LaphyB/senior-project/Documentation/IdeaFest/IMG_0757.jpg

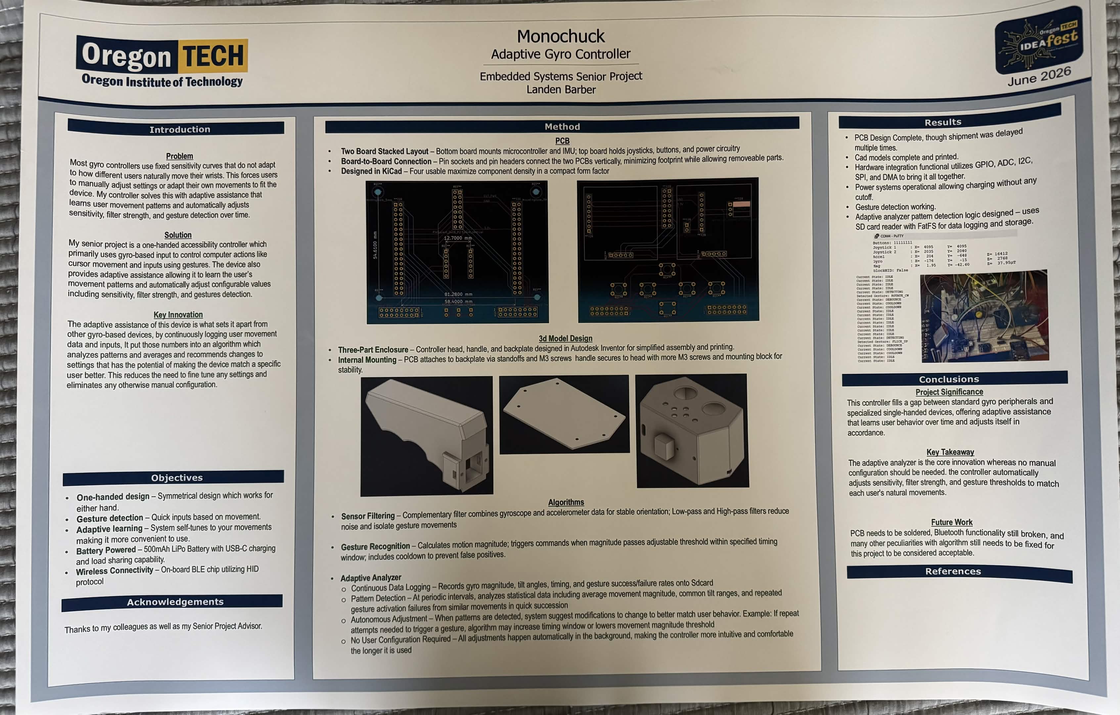
Documentation/IdeaFest/IMG_0757.jpg
