LaphyB/senior-project/README.md

# senior-project
Adaptive One-Handed Gyro Controller
