LaphyB/senior-project/Documentation/Requirements/Comparison Matrices.docx

## Comparison Matrices / Parts List

See Appendix A: Bill of Materials for complete parts list.

### Matrix 1 - Microcontrollers

Name | T-Energy S3 | STM32F411 BlackPill | Feather nRF52840 Express | Nucleo-WB15CC | Nucleo-F446RE
Manufacturer | Lilygo | Adafruit | Adafruit | STMicroelectronics | STMicroelectronics
Clock | 240MHz | 100MHz | 64MHz | 64MHz | 180MHz
Flash/RAM | 16Mb/8Mb | 512Kb/128Kb | 1Mb/256Kb | 320Kb/48Kb | 512Kb/128Kb
GPIOs | ~40 | ~40 | ~21 | ~48 | 50
USB-C | Yes | Yes | No (microUSB) | No (microUSB) | No(which is fine)
microSD | No | No (Yes if SPI) | No (Yes if SPI) | No (or SPI) | No (or SPI)
Wireless | Yes (2.4GHz) | No | Yes | Yes (2.4GHz) | No
Other | Integrated Rechargeable Battery | SOIC-flash memory ship support, No debugger | Built in LiPo charging circuit. | Built in debugger, well documented | Built in Debugger, well documented
Price | ≈ $10 | $29.95 | $24.95 | $35.60 | $14.85

This matrix compares several possible boards that could work for my project, whereas each board brings different inherent features. It is important to choose a board that has a balance of both size and functionality to remain as cheap as possible while having a safe amount of wiggle room for development. The T-Energy S3 is a board that has a battery attached though it has little to no documentation. The STM32F411 Black Pill is a simple board that doesn’t have much functionality but is easy to expand through the many GPIO ports, it does not have a debugger. The Feather nRF52840 Express is a good choice because it has built in LiPo charging as well as Bluetooth and a good amount of storage, though it has few GPIO pins which may limit functionality. The Nucleo-WB15CC is an STM board that includes base features like a debugger and Bluetooth built in, and enough SPI ports to expand on its small memory. I also have the Nucleo-F446RE board which is cheaper than the WB15CC with a faster clock and more interfaces to communicate with, but has a higher draw and does not feature a Bluetooth module inherently. At present the Nucleo-WB15CC board is the most well fit as external modules can be used to solve the battery power functionality and does not need an external Bluetooth module, the only problem is its size.

### Matrix 2 - Joysticks

Name | Analog 2-axis Thumb Joystick with Select Button + Breakout Board | Gravity: Joystick Module | Thumb Joystick
Manufacturer | Adafruit | DFRobot | Sparkfun
Voltage | Up to 5V | 5V | 3V
Control Pins | 3 | 1 | 3
Require ADC | Yes (2) | No | Yes
IC | Yes | Yes | No
Price | $5.95 | $5.30 | $5.25

This matrix highlights some possible thumb joysticks that could be used in the controller. The Analog 2 axis by Adafruit is one that comes with a breakout board allowing you to easily access its 2 axis control pins through a board’s ADC and one for the select button when you press it down. The gravity joystick is different in that it uses digital outputs not requiring and ADC to access. The third thumb joystick does not come with a breakout board which gives it a smaller profile and can run at a smaller voltage.

### Matrix 3 - BLEs

Name | Bluefruit LE SPI Friend | Bluefruit LE UART Friend
Manufacturer | Adafruit | Adafruit
Connection Type | SPI | UART
Other | Good documentation | Good documentation
Price | $17.50 | $17.50

This matrix compares some external Bluetooth modules that could be used to add wireless functionality to a board if it is limiting or excluded. The only difference between the Bluefruit SPI and Bluefruit UART is the connection type allowing either SPI or UART interface depending on the chosen IC.

### Matrix 4 - Haptic motors

Name | Mini Vibration Motors DC 3V 12000rpm Flat Coin Button-Type | Coreless Vibration Motors | DRV2605L Haptic Motor Controller
Manufacturer | Tatako | Zard zoop | Adafruit
Voltage | 1-5V | 1-6V | 3-5V
Control Pins | VCC, GND | VCC, GND | I2C
Size | 10mm x 3mm | 7mm x 25mm | 25.8mm x 17.8mm
Amount | 20pc | 6pc | 1
Price | $13.69 | $9.99 | 7.95

These are some choices for the haptic motor. The first two in this matrix don’t have specific names but the main difference between these two are the shape, whereas one is shaped like a coin and the other like a small rod. They are driven primarily by analog through the voltage given to it, different voltages will make it vibrate at higher frequencies. The DRV2605L on the other hand is a haptic motor that includes an IC controller so as to add more control over the motor rather than just controlling the voltage output. It connects to an I2C on a microcontroller and can handle more complex commands, allowing the motor to be controlled much more consistently. At present the 6 pack is the one being considered for its cheaper price.

### Matrix 5 - Charger Circuits

Name | PowerBoost 500C | PowerBoost 1000C | Sparkfun 5v LiPo Charger
Manufacturer | Adafruit | Adafruit | Sparkfun
Charge rate | 500mA | 1000mA | 500mA
Output | 500mA 5.2v | 1000mA 5.2v | 1000 mA 5v
Battery Protection | No | No | No
Price | $14.95 | $19.95 | 18.50

This matrix compares some possible charging circuit IC’s that could be used in order to supplement a microcontroller that does not inherently have one built in. These will work to power the board through the USB-C connector while simultaneously charging the battery, if the USB-C is disconnected, it will instead use the battery to power the board. Both the PowerBoost 500C and 1000C models could work because they have built in voltage boosters that allow a 3.7v battery to output 5.2v consistently. The difference is the amperage that it can charge or withdrawal from the battery connected through a LiPo port, ultimately charging at different speeds for a price difference. The Spark fun charger is similar but charges slower for a more stable output of one amp, it is also slightly smaller. The PowerBoost 1000c is the best fit because of the fast charging and an output of 5.2v, it is also the same brand as the chosen usb-c breakout board and is also more compatible with its voltage requirements.
