LaphyB/senior-project/Documentation/Requirements/New Requirements.docx

## Requirements

### 1. The controller shall support full operation with one hand.

One of the main features of the project is that it is one handed. Requires everything to be designed with this in mind.

#### 1a. The controller shall have a symmetrical layout to accommodate left- or right-handed use.

In order to accommodate an ambidextrous design, buttons, analog sticks, and casing design will have to be designed in a symmetric fashion.

### 2. The controller shall use gyroscopic data as its main input.

As this is a gyroscopic focused controller, th gyroscope should be the main source of input and everything needs to be designed around that as a core idea.

#### 2a The controller shall allow the gyroscope to be used as a mouse.

The movement of the gyroscope and orientation of the controller could be used to move the mouse for general use. A button should be added to allow for orientation pausing to allow for readjustment and movement not related to mouse input.

#### 2b. The controller shall support gestures using the on-board gyro and accelerometer.

To add another layer of input and accessibility, the movement of the controller should be considered and allow for gestures and movement to be a viable option of control over the system.

### 3. The controller shall monitor input and subtly change settings and suggest changes based on input history.

This adaptive helper will be implemented in software and slowly adjust settings over time, making the controller more intuitive and comfortable to use for specific users.

### 4. The controller shall include a software overlay to allow configuration.

An overlay like this is necessary to allow users to customize the functionality of the controller, including but not limited to key bind mapping, managing profiles, and changing settings. These things allow the controller to have critical flexibility for many use cases.

#### 4a. The controller shall have an inbuilt digital keyboard.

To allow for better general use, a digital keyboard will be built into the system overlay so that you could easily type using the joysticks and buttons.

### 5. The controller shall allow switching between different user-made profiles for different scenarios.

In order to support even more use cases, users will be able to create, save, and switch between different key profiles that may be used in different contexts, or different users.

### 6. All physical buttons and combinations shall be remappable via the system overlay.

To allow the most amount of usability and settings changes, users should be able to remap any physical button or joystick in order to adapt to individual needs and specific uses.

#### 6a. Buttons shall have settings to change base functionality.

Buttons will have various settings to help get the desired functionality of the user, for example some settings would be Hold for rapid press, hold for toggle, adjust button bounce strength, and have the ability to adjust timings. Helps with accessibility

### 7. The controller should be able to have any of the io functionality disabled.

For better customization and comfort any of the io interfaces, haptics, gyro, or features can be disabled to allow fr less error in making inputs.

### 8. The controller shall include a rechargeable battery enabling USB-C charging.

In order to support wireless functionality, a rechargeable battery will be essential for long term use and universal compatibility with USB-C cables for charging.

#### 8a. The controller shall include a battery level indicator via LEDs.

A visual indicator of the battery level ensures that users will know when the device will need to be charged. This will additionally show when the device is on or off.

#### 8b. The controller shall enter sleep mode after a time to save battery life.

To conserve battery life and health, the controller will automatically detect inactivity and enter a low power mode and wait for the user to come back. After further inactivity the controller will then shut off.

#### 8c. The controller shall last more than 8 hours of constant use, and at least 24 hours in sleep mode.

Battery life numbers to aim for to ensure a long use time.

While using, 500mAh Battery / 10mA draw average = 50 hours

Sleep mode, 500mAh Battery / <1mA draw average = 500 hours

STMicroelectronics. (n.d.). NUCLEO-WB15CC: STM32 Nucleo-64 development board. STMicroelectronics. Retrieved November 16, 2025, from https://www.st.com/en/evaluation-tools/nucleo-wb15cc.html

### 9. The controller shall be able to save, and load created profiles and settings from local storage.

To support requirement number 7, the controller will need a internal non-volatile storage in order to store and retrieve profiles and settings.

### 10. The controller shall support Bluetooth for wireless connections up to 5 meters.

To ensure compatibility with a wider range of devices, and for ease of use, Bluetooth functionality will be incorporated, offering wireless communication and may be essential for some with less mobility. Board uses 2.4GHz BLE.

STMicroelectronics. (n.d.). NUCLEO-WB15CC: STM32 Nucleo-64 development board. STMicroelectronics. Retrieved November 16, 2025, from https://www.st.com/en/evaluation-tools/nucleo-wb15cc.html

#### 10a. The controller shall automatically reconnect to the most recently paired device when powered on.

Also for ease of use, the controller will automatically detect and connect to the most recently paired device upon startup. This eliminated the need for users to manually reconnect every time the controller would be used streamlining the process.

#### 10b. The controller shall have usb-c compatibility when Bluetooth fails.

To account for hardware faults or for use when charging, the controller should be able to operate through USB-C connection alone, especially alongside being charged.

#### 10c. The controller shall have a pairing mode when holding a button.

This is standard for most controllers, as including a pairing mode via holding a button will allow the user to quickly and simply pair it to a device for Bluetooth communication.

### 11. The controller shall include haptic feedback.

In order to provide more functionality and more immersive experiences similar to a standard controller, an internal vibration motor will be included.

### 12. The controller shall survive a 2-meter fall and remain fully functional.

The controller must be built to withstand accidental drops and still be completely functional. This durability requirement is essential for long term usability, particularly for those with limited grip strength.

##### 12a. The controller will include a hand strap.

This addition will prevent the controller from reducing the risk of the controller slipping out of the user’s hand and breaking, this feature helps those with less grip strength and allows others to have a better grip over the controller.

### 13. The controller shall boot and be ready to use in under 3 seconds.

Quick startup is imperative for the user experience as they should not need to wait on the controller to use it. The controller must be able to load up a default profile and connect to a device upon startup and initialization. Board documentation claims full startup with BLE stack at 20-50ms.

STMicroelectronics. (n.d.). NUCLEO-WB15CC: STM32 Nucleo-64 development board. STMicroelectronics. Retrieved November 16, 2025, from https://www.st.com/en/evaluation-tools/nucleo-wb15cc.html

### 14. The controller should have less than 15ms response time for a wired connection, and less than 45ms response time for a Bluetooth connection.

For a streamlined user experience, we don’t want to have too much delay after you press a button. These numbers are based off of these sources explaining what input lag should be expected from a controller for optimal performance.

Intel. (n.d.). How to fix input lag. https://www.intel.com/content/www/us/en/gaming/resources/how-to-fix-input-lag.html

Ableton. (n.d.). Bluetooth headphones and latency in Note. https://help.ableton.com/hc/en-us/articles/6130134332188-Bluetooth-Headphones-and-Latency-in-Note
