LaphyB/senior-project/Documentation/Requirements/Requirements.docx

## Requirements

### Critical Requirements

#### 1. The controller shall support full operation with one hand.

This is the core purpose of this project as the controller is meant for individuals who may not have full use of both hands. If the controller cannot be comfortable and intuitive when used with one hand of either orientation, then the device has failed its primary objective.

To validate this requirement, I will ask various classmates and friends to simulate using the device with one hand and having them complete tasks as to receive their feedback.

#### 2. The controller shall be highly customizable.

This is important for expanding on the use cases of the controller and allow those he need slight adjustments to have easy access to how the controller works for them.

For validation, settings could be tested live to make sure that they are working on the fly and as intended.

#### 3. The system shall include an overlay for configuration and troubleshooting.

An overlay like this is necessary to allow users to customize the functionality of the controller, including but not limited to key bind mapping, managing profiles, and changing settings. These things allow the controller to have critical flexibility for many use cases.

To validate this requirement, the overlay should be opened on multiple systems to test whether it has full functionality in changing settings on a variety of devices.

##### 3a. The controller shall have an inbuilt digital keyboard.

To allow for better general use, a digital keyboard will be built into the system overlay so that you could easily type using the joysticks and buttons.

##### 3b. The controller shall monitor input and subtly change settings and suggest changes based on input history.

To take further advantage of the onboard settings and adaptability, the controller will monitor the inputs of the user and suggest changes based on a usage heatmap, and input history.

#### 4. The controller shall support various platforms including Windows, Xbox, and PlayStation.

The ultimate goal of this project is to be as versatile as possible without the use of third-party software. And to accomplish this, the controller will need to be natively compatible with various common systems in order to maximize usability and prevent it from being limited to a single ecosystem.

To verify this, the controller should be able to connect and communicate with a variety of systems and test its functionality as an input device.

### Design and User Interface

#### 5. The controller shall include a modular backplate for left- or right-handed use.

To support a wider range of users, the controller will be designed with this feature in mind to ensure the controller can comfortably fit a variety of hand sizes on either orientation. The backplate must be attached securely and align with internal components to allow both functionality and comfort.

##### 5a. The controller shall have a symmetrical layout to accommodate left- or right-handed use.

In order to accommodate an ambidextrous design, buttons, triggers, and analog sticks will have to be designed in a symmetric fashion.

#### 6. The controller shall include tactile markers to help distinguish similar-feeling buttons.

This is a feature that is small but can have a considerable difference for ease of use and would decrease the likelihood of making input errors.

#### 7. The controller shall allow switching between different user-made profiles for different scenarios.

In order to support even more use cases, users will be able to create, save, and switch between different key profiles that may be used in different contexts.

##### 7a. The controller automatically switches between profiles when switching contexts.

To make the controller more usable, the controller will automatically detect applications and switch to the appropriate profile rather than forcing the user to do it manually.

#### 8. All physical buttons and combinations shall be remappable via the system overlay.

To allow the most amount of usability, users should be able to remap any physical button or joystick in order to adapt to individual needs and specific uses.

##### 8a. Buttons shall have settings to change base functionality.

Buttons will have various settings to help get the desired functionality of the user, for example some settings would be Hold for rapid press, hold for toggle, adjust button bounce strength, and have the ability to adjust timings.

#### 9. The controller should be able to have any of the io functionality disabled.

For better customization and comfort any of the io interfaces, haptics, gyro, or features can be disabled to allow fr less error in making inputs.

#### 10. The controller shall support integrated chorded input.

As the controller will undoubtedly have limited physical buttons due to size constraints, this will allow for much more input versatility which is crucial for one handed support.

##### 10a. The controller shall include a button to either toggle or enable chorded input when pressed.

This feature will allow the user to more easily use chorded input alongside standard input, maximizing the number of usable buttons. Choosing between toggle and hold would be done within the system overlay.

#### 11. The controller shall have custom macro support.

To make more advanced sequences of button presses more usable, macros can be recorded and edited within the system overlay. These macros can be bound to different buttons or gestures for easy activation.

#### 12. The controller shall support gestures using the on-board gyro and accelerometer.

To add another layer of input and accessibility, the movement of the controller should be considered and allow for gestures and movement to be a viable option of control over the system.

##### 12a The controller shall allow the gyroscope to be used as a mouse.

The movement of the gyroscope and orientation of the controller could be used to move the mouse for general use. A button should be added to allow for orientation pausing to allow for readjustment and movement not related to mouse input.

##### 12b The controller shall allow gestures to be mixed and matched in the settings.

Gestures will be supported with deep settings support to allow for some gestures while ignoring other. You should also be able to change the sensitivity, speed, and tremor/haptic filters.

### Functionalities and Operational Conditions

#### 13. The controller shall include a rechargeable battery enabling USB-C charging.

In order to support wireless functionality, a rechargeable battery will be essential for long term use and universal compatibility with USB-C cables for charging.

##### 13a. The controller shall include a battery level indicator via LEDs.

A visual indicator of the battery level ensures that users will know when the device will need to be charged. This will additionally show when the device is on or off.

##### 13b. The controller shall enter sleep mode after a time to save battery life.

To conserve battery life and health, the controller will automatically detect inactivity and enter a low power mode and wait for the user to come back. After further inactivity the controller will then shut off.

##### 13c. The controller shall last more than 8 hours of constant use, and at least 24 hours in sleep mode.

Battery life numbers to aim for to ensure a long use time.

While using, 500mAh Battery / 10mA draw average = 50 hours

Sleep mode, 500mAh Battery / <1mA draw average = 500 hours

STMicroelectronics. (n.d.). NUCLEO-WB15CC: STM32 Nucleo-64 development board. STMicroelectronics. Retrieved November 16, 2025, from https://www.st.com/en/evaluation-tools/nucleo-wb15cc.html

#### 14. The controller shall be able to save, and load created profiles and settings from local storage.

To support requirement number 7, the controller will need a internal non-volatile storage in order to store and retrieve profiles and settings.

#### 15. The controller shall support Bluetooth for wireless connections up to 5 meters.

To ensure compatibility with a wider range of devices, and for ease of use, Bluetooth functionality will be incorporated, offering wireless communication and may be essential for some with less mobility. Board uses 2.4GHz BLE.

STMicroelectronics. (n.d.). NUCLEO-WB15CC: STM32 Nucleo-64 development board. STMicroelectronics. Retrieved November 16, 2025, from https://www.st.com/en/evaluation-tools/nucleo-wb15cc.html

##### 15a. The controller shall automatically reconnect to the most recently paired device when powered on.

Also for ease of use, the controller will automatically detect and connect to the most recently paired device upon startup. This eliminated the need for users to manually reconnect every time the controller would be used streamlining the process.

##### 15b. The controller shall have usb-c compatibility when Bluetooth fails.

To account for hardware faults or for use when charging, the controller should be able to operate through USB-C connection alone, especially alongside being charged.

##### 15c. The controller shall have a pairing mode when holding a button.

This is standard for most controllers, as including a pairing mode via holding a button will allow the user to quickly and simply pair it to a device for Bluetooth communication.

#### 16. The controller shall include haptic feedback.

In order to provide more functionality and more immersive experiences similar to a standard controller, an internal vibration motor will be included.

##### 16c. The controller shall have a pairing mode when holding a button.

Haptic feedback will be able to be configured in the system overlay to allow for changes in haptic patterns and strength.

#### 17. The controller shall include a gyroscope.

To provide more functionality and another way to input data into the controller, the orientation of the device could be used to allow gesture commands to do basic tasks as another way to input. Directly related to requirement 12.

#### 18. The controller shall survive a 2-meter fall and remain fully functional.

The controller must be built to withstand accidental drops and still be completely functional. This durability requirement is essential for long term usability, particularly for those with limited grip strength.

##### 18a. The controller will include a hand strap.

This addition will prevent the controller from reducing the risk of the controller slipping out of the user’s hand and breaking, this feature helps those with less grip strength and allows others to have a better grip over the controller.

#### 19. The controller shall boot and be ready to use in under 3 seconds.

Quick startup is imperative for the user experience as they should not need to wait on the controller to use it. The controller must be able to load up a default profile and connect to a device upon startup and initialization. Board documentation claims full startup with BLE stack at 20-50ms.

STMicroelectronics. (n.d.). NUCLEO-WB15CC: STM32 Nucleo-64 development board. STMicroelectronics. Retrieved November 16, 2025, from https://www.st.com/en/evaluation-tools/nucleo-wb15cc.html

#### 20. The controller should have less than 15ms response time for a wired connection, and less than 45ms response time for a Bluetooth connection.

For a streamlined user experience, we don’t want to have too much delay after you press a button. These numbers are based off of these sources explaining what input lag should be expected from a controller for optimal performance.

Intel. (n.d.). How to fix input lag. https://www.intel.com/content/www/us/en/gaming/resources/how-to-fix-input-lag.html

Ableton. (n.d.). Bluetooth headphones and latency in Note. https://help.ableton.com/hc/en-us/articles/6130134332188-Bluetooth-Headphones-and-Latency-in-Note
