LaphyB/senior-project/Documentation/Deliverables/Critical Design Discussion/Critical Design Discussion Script.rtf

1
Hello, this is my critical design presentation for senior project.

2
My project is a one-handed accessibility controller which primarily uses gyro-based input to control things like cursor movement and inputting gestures.
These cursor movements and actions are triggered through natural motions like tilting rotating, or flicks. By mapping these movements into actions, it allows those with less fine motor control to activate buttons or macros that would otherwise be difficult to press on the smaller buttons.
From the rough drawing on the right, you can see that the controller will be of a vertical format and will be symmetrical so as to support left or right-handed use.
To help configure a device, the device will also provide adaptive assistance allowing it to learn the user’s movement patterns and automatically adjust sensitivity, filter strengths, and gestures. These types of adjustment will make the controller more convenient to use as it improves the one-handed comfort and be more reliable over time.
Though if you also want to change some of these settings yourself, there will also be an on screen overlay to customize button mappings and other settings to the user’s preference.

3
Going right into the hardware, there are a few big things that need to be considered for the initial design of the controller, including battery charging and Bluetooth functionality as the controller should be wireless.
The microcontroller that I chose was the STM32 Nucleo-WB15CC because of its built in Bluetooth chip and low power functionality.
To add on the battery and charging functionality, parts like a usb-c breakout board and power boost 1000c charging circuit were chosen for its ability to automatically switch between exterior power supply or battery supply for continuous use, and its ability to boost a 3.7v battery to 5v to power the board.
The gyro I will be using is the TDK invensense ICM -20948 for its combined gyroscope, accelerometer, and magnetometer, being able to communicate that data through I2C or SPI connections.
Lastly these are of course joysticks, buttons, and haptic motors to supplement the basic functionality of a controller, and a status led to show the power status of the controller.

4
Here I have a circuit diagram to show the layout of how things will be wired up. At the top half of the diagram is the power circuit which starts with the USB-C breakout board allowing data and power lines to be split up and fed into the MCU and charging circuit respectively.
The Nucleo-WB15CC itself has plenty of GPIO pins that I can use for various buttons and control pins, 10 of which have ADC capability which is more than enough for the axial inputs of the joysticks.

5
Regrettably I still don’t have any CAD drawing yet, part of the reason for this is because I don’t really know where to start on a more complex shape like this, but something I decided to do recently is create a 2 layered PCB for the internals to connect the internal parts together. Once I have this interior part designed generally with more precise measurements, it will be much easier to design the casing of the controller which will use a curvier design for ergonomics

6
Now onto the software design aspect of this project, the basic flow of the data starts with some input managers which each read or receive data from various different input methods such as GPIO, ADC, and I2C will each need different implementations to read from.
The Gyro Manager, for example, needs to handle the I2C communication. It also needs to choose and apply various filters on the gyroscopic data so that it is more usable with regards to different sensitivity modes and gesture detection. I will go over the gesture filters a little more in a later slide.
But after this input data is collected and filtered. It is then processed in an input decoder to allow combinational logic and utilize profile settings like key binds to know which outputs need to be sent to a connected device.
It does this by using a communications manager to recognize which protocol to use when sending data, whether its to send it over a Bluetooth connection or if its connected via usb-c

7
And for the other functions of the device, there will be an overlay interface which provides the functionality for editors for different settings.
The overlay stores these settings in an SQLite database for nonvolatile storage,
And the profile selector uses these saved settings from the database to change certain parameters and key binds depending on the context.
Another use of the database is to store input history data collected by the adaptive helper function in order to run calculations on that data to figure out what kind of changes should happen.

8
To help give you a better understanding of what the gyro’s role in input has, here are some of the algorithms that it may use.
One of the important functions of the gyro will be the ability to recognize which filters to use and when a gesture is trying to be activated. The gyro algorithm will start by using the magnitude to adaptively switch between low sensitivity and high sens modes to differentiate between when the user is trying to use precise movement to press something of a screen, quicker movement when trying to move the cursor further distances, and faster movement when the user is trying to activate a gesture.
Some filters that help in these implementations is the LPF which eliminates smaller discrepancies, a complementary filter which uses multiple gyro inputs to smooth movement and got more precise tracking. And high pass filters which are useful in tracking sudden changes like gestures.

9
The adaptive helper also requires an algorithm which can somehow utilize data and convert it into action. It would start by collecting an input history in the database where it can use that data later to calculate average magnitudes, common tilt angles, and timing between presses.
Using these number the controller can predict when a movement is trying to activate something like a gesture but misses because it was not fast enough, if it happens somewhat often, it will increase the interval that a gesture needs to activate to hopefully reduce the likelihood of this mistake happening again.

10
Here are a few basic libraries I expect to use for this project, like the STM32 Hal commands for GPIO, ADC, and I2C communication. STM32 middleware for the Bluetooth stack, or usb communication. And drivers for the gyroscope to format data properly and know which memory locations to read from.

11
And as far as progress goes, regrettably, I haven’t gotten too far into the testing yet, though some things I have done was get the board programmed to work with its GPIO pins and I2C communication, even if I haven’t yet gotten correct data from the gyro yet. and have tested the basic charging functionality to charge the battery and make sure it can properly output power at 5v.

12
Here are just some resources for some datasheets and algorithms.

13
And that’s all I have, any questions?

How much storage on device?
320KB flash
