LaphyB/senior-project/Documentation/Deliverables/Design Review/Design Review Script.docx

Slide 1

Hello, welcome to my presentation on my senior project idea and design. Through this presentation I hope to give you a better understanding of what my project idea is and the goals I hope to accomplish by working on it. I will start by going through a brief introduction to the project, estimating the costs, and comparing it with other products that exist on the market already. I will then talk about the hierarchy of my design and talk more in detail about the features it should have as well as the components I chose to accomplish them. I will then finish off by talking about my progress so far and what my next steps will be.

Slide 2

First of all, my project is a one-handed accessibility controller designed to provide more input options and accessible control over any other controller on the market. What makes this controller special will be the highly customizable nature and vertical form factor that other controller producing companies leave nearly untouched. It will also be compatible with various systems without the need for installed software, other than the companion app to change settings.

Slide 3

To start off with the details of this project, here is a list of components and the total cost of them combined. These are the most important parts of the project and will cost around $118.63 excluding shipping. I will talk a little more about these parts and the features they give later.

Slide 4

Some other costs that may come into play relate to non-recurring costs, prototyping specific, and production related costs. I estimate that the 3d printed prototypes will cost around 150 dollars. I assume that it will take 100 hours to develop, and with a rate of 25 dollars an hour than totals up to 2500 dollars. I expect to need 14 molds in order to make a single product, at 3000 per mold that comes to 42000 dollars total. And if it takes 1 and a half hours to make a product from a laborer making 18 dollars an hour, it will cost 27 dollars. In total divided by the creation of 1000 units of product each controller would cost around 190.27. Compared to other products on the market, this price is actually reasonable as the ones that I have found go well above 200 dollars.

Slide 5

One such product is this Azeron controller, which is an accessibility controller meant for people with one hand. Though on paper this is similar to my project, there are some big differences. One big one is the form factor, as azeron acts more like a mouse than a gamepad, forcing the product to work exclusively on computers rather than game consoles. A common price for a product like this is around $220

Slide 6

Another similar product is the Twiddler, though it is a one-handed device, it is not purpose built for accessibility, rather it is built to be a one-handed chorded keyboard intended for typing speed and is not ambidextrous. Coming in at 229 dollars, this product both reaches a completely different market and costs more than what my controller would cost.

Slide 7

The last comparison I will make are these 3d printed addons that could be added to a game controller. These are usually more mechanically advanced and are cornered by the software meant for the gamepad controller. These can come at a good price even if you do not own a 3d printer, and are the cheapest you could get for a one handed controller.

Slide 8

Now to start going over the design of the project I will start at the top level. Though it may be a little hard to see, this is the top-level diagram that includes both hardware and software components. I have it split up into two parts so I will start at the bottom 3 quarters which defines the controller portion which incorporates the board as well as all the parts that would be held within the controller housing. These are all the things that the controller would need to operate independently.

On the top quarter I have the companion app which is intended to be used to change any number of settings, or key binds when plugged into a computer.

Slide 9

Here is the block diagram that explains the software side of this project. Starting at the bottom, I have various input managers to test for inputs from the many buttons, joysticks, and even one dedicated to the gyroscope/accelerometer. Each input has different requirements to read from, the joysticks for example need ADC inputs while the gyro uses internal ADC’s that transmit to a digital input to the board. The controller also utilizes a profile selector to recognize connected software and systems and exchange key binds and settings that would be configured to the user’s preference. The last notable piece I will mention is that both the app and controller use a communication manager to know how to communicate with a system they are connected to and also switch between either a Bluetooth or USB-C connection depending on the circumstance.

Slide 10

Lastly here is the block diagram for the hardware, starting at the top is the USB-C connector board, this splits the data and power lines in order to allow the functionality to play thorough the cord while charging, or wirelessly when on battery power. The data lines of course would go to the board while the power lines would enter the charging circuit that shares the load between the microcontroller and the battery, enabling it to charge while in use. When disconnected from the cable though, the controller would be powered by the battery and would be boosted up to 5 volts for the board to have enough power. That was the most notable piece to mention but I will also point to how the board will control all the other modules like the haptic motors, gyro, and even the led indicator, which can tell the battery life remaining by the voltage it receives or by another cable that the circuit can output.

Slide 11

When we put all these pieces together, this is what it will generally look like, though some things are subject to change, I have put some thought into how it should be laid out. For one the handle would be raised above the surface with the buttons to allow for more ergonomics and easier control over the joysticks. The controller is drawn with a right side backplate showcasing the ability to add buttons that could be controlled by the right hand. There is also an adjustable strap that wouldn’t be so long but would be useful for grip. Something not shown though this picture is the layout of the shoulder and trigger buttons on the back.

Slide 12

Now here is a more detailed drawing of the inside layout of the controller featuring a few layers that the components would sit on. The top left drawing holds the base plate which holds various pieces like the microcontroller board and USB-C on the front. To access the backside, there is a hole punched through to give access to the charging circuit, battery, and trigger buttons. Next on the left is a standoff piece that would attach to the base plate and hover atop the board in order to position the buttons and joysticks to keep them secured to the frame. The gyro is also tucked in with the wiring able to flow straight to the microcontroller.

Slide 13

Here is another angle of the controller to help reiterate the kind of functionality to expect. The controller will have 2 analog sticks, 16 remappable buttons including the ones on the backplate. It will also have a gyroscope for orientation control, and haptic feedback. The final product should be within the range of a 4in x 9in design and be able to go past 8 hours of constant use without any issues, even when using Bluetooth from over 5 meters since ease of use and comfort is one of the bigger priorities of the project.

Slide 14

I won’t go too deeply into the requirements in this presentation but I have them listed out here so you could go back and look though them if you wanted, but in the case of what I have designed, many of these requirements are used in reference to the design choices I have made. Of these 3 important requirements, one-handed use is the most important.

Slide 15

These next requirements are those related to the general functionality of the controller, many of which relate to the software portion. Some requirements of note needed for the physical design process include tactile markers, and a modular backplate.

Slide 16

Lastly these are requirements needed for the controller to function or operate in the way that is expected. Most of these were important for the design process but the most important / difficult to implement so far were the addition of Bluetooth, orientation and haptic functionality, and of course having a rechargeable battery while in use.

Slide 17

Now I will delve a little deeper into the reason why I chose the components that I did and why I wanted to do them this way.

Slide 18

To start with the most important decision was choosing which microcontroller to use. This was one of the harder decisions I had to make because it would also affect what other kinds of components I would need to supplement the functionality that I want. For example, some boards would have Bluetooth, some would have an integrated charging circuit, or USB-C on board, and not many were small enough, but few had all four so some compromises had to be made.

Slide 19

Ultimately, I ended up choosing the Nucleo-WB15CC from STM for its inherent Bluetooth functionality and its many gpio pins that would give me plenty of wiggle room for more buttons and other I/O. Something that may be an issue is the dimensions of the board, though if I am clever with the design it should fit into the controller well. Like many current age boards, it does not have inherent USB-C or even an integrated LiPo port, but with SPI and various power rails, other options are available.

Slide 20

In order to cover these short-sightings of the nucleo board, I had to choose other components that would give me the other functionality that I require. Two of these are the addition of a USB-C breakout board and the PowerBoost 1000C to provide the connection and charging functionality I went over earlier.

Slide 21

A component I haven’t really mentioned yet is the choice of the 500mAh LiPo battery, I originally planned on using a 1000mAh battery but because it was both larger, and out of stock, I decided to use the 500mAh battery because it should still hold enough to last for over 8 hours with the low power board I chose. Lastly, I also chose this InvenSense gyro because it was one of the cheaper options for a less important feature, it works for this project though because of its digital output from the onboard ADC’s.

Slide 22

As for software, since I am using a stm board, the stm32cubeIDE is natively supported and is the best choice for this project. For the companion app though I may use VSCode instead since stm is based on eclipse. Of course, I will also be saving all the code onto the GitLab I have already set up.

Slide 23

Now onto the last part of this presentation, being the work I have done so far and my next steps. At the current stage I have done much more discovery and planning of parts that I would need rather than implementing anything. Recently though, I have finally ordered most of the important parts that I would need, and they should arrive within the next few days.

Slide 24

And According to my schedule I am on track and should start preparing to receive these parts once I do, I can begin by setting up the board and using it to test the individual functionality to make sure everything is working as intended. By the start of winter term, I would also like to have started on the driver code and have the parts measured more accurately so that I can get started on the 3d modelling which both tasks will take up most the time in winter term.

Slide 25

Anyway, thank you for listening, I hope that this presentation has helped you to understand what my project will entail and how I will accomplish these goals.
