LaphyB/senior-project/Documentation/Deliverables/Initial Test Plan/Design Progress.docx

Discovered that WB15CC microcontroller is missing usb export pins, even though it has the functionality in the chip. This makes it impossible to control through the usb-c cable. The WB55RG model solves and has the same layout, but instead of buying a new microcontroller I will be using Bluetooth functionality exclusively for connection. Chargin capabilities are unaffected, however.

SQLite is unnecessary, for this project it may be much more ram and storage efficient to store things smaller binary files. Overhead is not necessarily needed and storage is limited, also adds more complexity that is not worth it.

#### Gyro Algorithm

Inputs: Gyroscope data (raw X, Y, Z axis data from ICM20948)

Output: Cursor movement delta (change in x, y pixels), can later be sent using HID over Bluetooth

Usage: The main gyro function which controls the cursor movement of the mouse using the gyroscope.

Function:

- I2C places data into a register automatically.
- Using these values, we first convert it into a usable format (degrees/second) by dividing by sensitivity scale.
- Apply deadzone threshold to discard bad data and reduce drift.
- Apply low pass filter (using alpha value) to smooth jittery movement and reduce noise.
- Apply user configurable sensitivity settings (multiplier to control movement speed).
- Apply mouse acceleration curve for small(1x) or large (2x-3x) movements
- Calculate cursor delta using

dpixels = angular_velocity_dps x time_delta_sec x sensitivity

- Clamp delta values to +-127 pixels as per HID protocol limit
- Package dX and dY into HID mouse report structure
- Send to host PC over bluetooth
- Host receives mouse report and moves cursor by specific xy pixel values.

#### Gesture Recognition

Inputs: Gyroscopic data (angular velocity), Accelerometer data (linear acceleration), Timestamp (ms)

Output: Commands Enum (FLICK_LEFT, FLICK_RIGHT, FLICK_UP, FLICK_DOWN, ROTATE_CW, ROTATE_CCW etc.

Usage: Using ICM data, detect quick movements and detect when a user is trying to activate a gesture.

Function:

- Read data values from gyro register
- Calculate motion magnitudes using

Magnitude = sqrt(gyro_x^2 + gyro_y^2 + gyro_z^2)

- If magnitude exceeds threshold, enter a detecting state, else stay idle
- If detecting, record starting timestamp, track hishest magnitude during time window
- If movement exceeds timeout then return to idle
- When magnitude falls below threshold, end gesture and take note of which axis has the highest values
  - X-axis = for positive, FLICK_LEFT or for negative, FLICK_RIGHT
  - Y-axis = for positive, FLICK_UP or for negative, FLICK_DOWN
  - Z-axis = for positive, ROTATE_CW or for negative, ROTATE_CCW
- Apply cooldown period to prevent double triggers
- Apply debounce period to ignore correcting movement after gesture
- Return gesture type to program for command execution
- If idle, can return GESTURE_NONE

#### Adaptive Analyzer

Input: Historical movement data, current user settings

Output: Commands to adjust system settings

Usage: Function runs periodically to watch values and make decisions to change settings that will make controller more reliable.

Function:

- As data is collected in a buffer file with configurable max amount, contains timestamp, gyro, joystick, button values, and the reason why it was added to buffer (like gesture activated so making note)
- Using previous data
- Calculate success rates and repeated failure rate
  - Calculate gyro magnitudes for all records, divided by num
  - Calculate gesture success rate with gesture attempt flag
  - Count rapid repeated failures if within a short amount of time
- Check to see if changes should be made
  - If magnitude less than threshold, and gesture success rate less than 50%: lower gesture threshold.
  - If gesture threshold less than 30%: increase gesture timeout .
  - If rapid failures in short succession are detected: increase sensitivity and lower gesture threshold.
- Check setting bounds for wanted adjustment
- Check if change is allowed to be made (configurable)
- Apply changes to settings (no reboot needed)
- Add change to change log
