LaphyB/senior-project/Documentation/Deliverables/Other/Updated Proposal.docx

Monochuck

A new form factor to a one-handed controller

Landen Barber

11-25-2025

Oregon Institute of Technology

Approval of Signature

Student

X

Name: Landen Barber

Date :

Project Adviser

X

Name: Ganghee Jang

Date:

# Summary

This document provides a description of my senior project and what it will entail. For my senior project I will design a one-handed accessibility controller aimed at expanding on the limited number of input options that a one-handed controller may have. What makes this controller special will be the highly customizable nature and vertical form factor that other controller producing companies leave nearly untouched. It will also be compatible with various systems without the need for installed software, other than the companion app to change settings. There are a few central challenges to making this type of controller and many things to consider. Alongside the normal challenges like battery life, size constraints and connectivity/support for different applications, a one-handed controller is unique in that the physical number of inputs that can be implemented is cut short. To combat this the controller will feature chorded input to supplement the number of inputs possible and will have a swappable backplate to add more functionality to suit the users preference. Overall, the goal of this project is to have an intuitive one-handed controller that is easily adjustable to a variety of hand sizes and mobile limitations and aims to empower users with limited mobility to providing a device capable of connecting them to their machine.

As the controller will have both chorded input and contextual profile switching, the controller will come with an app to install firmware, remap buttons, change settings, as well as customize profiles in order to better support the adjustability of the controller. These customizable features will be supported with real time visualization of inputs on the app with options to turn off certain inputs or by adding more through swapping different backplates. The controller will also be able to be used either wirelessly or wired with seamless transitions between USB-C and Bluetooth.

Throughout this document I will start by looking at the background of some other popular options for accessibility controllers as well as one that is very similar to my own and explain what makes mine different. I will then describe my timeline as well as the challenges and ways to mitigate and handle them. Finally, I will talk about the requirements that the final product should include.

# Background

Traditionally, controllers are designed for those with full use of both hands. While the standard controller can work for the majority of people, it can provide a barrier to those with disabilities or limited mobility. As Accessibility is becoming a more prominent aspect within technological and gaming spheres, there is a growing need for inclusive and specialized hardware. But, despite efforts by various companies, there remains a limited selection of intuitive, one-handed controllers that are compatible with many applications and games.

There are several previous technologies that have attempted to solve this problem before, but each comes with their own tradeoffs. One approach is the Azeron gaming keypad, which effectively acts like a mouse with finger actuated input. The mouse input on the controller allows for more precise aiming and works well with a computer system, it also comes with extensive customization options. Another approach that is very similar is the Twiddler. The twiddler is a one-handed keyboard that includes chorded input. The biggest problem with this is that it is meant for typing and is primarily meant for use by a tablet or other mobile device via Bluetooth. Both of these products demonstrate different aspects that I would like to bring together in order to create a more suited device toward gaming. There have also been attempts of at home solutions like 3d printed additions to your base controllers that move many of the buttons to one side, though these solutions are usually heavier and more clunky.

# Comparisons with Existing Approaches

## Twiddler

The twiddler is a one-handed chorded keyboard device made by a company called Tek Gear, Inc. While both my project and the Twiddler use chorded input within a one-handed form factor, the purpose and audience for each one differ fundamentally. Twiddler controllers are optimized for entering text quickly and efficiently and are not aimed toward those with disabilities. To lay out all of the differences, Twiddler keyboards have 12 keys, some are remappable while some are not, an optical mouse touchpad, Bluetooth capable, but is not ambidextrous, has no haptic feedback, and is primarily meant for a niche text-entry focused audience. The twiddler is sold for 229 dollars retail and excels at being highly portable and highly programmable. Some weaknesses of this design though it that it has a steep learning curve and is not optimized for general use or accessibility.


## Azeron


Azeron controllers are one-handed programmable gaming keypads designed primarily for PC gamers who want a smoother gaming experience with easily accessed inputs meant for use by those with one hand. This controller has an analog thumb stick, 26 programmable buttons, and an optical mouse sensor. It also has finger actuators to allow another degree of freedom. The strength of this controller is that it excels at general PC use and gaming, as well as being highly customizable to suit a specific purpose. A big downside to this controller though is that since it is more related to keyboards and mice, they are meant to be used mainly for PC’s and are not compatible with many other systems. Another downside of this device is its cost as it sells for around 220$ most likely due to its many moving pieces and actuators.

## 3d Modeled Addons


The simplest and cheapest approach to this need for a one-handed controller is one of the many designs of 3d printed models that could be attached to a normal gamepad controller. These are very low cost and build on the pre-built functionality and software that a normal gamepad has already. These are good options for those with access to a 3d printer, but even if you don’t have a 3d printer they are still easy to find online. Some problems with this design though is that it can be difficult to assemble, and makes the controller more clunky and only adds to the weight of a controller meant for 2 hands.

## Xbox Adaptive Controller

Though not very related to my project, another popular choice for those with disabilities is the Xbox adaptive controller; this is a flat controller that has few buttons but has many inputs. Unlike other controllers, it functions as a brain that many other accessibility devices can be connected to and be used in conjunction with each other by providing an interface for people who are less tech savvy and need to set up multiple devices. This device is one of the strongest for being highly expandable and gives a lot of accessibility support. A big downside of this controller though is that it requires that you have other devices on hand in order to make full use of it, it is also quite big and is not very portable as it should be mounted to something like a desk or a wheelchair.


# Comparison Matrices

## Matrix 1 - Microcontrollers

Name | T-Energy S3 | STM32F411 BlackPill | Feather nRF52840 Express | Nucleo-WB15CC | Nucleo-F446RE
Manufacturer | Lilygo | Adafruit | Adafruit | STMicroelectronics | STMicroelectronics
Clock | 240MHz | 100MHz | 64MHz | 64MHz | 180MHz
Flash/RAM | 16Mb/8Mb | 512Kb/128Kb | 1Mb/256Kb | 320Kb/48Kb | 512Kb/128Kb
GPIOs | ~40 | ~40 | ~21 | ~48 | 50
USB-C | Yes | Yes | No (microUSB) | No (microUSB) | No(which is fine)
microSD | No | No (Yes if SPI) | No (Yes if SPI) | No (or SPI) | No (or SPI)
Wireless | Yes (2.4GHz) | No | Yes | Yes (2.4GHz) | No
Other | Integrated Rechargeable Battery | SOIC-flash memory ship support, No debugger | Built in LiPo charging circuit. | Built in debugger, well documented | Built in Debugger, well documented
Price | ≈ $10 | $29.95 | $24.95 | $35.60 | $14.85

This matrix compares several possible boards that could work for my project, whereas each board brings different inherent features. It is important to choose a board that has a balance of both size and functionality to remain as cheap as possible while having a safe amount of wiggle room for development. The T-Energy S3 is a board that has a battery attached though it has little to no documentation. The STM32F411 Black Pill is a simple board that doesn’t have much functionality but is easy to expand through the many GPIO ports, it does not have a debugger. The Feather nRF52840 Express is a good choice because it has built in LiPo charging as well as Bluetooth and a good amount of storage, though it has few GPIO pins which may limit functionality. The Nucleo-WB15CC is an STM board that includes base features like a debugger and Bluetooth built in, and enough SPI ports to expand on its small memory. I also have the Nucleo-F446RE board which is cheaper than the WB15CC with a faster clock and more interfaces to communicate with, but has a higher draw and does not feature a Bluetooth module inherently. At present the Nucleo-WB15CC board is the most well fit as external modules can be used to solve the battery power functionality and does not need an external Bluetooth module, the only problem is its size.

## Matrix 2 - Joysticks

Name | Analog 2-axis Thumb Joystick with Select Button + Breakout Board | Gravity: Joystick Module | Thumb Joystick
Manufacturer | Adafruit | DFRobot | Sparkfun
Voltage | Up to 5V | 5V | 3V
Control Pins | 3 | 1 | 3
Require ADC | Yes (2) | No | Yes
IC | Yes | Yes | No
Price | $5.95 | $5.30 | $5.25

This matrix highlights some possible thumb joysticks that could be used in the controller. The Analog 2 axis by Adafruit is one that comes with a breakout board allowing you to easily access its 2 axis control pins through a board’s ADC and one for the select button when you press it down. The gravity joystick is different in that it uses digital outputs not requiring and ADC to access. The third thumb joystick does not come with a breakout board which gives it a smaller profile and can run at a smaller voltage.

## Matrix 3 - BLEs

Name | Bluefruit LE SPI Friend | Bluefruit LE UART Friend
Manufacturer | Adafruit | Adafruit
Connection Type | SPI | UART
Other | Good documentation | Good documentation
Price | $17.50 | $17.50

This matrix compares some external Bluetooth modules that could be used to add wireless functionality to a board if it is limiting or excluded. The only difference between the Bluefruit SPI and Bluefruit UART is the connection type allowing either SPI or UART interface depending on the chosen IC.

## Matrix 4 - Haptic motors

Name | Mini Vibration Motors DC 3V 12000rpm Flat Coin Button-Type | Coreless Vibration Motors | DRV2605L Haptic Motor Controller
Manufacturer | Tatako | Zard zoop | Adafruit
Voltage | 1-5V | 1-6V | 3-5V
Control Pins | VCC, GND | VCC, GND | I2C
Size | 10mm x 3mm | 7mm x 25mm | 25.8mm x 17.8mm
Amount | 20pc | 6pc | 1
Price | $13.69 | $9.99 | 7.95

These are some choices for the haptic motor. The first two in this matrix don’t have specific names but the main difference between these two are the shape, whereas one is shaped like a coin and the other like a small rod. They are driven primarily by analog through the voltage given to it, different voltages will make it vibrate at higher frequencies. The DRV2605L on the other hand is a haptic motor that includes an IC controller so as to add more control over the motor rather than just controlling the voltage output. It connects to an I2C on a microcontroller and can handle more complex commands, allowing the motor to be controlled much more consistently. At present the 6 pack is the one being considered for its cheaper price.

## Matrix 5 - Charger Circuits

Name | PowerBoost 500C | PowerBoost 1000C | Sparkfun 5v LiPo Charger
Manufacturer | Adafruit | Adafruit | Sparkfun
Charge rate | 500mA | 1000mA | 500mA
Output | 500mA 5.2v | 1000mA 5.2v | 1000 mA 5v
Battery Protection | No | No | No
Price | $14.95 | $19.95 | 18.50

This matrix compares some possible charging circuit IC’s that could be used in order to supplement a microcontroller that does not inherently have one built in. These will work to power the board through the USB-C connector while simultaneously charging the battery, if the USB-C is disconnected, it will instead use the battery to power the board. Both the PowerBoost 500C and 1000C models could work because they have built in voltage boosters that allow a 3.7v battery to output 5.2v consistently. The difference is the amperage that it can charge or withdrawal from the battery connected through a LiPo port, ultimately charging at different speeds for a price difference. The Spark fun charger is similar but charges slower for a more stable output of one amp, it is also slightly smaller. The PowerBoost 1000c is the best fit because of the fast charging and an output of 5.2v, it is also the same brand as the chosen usb-c breakout board and is also more compatible with its voltage requirements.

# Novelty Statement and Design Goals

(Novelty will be changed to act as a better project, I just don’t have time to think deeply about that before turning this in)

What makes my project novel is the combination of a vertical form factor and compatibility with a variety of systems that other controllers are lacking in. With the addition of chorded input, contextual profile switching, and physical modification though a swappable backplate, this controller emphasizes general usability and accessibility for a broad range of applications.

Unlike tools like the Twiddler, who is meant for typing, and pc focused controllers like Azeron, my controller will have a bigger priority on a wider range of uses on more systems. I think that this approach matters because accessibility controllers are often treated as specialized devices meant for those with disabilities, whether it’s due to injuries or chronic conditions, I think that there is a place for a more fully integrated solution that could be used by a more general audience. Many existing technologies are either too expensive, too complex, or specialized to be used by more than just the intended audience, and by making a controller that is both intuitive and powerful, this project can fill in this gap in the market. Accessibility should not be a subset of devices, but something that should be expected to be supported by a device such as this.

Some design goals for this controller are to make a light device that is comfortable and easy to use with one of the user’s hands. It should be able to mimic normal controllers and their functionality, including features like haptic feedback, orientation detection, and triggers, so as to use expected functionality that these systems can offer. The controller will take these basic features and expand on them to add more utility by allowing chorded input, context switching, macros, and various different settings making the controller easier to use for a wide range of people.

### Design Sketches

The top left drawing holds the interior base plate which holds various pieces like the microcontroller board and USB-C on the front. To access the backside, there is a hole punched through to give access to the charging circuit, battery, and trigger buttons. There is also a standoff piece that would attach to the base plate and hover atop the board in order to position the buttons and joysticks to keep them secured to the frame. The gyro is also tucked in with the wiring able to flow straight to the microcontroller. In the other drawings, you can see how the handle would be raised above the surface with the buttons to allow for more ergonomics and easier control over the joysticks. The controller is drawn with a right side backplate showcasing the ability to add buttons that could be controlled by the right hand. You can also see the adjustable strap to keep the user’s hand stable on the controller. Some other features not mentioned elsewhere is the predicted size of the controller being around 9inx4in in length and width, and general layout of the controller. As described here.

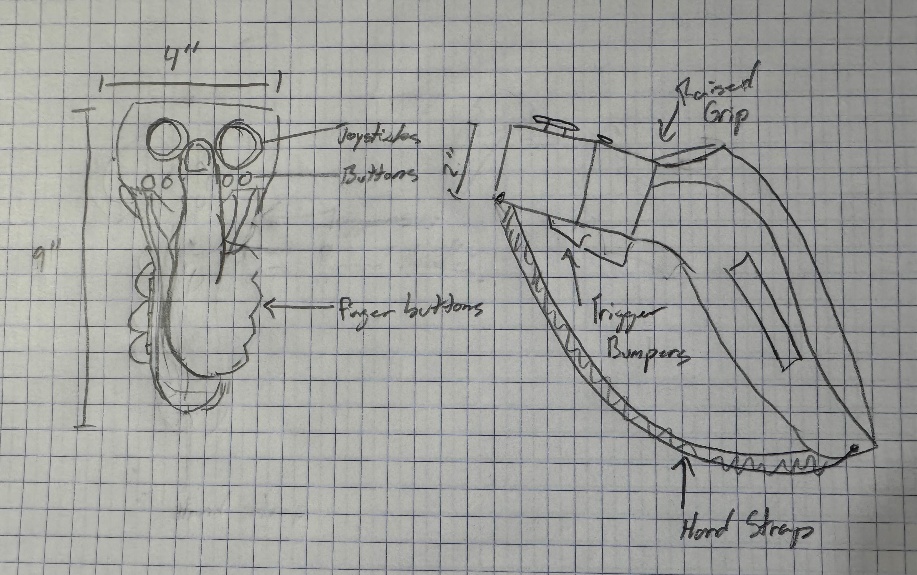
[picture p41: figure]
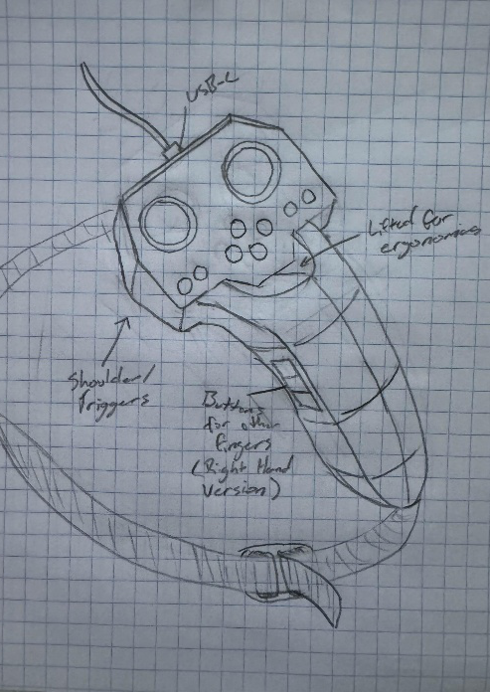
[picture p42: figure]
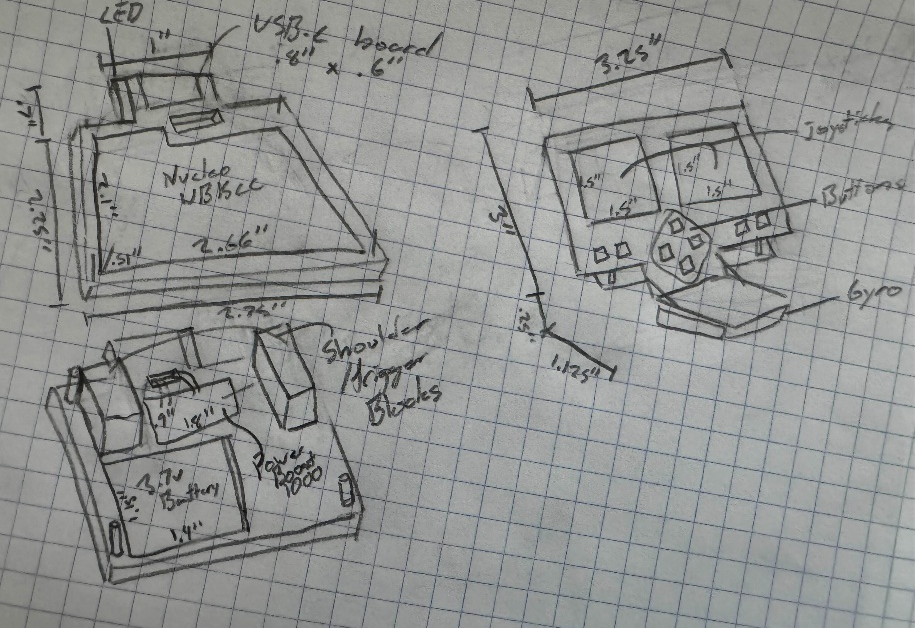
[picture p43: figure]

# Timeline and Deliverables

## Fall Term Timeline

The overall timeline of this project will be to complete it before Idea fest in June 2026. Fall term will be the time to design the project, including specific technology, and initial modelling of the controller for 3d printing. Technologies chosen will have to be carefully planned in order to fit a chosen form factor and have enough stats to run smoothly. After initial planning, parts should be ordered, measured, and tested by the beginning of winter term.


## Winter Term Timeline

Winter term will be spent building, assembling, modelling, and coding. The goal of the term will be to have a working prototype by the end of it. The first few weeks will be primarily spent building the controller and writing the foundational code for the software. Starting with the controller’s driver code and inputs and then moving on to the app and compatibility with a variety of systems. The end of the term will be spent tying everything together and debugging in order to have a working prototype before spring term.


## Spring Term Timeline

Finally, spring term will be spent testing, debugging and documenting. More rigorous testing will be used to help complete the prototype and bring it closer to 100% completion. The final product should be completed by idea fest as it will be presented to the public. Documentation should take place throughout the entire year, but the end of the term will be spent writing the user manual as well as the project documentation to completion.


## Deliverables

### Top Level Diagram

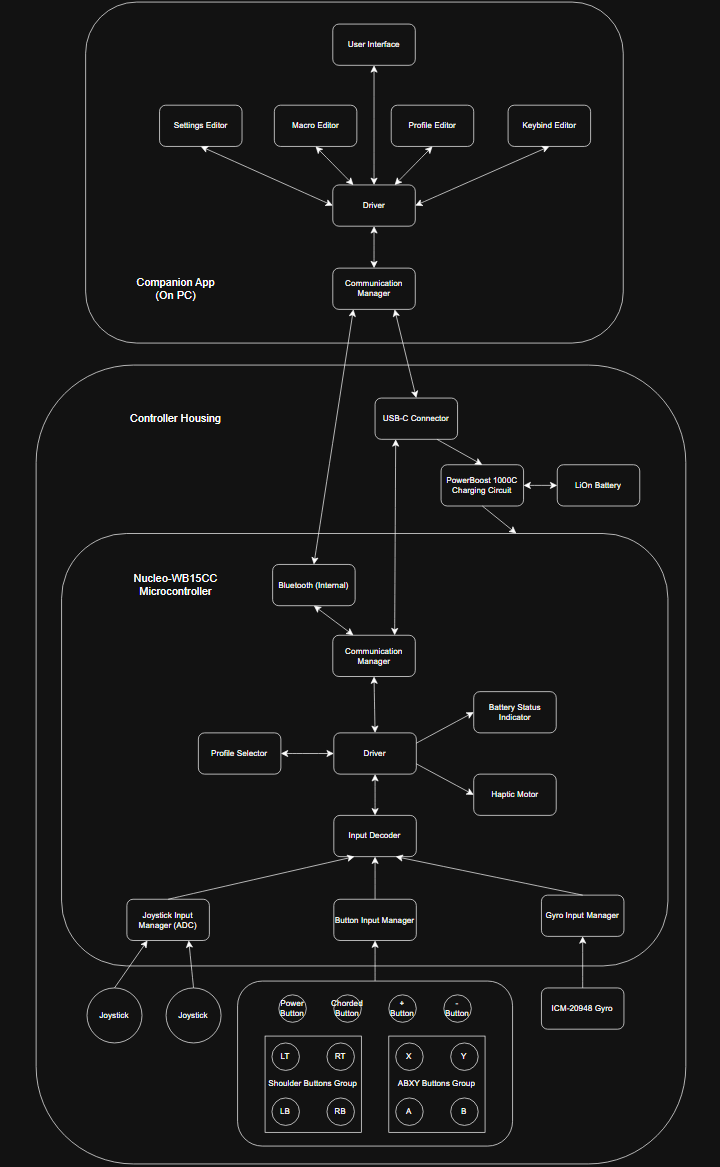
[picture p44: figure]

### Software Diagram

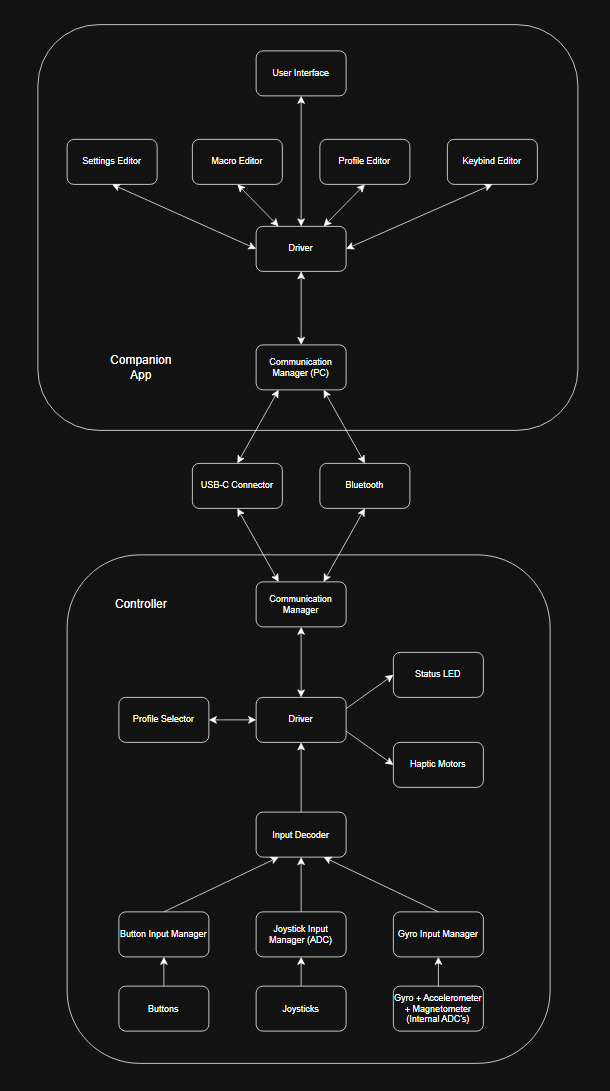
[picture p45: figure]

### Hardware Diagram

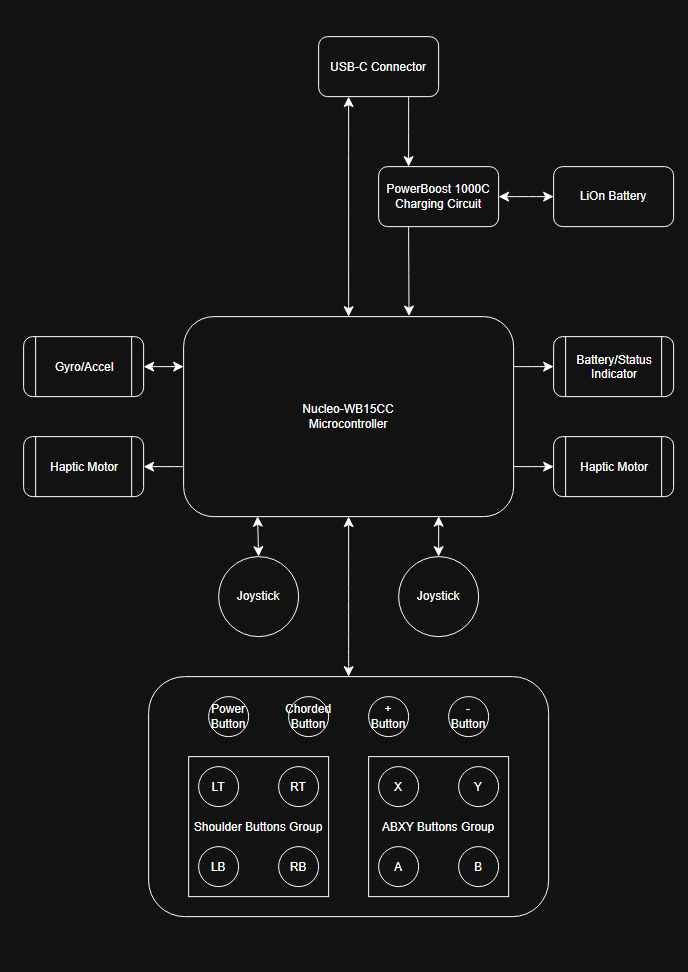
[picture p46: figure]

# Challenges Anticipated and Mitigation Strategies

## Parts availability / not arriving on time

Packages going missing or being delayed may delay the entire project depending on the part that is stuck. In order to prevent this from happening, I will find multiple available sources for a part in order to avoid that point of failure. As I will be ordering to an apartment, I will also keep track of delivery days in order to not have any packages stolen. In case a part is out of stock, I will find a worthy replacement or another seller that may have it.

## 3D model printing issues

In the case of a 3d print not successfully printing due to the design, a bit of reworking will be expected and will be given extra time for within the schedule to sort out these issues. If the issue is because I don’t have anyone to print for me (CSET, or friends), There is still the option to look online for people who will print for me.

## Budget / parts breaking

In the event of unexpected price increases that exceed my budget, I will keep in mind a contingency fund to help cover those costs. I will need to track expenses regularly as well as find lower cost alternatives and secondhand parts if needed.

## Time management

As this is a solo project, balancing the project load with other coursework and other obligations may cause delays, in order to mitigate this, a realistic timeline and goals should be written beforehand to plan for buffers of time. To stay on track, reviewing progress of the project will help adjust any plans as necessary.

## Falling behind on schedule

If I were to fall behind on the schedule, I will need to be open to changing it in order to get the most fundamental features done, prioritizing them, and working on less important features when more time is available, putting more hours than initially planned into the project.

## Unexpected bugs / problems

In the case of problems surfaces through testing and debugging, it will be important to handle these bugs as they occur so as to be able to isolate them more effectively. Bugs who have a lesser impact on the project on a whole will be put into a list of problems that will need to be solved later if time is low.

## Compatibility problems

If compatibility for a system is harder to implement than expected or outright impossible, I will need to implement as much functionality as possible, and see if a slight change in design is possible to add the needed functionality.

# Requirements

## Critical Requirements

### 1. The controller shall support full operation with one hand.

This is the core purpose of this project as the controller is meant for individuals who may not have full use of both hands. If the controller cannot be comfortable and intuitive when used with one hand of either orientation, then the device has failed its primary objective.

To validate this requirement, I will ask various classmates and friends to simulate using the device with one hand and having them complete tasks as to receive their feedback.

### 2. The system shall include a companion app.

A companion app is necessary to allow users to customize the functionality of the controller, including but not limited to key bind mapping, managing profiles, and changing settings. These things allow the controller to have critical flexibility for many use cases.

To validate this requirement, the software should be opened on multiple systems to test whether it has full functionality in changing settings on a variety of devices.

### 3. The controller shall support various platforms including Windows, Xbox, and PlayStation.

The ultimate goal of this project is to be as versatile as possible without the use of third-party software. And to accomplish this, the controller will need to be natively compatible with various common systems in order to maximize usability and prevent it from being limited to a single ecosystem.

To verify this, the controller should be able to connect and communicate with a variety of systems and testing its functionality as an input device.

## Design and User Interface

### 4. The controller shall include a modular backplate for left- or right-handed use.

To support a wider range of users, the controller will be designed with this feature in mind to ensure the controller can comfortably fit a variety of hand sizes on either orientation. The backplate must be attached securely and align with internal components to allow both functionality and comfort.

#### 4a. The controller shall have a symmetrical layout to accommodate left- or right-handed use.

In order to accommodate an ambidextrous design, buttons, triggers, and analog sticks will have to be designed in a symmetric fashion.

### 5. The controller shall support integrated chorded input.

As the controller will undoubtedly have limited physical buttons due to limited mobility, this will allow for much more input versatility which is crucial for one handed support.

#### 5a. The controller shall include a button to either toggle or enable chorded input when pressed.

This feature will allow the user to more easily use chorded input alongside standard input, maximizing the number of usable buttons. Choosing between toggle and hold would be done within the companion app.

### 6. All physical buttons and combinations shall be remappable via the companion app.

To allow the most amount of usability, users should be able to remap any physical button or joystick in order to adapt to individual needs and specific uses.

### 7. The controller shall allow switching between different user-made profiles for different scenarios.

In order to support even more use cases, users will be able to create, save, and switch between different key profiles that may be used in different contexts.

#### 7a. The controller shall automatically switch between profiles when switching contexts.

To make the controller more usable, the controller will automatically detect applications and switch to the appropriate profile rather than forcing the user to do it manually.

### 8. The controller shall include tactile markers to help distinguish similar-feeling buttons.

This is important for any user, especially for individuals who are less able. Tactile buttons would decrease the likelihood of making input errors.

### 9. The controller shall have custom macro support in the app.

To make more advanced sequences of button presses more usable macros can be supported to make them easier to do.

### 10. The controller shall include different hold or toggle modes for buttons.

For those with limited mobility having the option to press multiple times by simply holding a button which will add an added layer of comfort in use.

## Functionalities and Operational Conditions

### 1. The controller shall include a rechargeable battery enabling USB-C charging.

In order to support wireless functionality, a rechargeable battery will be essential for long term use and universal compatibility with USB-C cables for charging.

#### 1a. The controller shall include a battery level indicator via LEDs.

A visual indicator of the battery level ensures that users will know when the device will need to be charged. This will additionally show when the device is on or off.

#### 1b. The controller shall enter sleep mode after a time to save battery life.

To conserve battery life and health, the controller will automatically detect inactivity and enter a low power mode and wait for the user to come back. After further inactivity the controller will then shut off.

#### 1c. The controller shall last more than 8 hours of constant use, and at least 24 hours in sleep mode.

Battery life numbers to aim for to ensure a long use time.

While using, 500mAh Battery / 10mA draw average = 50 hours

Sleep mode, 500mAh Battery / <1mA draw average = 500 hours

STMicroelectronics. (n.d.). NUCLEO-WB15CC: STM32 Nucleo-64 development board. STMicroelectronics. Retrieved November 16, 2025, from https://www.st.com/en/evaluation-tools/nucleo-wb15cc.html

### 2. The controller shall be able to save and load created profiles from local storage.

To support requirement number 8, the controller will need a internal non-volatile storage in order to store and retrieve profiles and settings.

### 3. The controller shall support Bluetooth for wireless connections up to 5 meters.

To ensure compatibility with a wider range of devices, and for ease of use, Bluetooth functionality will be incorporated, offering wireless communication and may be essential for some with less mobility. Board uses 2.4GHz BLE.

STMicroelectronics. (n.d.). NUCLEO-WB15CC: STM32 Nucleo-64 development board. STMicroelectronics. Retrieved November 16, 2025, from https://www.st.com/en/evaluation-tools/nucleo-wb15cc.html

#### 3a. The controller shall automatically reconnect to the most recently paired device when powered on.

Also for ease of use, the controller will automatically detect and connect to the most recently paired device upon startup. This eliminated the need for users to manually reconnect every time the controller would be used streamlining the process.

#### 3b. The controller shall have usb-c compatibility when Bluetooth fails.

To account for hardware faults or for use when charging, the controller should be able to operate through USB-C connection alone, especially alongside being charged.

#### 3c. The controller shall have a pairing mode when holding a button.

This is a standard for most controllers, as including a pairing mode via holding a button will allow the user to quickly and simply pair it to a device for bluetooth communication.

### 4. The controller shall include haptic feedback.

In order to provide more functionality and more immersive experiences similar to a standard controller, an internal vibration motor will be included. This will also be configured in the companion app to adjust strength or to be disabled entirely.

### 5. The controller shall survive a 2-meter fall and remain fully functional.

The controller must be built to withstand accidental drops and still be completely functional. This durability requirement is essential for long term usability, particularly for those with limited grip strength.

#### 5a. The controller will include a hand strap.

This addition will prevent the controller from reducing the risk of the controller slipping out of the user’s hand and breaking, this feature helps those with less grip strength and allows others to have a better grip over the controller.

### 6. The controller shall boot and be ready to use in under 3 seconds.

Quick startup is imperative for the user experience as they should not need to wait on the controller to use it. The controller must be able to load up a default profile and connect to a device upon startup and initialization. Board documentation claims full startup with BLE stack at 20-50ms.

STMicroelectronics. (n.d.). NUCLEO-WB15CC: STM32 Nucleo-64 development board. STMicroelectronics. Retrieved November 16, 2025, from https://www.st.com/en/evaluation-tools/nucleo-wb15cc.html

### 7. The controller should have less than 15ms response time for a wired connection, and less than 45ms response time for a Bluetooth connection.

For a streamlined user experience, we don’t want to have too much delay after you press a button. These numbers are based off of these sources explaining what input lag should be expected from a controller for optimal performance.

Intel. (n.d.). How to fix input lag. https://www.intel.com/content/www/us/en/gaming/resources/how-to-fix-input-lag.html

Ableton. (n.d.). Bluetooth headphones and latency in Note. https://help.ableton.com/hc/en-us/articles/6130134332188-Bluetooth-Headphones-and-Latency-in-Note

### 8. The controller shall include a gyroscope.

To provide more functionality and another way to input data into the controller, the orientation of the device could be used to allow gesture commands to do basic tasks as another way to input.

# Cost Estimation

## Components Cost

Component | Model | Unit Cost | Count | Quantity | Subtotal (per Unit)
Microcontroller | Nucleo-WB15CC | $35.60 | 1 | 1 | $35.60
USB-C Breakout | USB Type C Breakout Board | $2.95 | 1 | 1 | $2.95
Charging Circuit | Power Boost 1000C | $19.95 | 1 | 1 | $19.95
Battery | Lithium-ion battery | $7.95 | 1 | 1 | $7.95
Joysticks | Analog 2-axis thumb joystick | $5.95 | 1 | 2 | $11.90
LED | Rectangular 5mm RGB LEDs | $5.95 | 10 | 1 | $0.59
Buttons | Pushbutton Switch 12mm | $0.75 | 1 | 14 | $10.50
Haptic Motor | Flat coin button type vibrating motor | $9.99 | 6 | 1 | $1.67
Strap | Elastic Strap | $9.99 | 1 | 1 | $9.99
Wire | AWG Wire Solid Core Hookup Wire | $15.49 | 6 | 1 | $2.58
Gyroscope | ICM-20948 | $14.95 | 1 | 1 | $14.95
Misc group (wires, screws) | | $10 | | 1 | $10
3d Models Group | | $15 | | 1 | $15
| | | | Total per Unit | $143.63

## Production Cost

Category | Description | Estimated Cost | Units | Subtotal
Injection molds | 12 Printed Parts x $3000 | $36000.00 | 1000 | $36
Assembly labor | $13/hour x 2hour | $26 | | $26
| | | Total per Unit | $62

## Operational Cost

Cost Type | Description | Subtotal
Staff Labor (Engineering, Marketing, Support) | 3 Staff x $5000/mo / 1000 | $15
Sales, Logistics, Website upkeep | | $30
Marketing & Admin Costs | | $30
| Total per Unit | $75

## Total Cost

Category | Costs
Manufacturing | $143.63 per Unit
Operational Cost | $75
Total cost per unit | $207.24

# References

STMicroelectronics. (n.d.). NUCLEO-WB15CC: STM32 Nucleo-64 development board. STMicroelectronics. https://www.st.com/en/evaluation-tools/nucleo-wb15cc.html

Azeron. (n.d.). Azeron – Game controllers for PC and consoles. https://www.azeron.eu/

Microsoft. (n.d.). Xbox adaptive controller. Xbox. https://www.xbox.com/en-US/accessories/controllers/xbox-adaptive-controller

Kuumeri, A. (2022, January 30). One-handed DualShock 4. Printables. https://www.printables.com/model/126646-one-handed-dualshock-4printables.com+5reddit.com+5reddit.com+5 (https://www.reddit.com/r/disabledgamers/comments/trcd3f?utm_source=chatgpt.com)

Heckendorn, B. J. (n.d.). Single-handed Xbox One controllers. Benheck.com. Retrieved June 11, 2025, from https://www.benheck.com/controllers/

OneSwitch.org.uk. (n.d.). One handed game controllers. Retrieved June 11, 2025, from https://oneswitch.org.uk/page/one-handed

Walker, J. (2014, May 1). ASCII Grip One-Handed RPG Controller Review (PlayStation). 1 More Castle. https://www.1morecastle.com/2014/05/ascii-grip-one-handed-rpg-controller-review-playstation/

Valve. (n.d.). Valve Index Controllers. Steam. Retrieved June 11, 2025, from https://store.steampowered.com/app/1059550/Valve_Index_Controllers/

Tek Gear. (n.d.). Twiddler 3 one-handed wearable keyboard & mouse. MyTwiddler. https://www.mytwiddler.com/

Akaki Controllers. (n.d.). Akaki Controllers. Retrieved June 12, 2025, from https://akaki.co/

Evil Controllers. (n.d.). Accessible controllers. Evil Controllers. Retrieved June 12, 2025, from https://www.evilcontrollers.com/store/accessible-controllers

Intel. (n.d.). How to fix input lag. https://www.intel.com/content/www/us/en/gaming/resources/how-to-fix-input-lag.html

Ableton. (n.d.). Bluetooth headphones and latency in Note. https://help.ableton.com/hc/en-us/articles/6130134332188-Bluetooth-Headphones-and-Latency-in-Note
