LaphyB/senior-project/Documentation/Deliverables/Memos/Memo 1 Landen Barber.docx

# Memo

To: | Ganghee Jang
From: | Landen Barber
Date: | October 6, 2025
Re: | First Memo

For my senior project, I will design and program a one-handed controller that incorporates various parts in order to implement features such as gyro, chorded input and wireless versatility. First and foremost, I should mention now that I am not entirely clear about the requirements of this project. So, I hope to get your feedback because I know that my project may be missing something that may be required, and I want to use your feedback to try to amend that, as well as to make my project more novel.

I will start with what I think is good about my project. I think that it fits as an embedded systems project because it combines both needing to build and code a device which utilizes various components like buttons, analog sticks, gyros and batteries, the latter of which I have never used before. These elements will help me develop skills expected of an embedded engineer, including hardware design, firmware development, and system integration. Having to fit so much in a small container like a controller will be a suitable challenge for me as well because I will also need to learn to 3D model and print the parts that I need. Another strong point of this project is my choice to program all the buttons and sensors myself while making them remappable all in order to further my overall goal of making the controller versatile for many use cases. Lastly, with the project being a controller, I also want to put a decent amount of effort into finding the right board to provide the bare minimum function, all the while optimizing the total cost to build one of these controllers.

There are also a few issues that I take from this proposal, looking back on it after a while I think that the project is less novel than I thought it was. Since these features have been refined time and time again by various companies for other types of controllers, I can only assume that there are various resources on how to make these features. Now I am not so sure that it is enough just to make the controller one handed, but I can’t think of a way to make it more novel. I also have some problems with the timeline I have set for myself. It may have been fine for the time, but now the vague timeline won’t cut it for the foreseeable future. It would behoove me to sit down and think through what I can accomplish within these next few months in order to make a more specific and helpful timeline. I haven’t even specified which schedule program I would be using, though it will probably be scrum.

In all, reading through the proposal again is making me realize how shallow my thinking was in coming up with the project and that I consider the more specific aspects of this project before needing to work on it. I hope to have your feedback on the general idea as I rethink these critical aspects of my project.
