LaphyB/senior-project/Documentation/Deliverables/Other/Deliverable Check 3.pptx

## Deliverable Check`

Landen Barber

## No 3d models or PCB printed Yet

- Even though I said I would print these weeks ago I keep putting it off.
- Did one last rework of the pin assignments to give room for one more module to expand the storage using SPI microSD card.
- Was not confident in the amount of storage the board had so I decided to add another part to give me more wiggle room in saving logs and a large history that the adaptive analyzer needs.
- Part should arrive Friday 4/24, pin assignments and most code already done in advance

## New Parts

- MicroSD card expansion slot
- Latching Button
- M3 Screw and standoff set
- Stackable Pin Headers

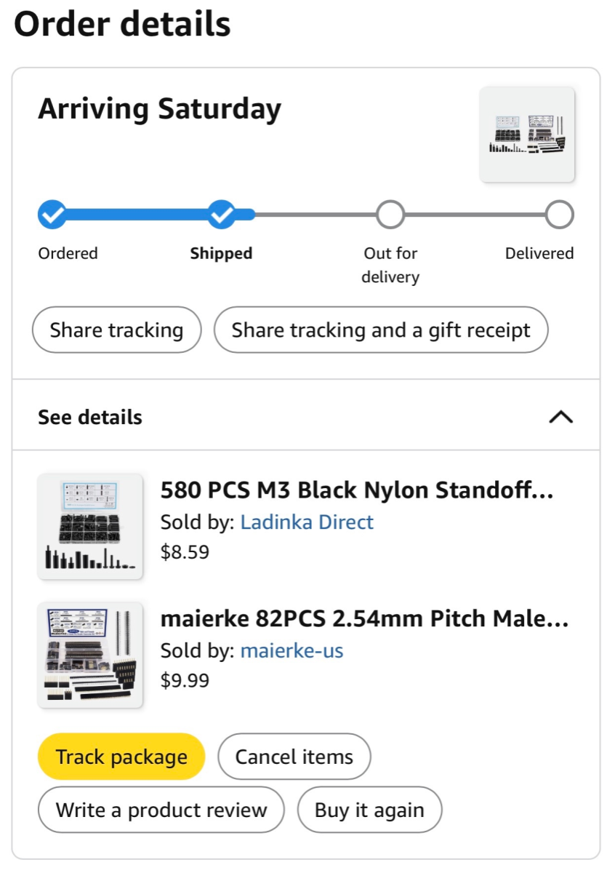
[picture p51: figure]
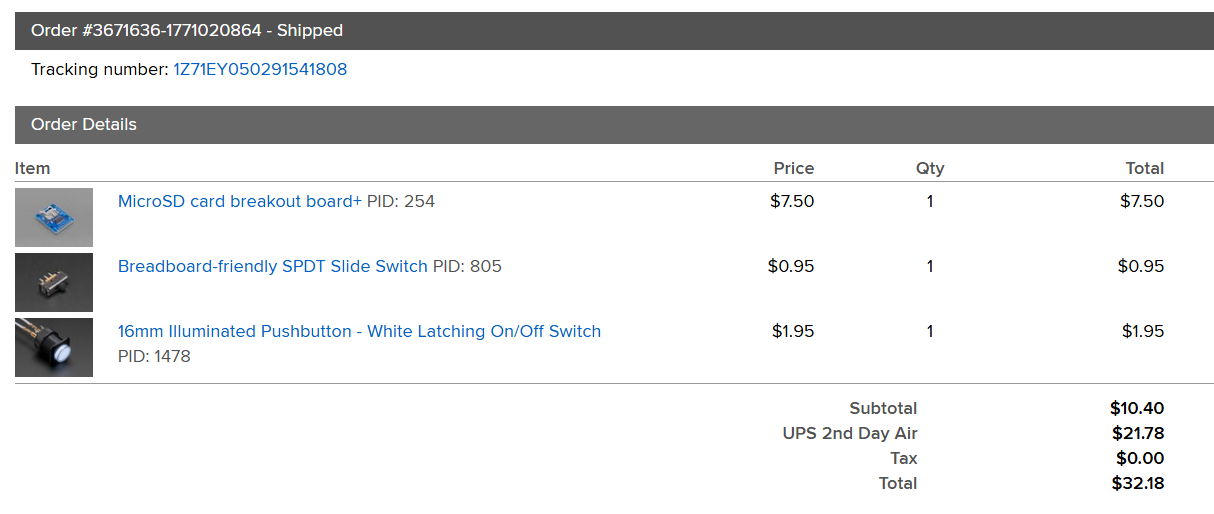
[picture p52: figure]

## Small PCB design Update

- Added new parts, but still unfinished. Want to clean up also.

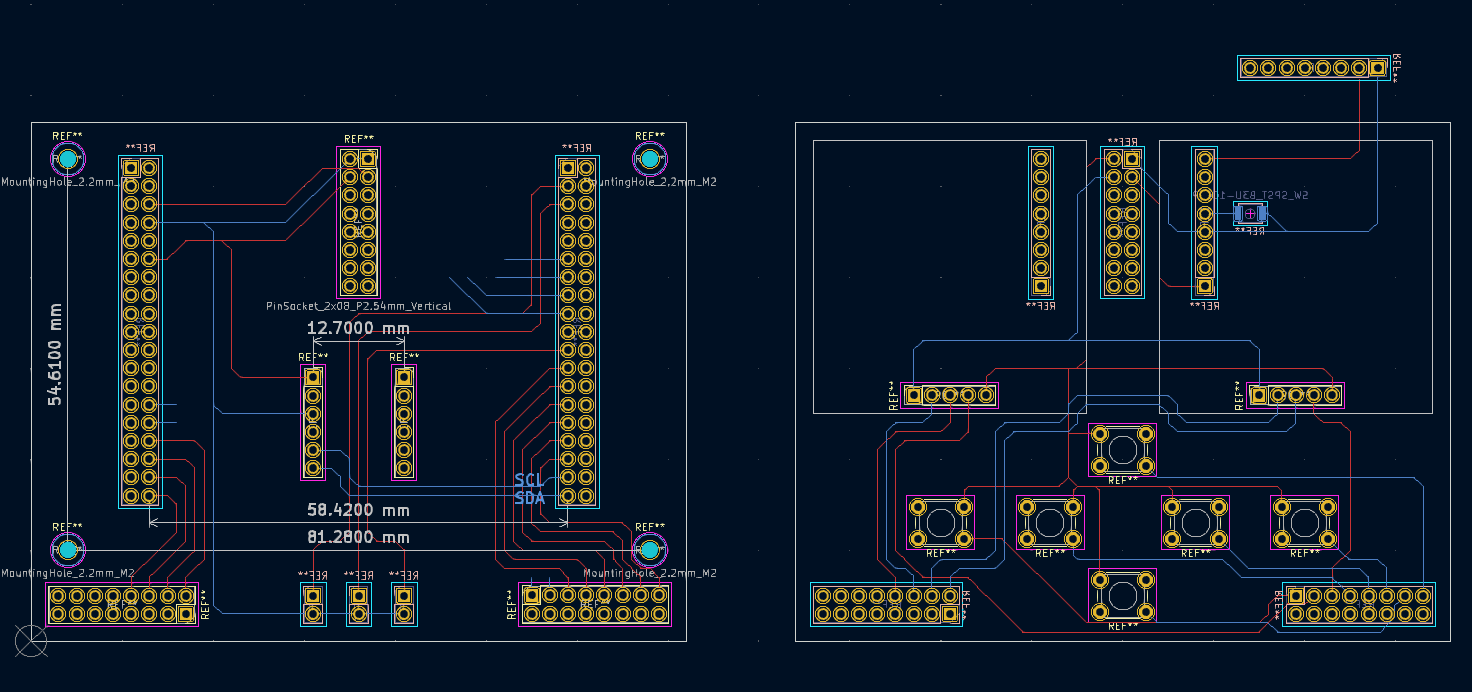
[picture p53: figure]

## Charging Circuit and Power Working

- Power supply being charged while program is running on board not connected to computer.
- Final Design will have actuating switch for power on and off, for now just a jumper wire.

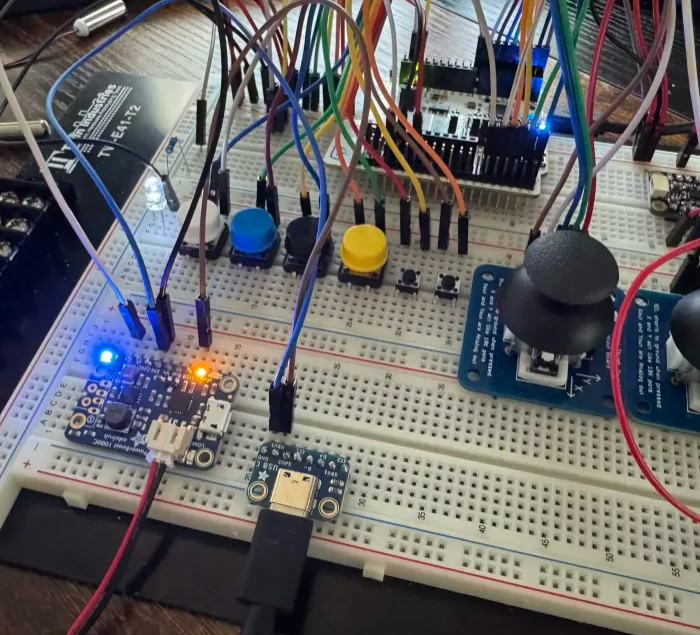
[picture p54: figure]

## Stuck On BLE and HID interface.

- Got Bluetooth working on a P2P example project offered by STM, but my selected board does not have any code generation for HID setup.
- I will either need to make it from scratch using a custom template which may be time consuming and difficult
- Can also convert an example project from the WB55RG board which has many more examples of HID and is nearly identical in architecture. Apparently, this isn’t that hard and is somewhat documented.

## Main rewrite

- Doubled Clock Speed and got ADC/DMA working at faster speeds.
- Main rewritten to be more appropriate of usage.

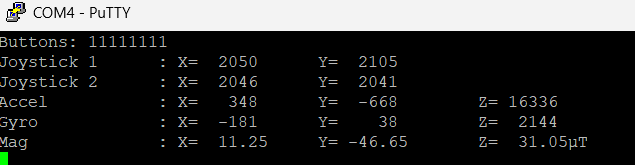
[picture p55: figure]
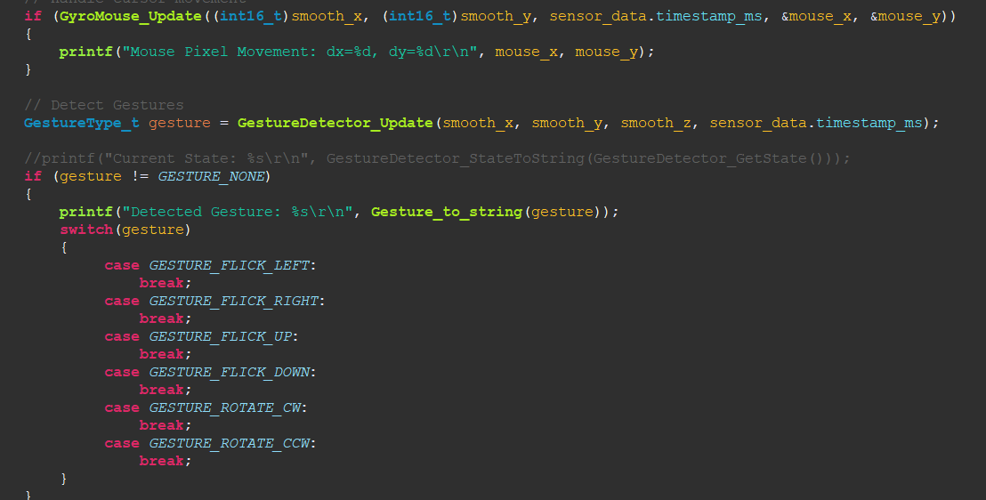
[picture p56: figure]
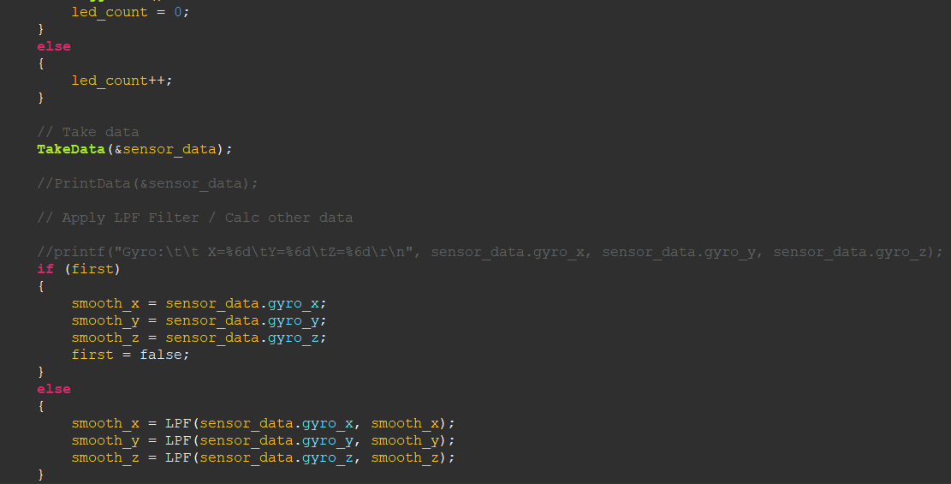
[picture p57: figure]

## Config File

- Start of config file
- Just #defines for now, will need to turn into variable if I want to change them while code running

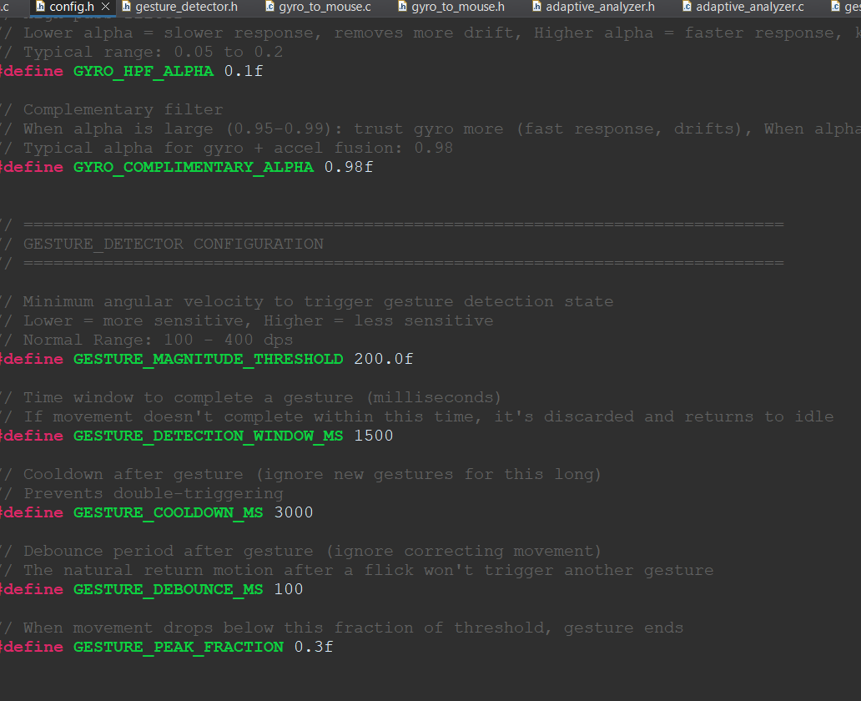
[picture p58: figure]

## Gesture Detector code

- Gesture detection code is largely complete, butslightly janky and difficult to test because of the state of wire mess.
- Acts as a state machine which returns a gesture enum and logs the event when gesture is recognized.

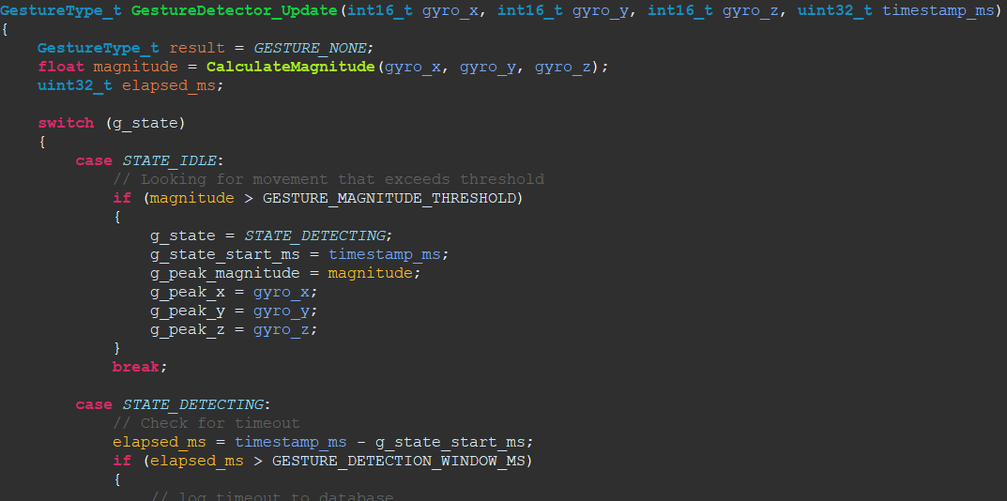
[picture p59: figure]
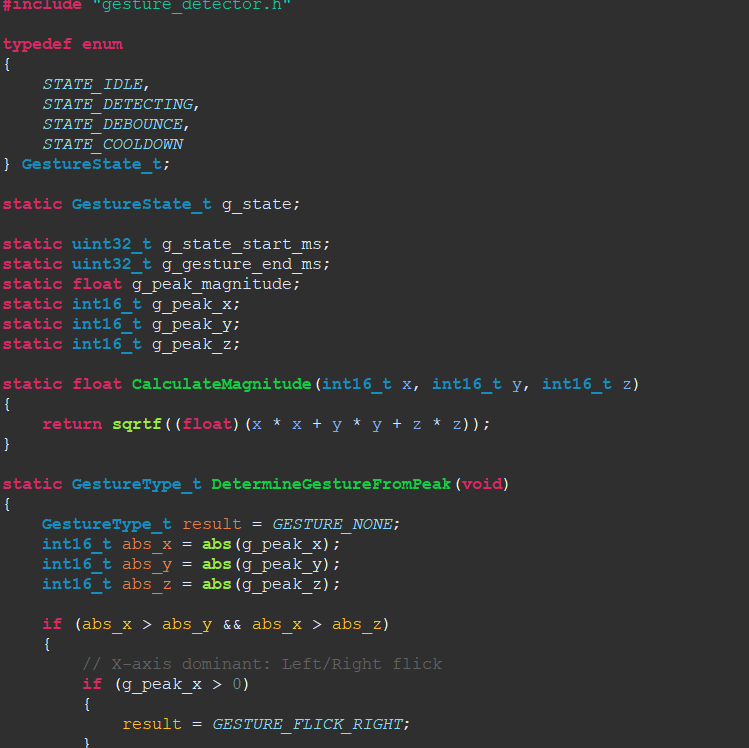
[picture p60: figure]
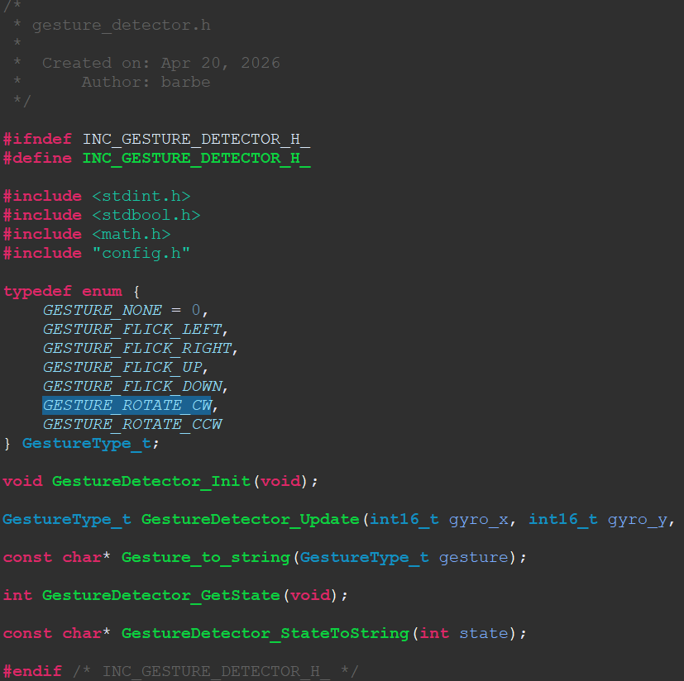
[picture p61: figure]

## Gesture to Mouse Movement

- Though cannot be implemented yet as I don’t have BLE or HID, Gesture to cursor movement should be mostly done.

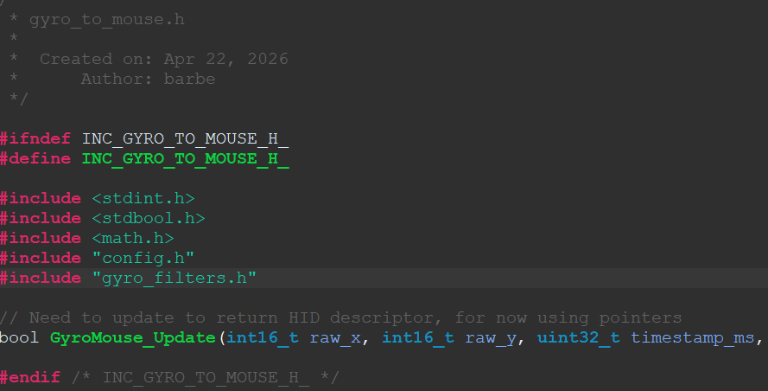
[picture p62: figure]
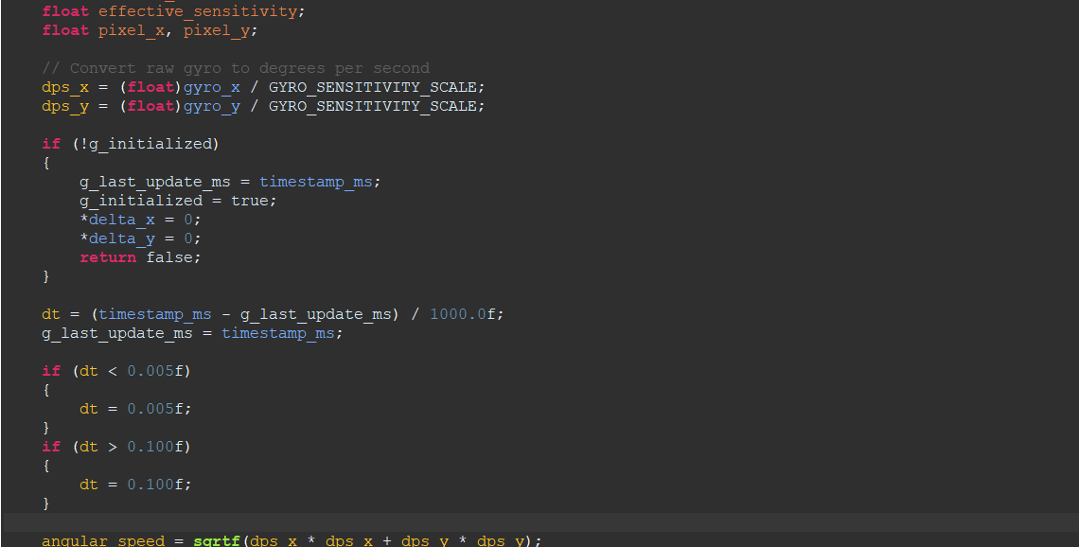
[picture p63: figure]
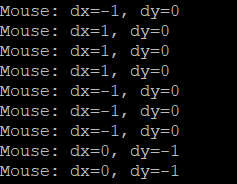
[picture p64: figure]

## Adaptive Analyzer

- Not implemented yet but is the next step in software design.

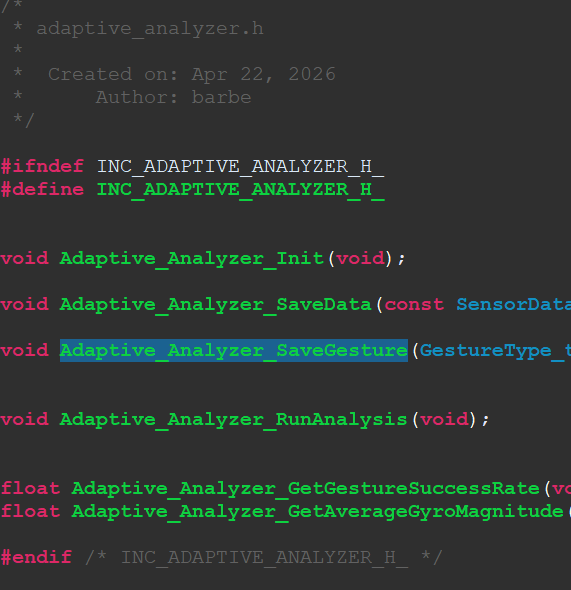
[picture p65: figure]

## Next Steps

- Get BLE and HID communication working
- Finalize Multilevel PCB to print (by Sunday 4/26 at the latest)
- Print Cad Models (Have finished prints by next Friday)
- Assemble (Parts should come in at the same time allowing me to finally construct controller)
- While waiting for parts continue working on software portion
- After put together, fine tune gesture control settings to do more accurate testing
