LaphyB/senior-project/Documentation/Deliverables/Other/Final Deliverable Check.docx

Landen Barber

3/18/26

Final Deliverable Check

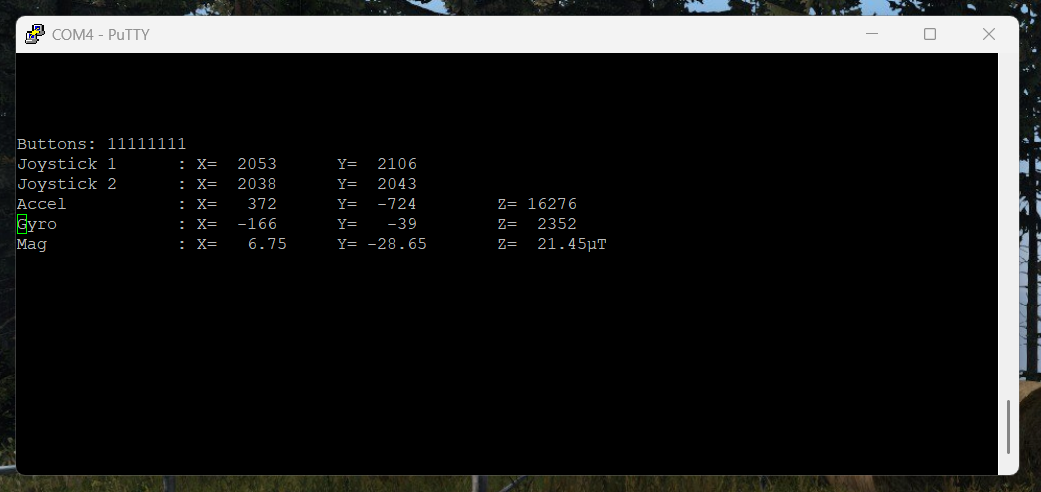
[picture p66: figure]
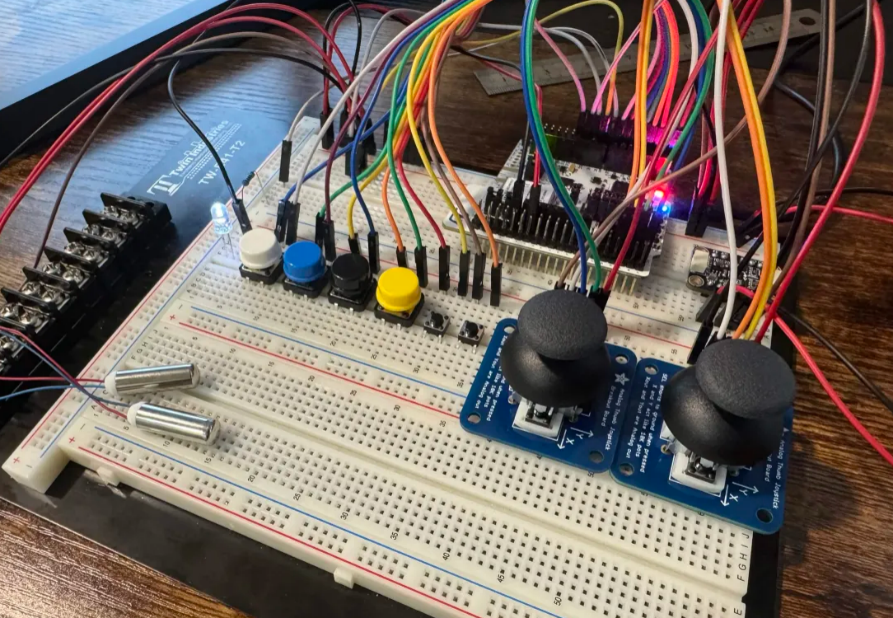
[picture p67: figure]

## Software / Prototype

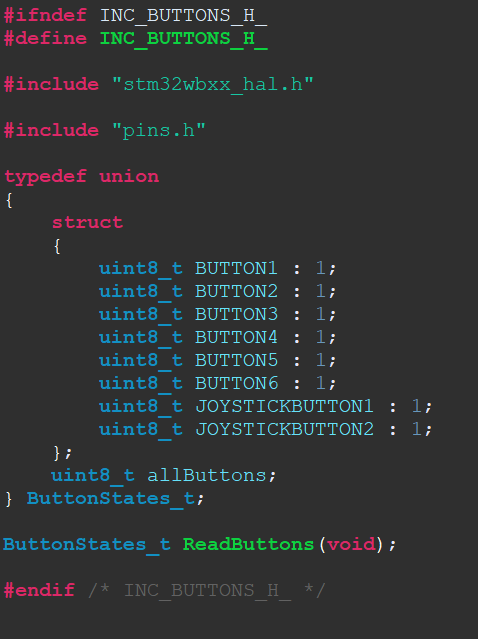
[picture p68: figure]
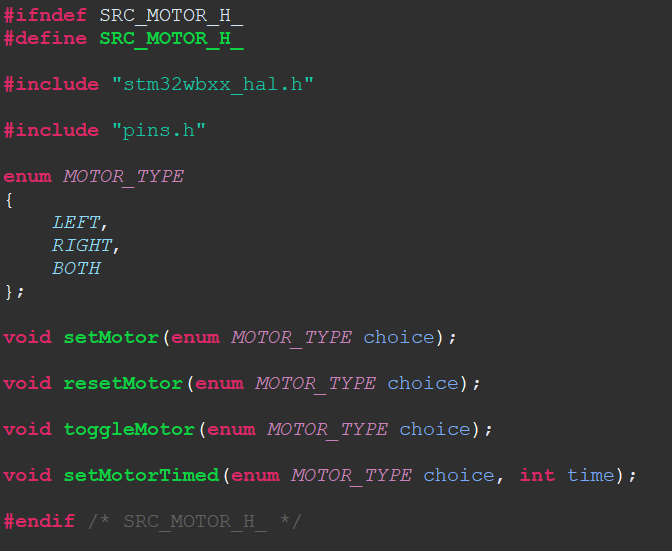
[picture p69: figure]
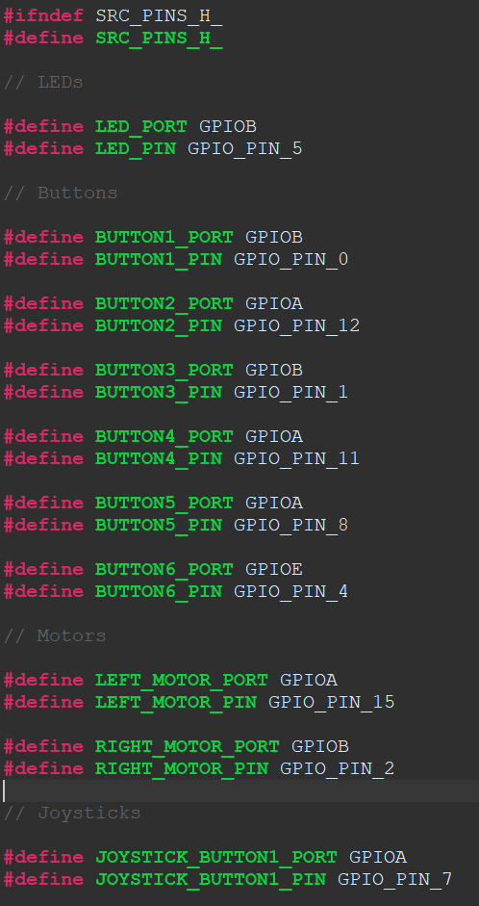
[picture p70: figure]
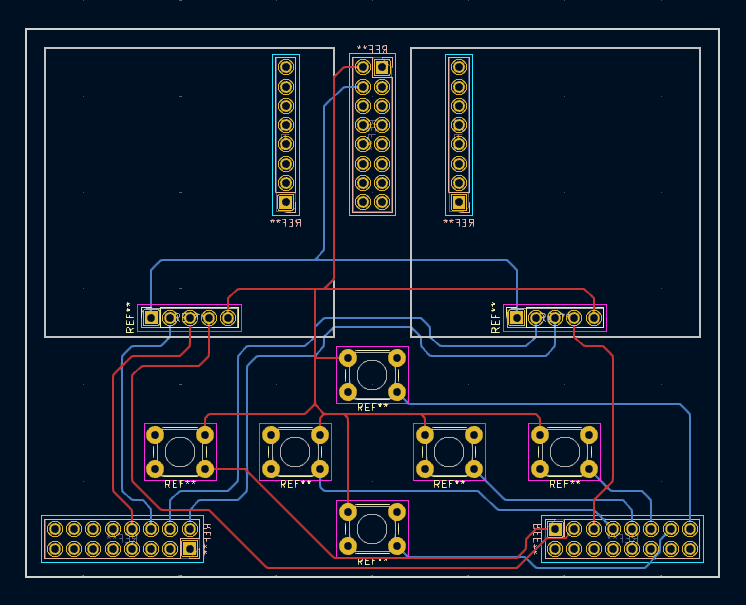
[picture p71: figure]
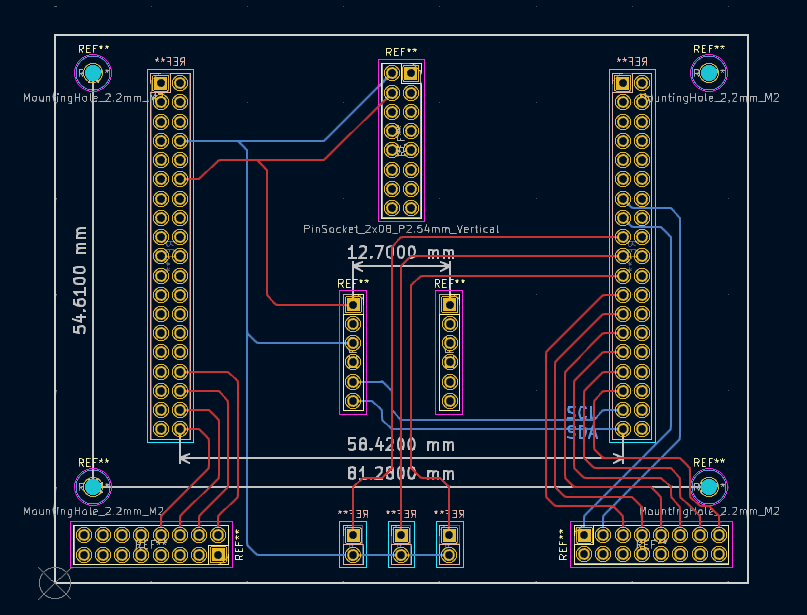
[picture p72: figure]

## PCB

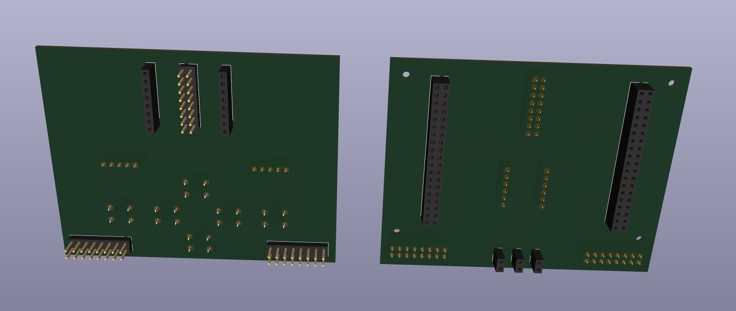
[picture p73: figure]
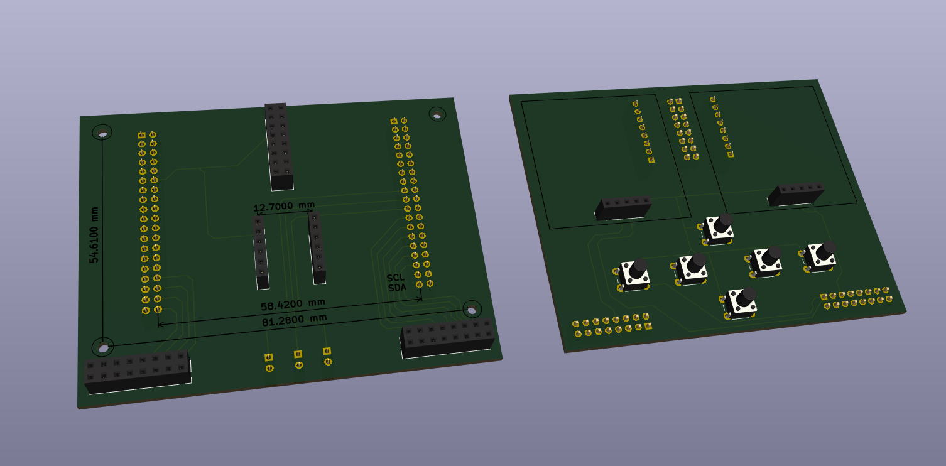
[picture p74: figure]
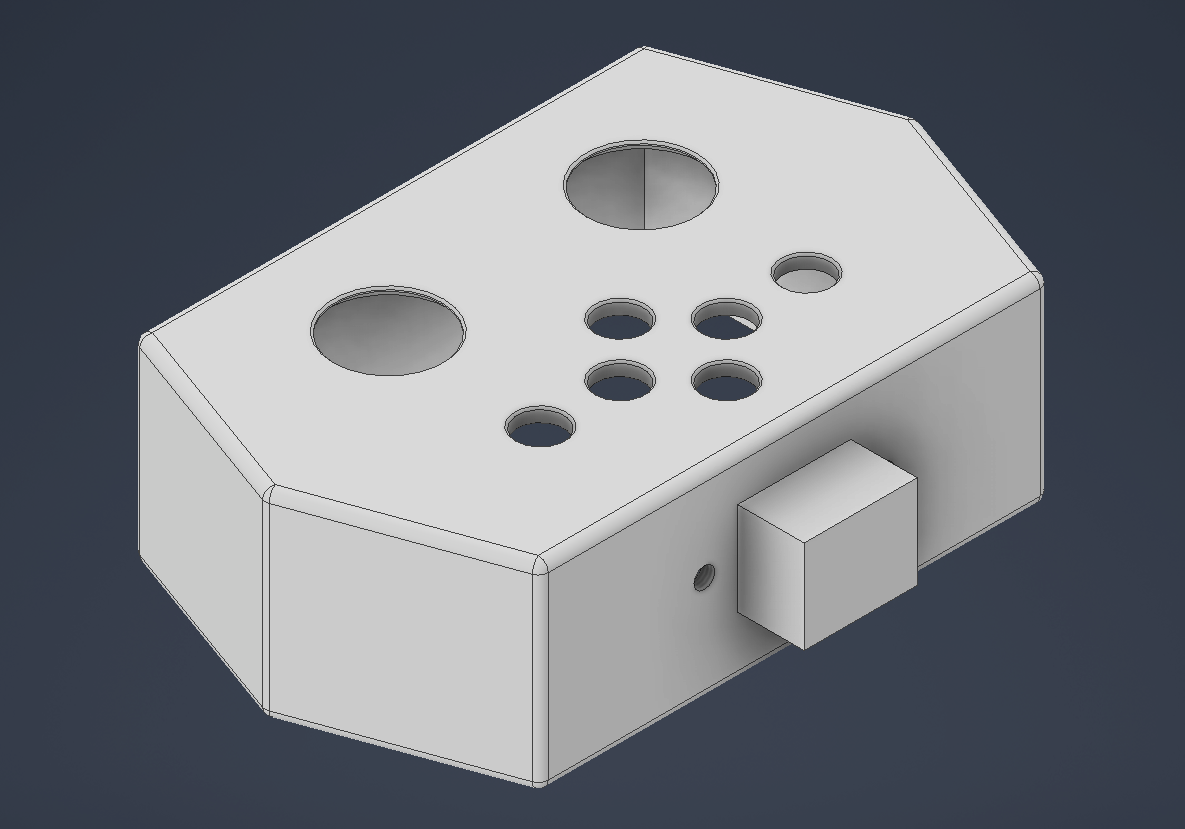
[picture p75: figure]

## 3d Modelling

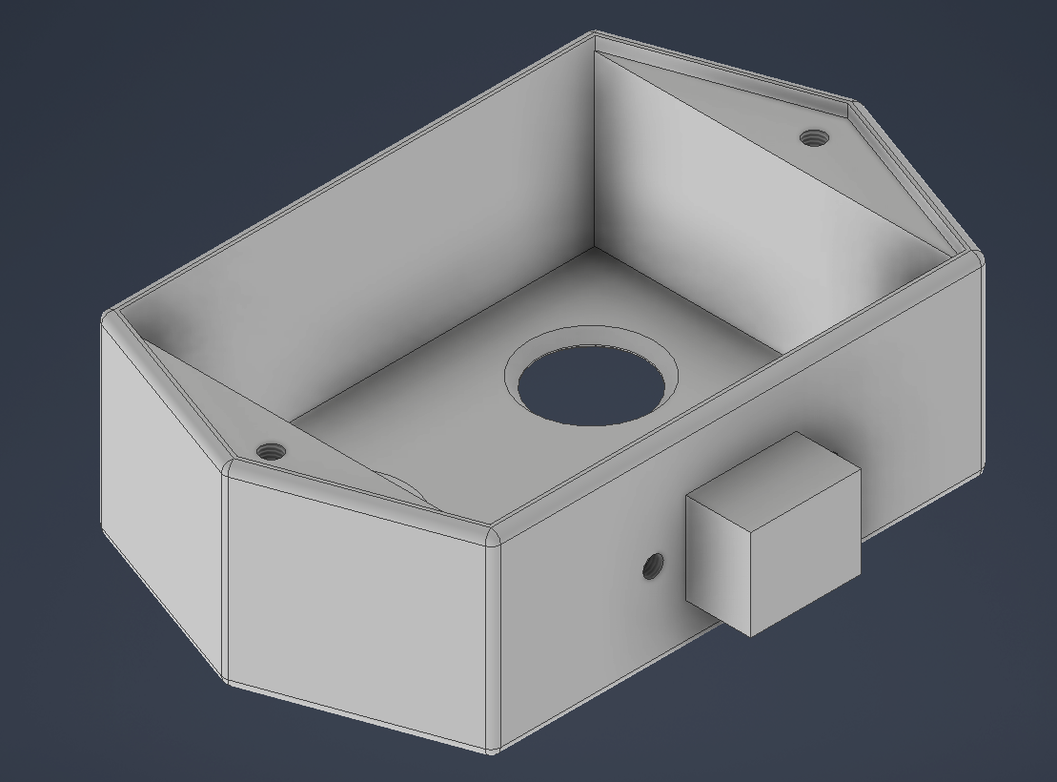
[picture p76: figure]
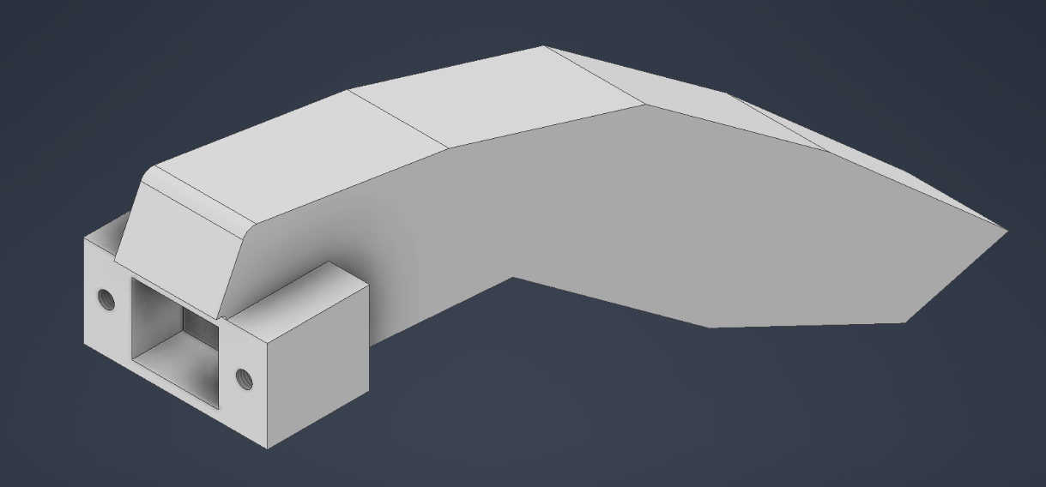
[picture p77: figure]
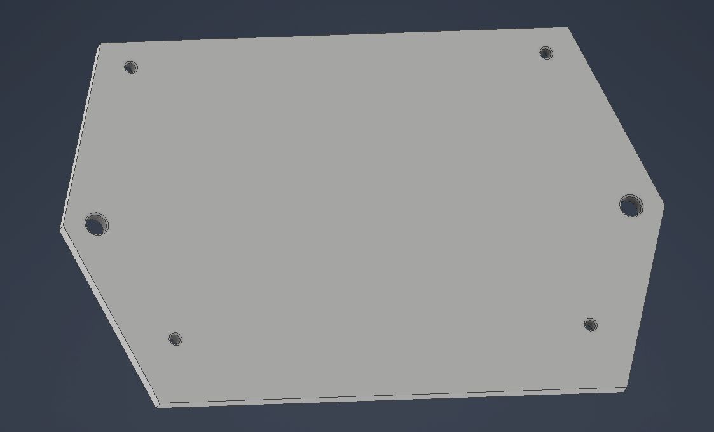
[picture p78: figure]
