LaphyB/senior-project/Documentation/Schedule/Schedule Turn In.docx

Landen Barber

10/30/25

Schedule Document Turn In

Three quarter Gantt chart

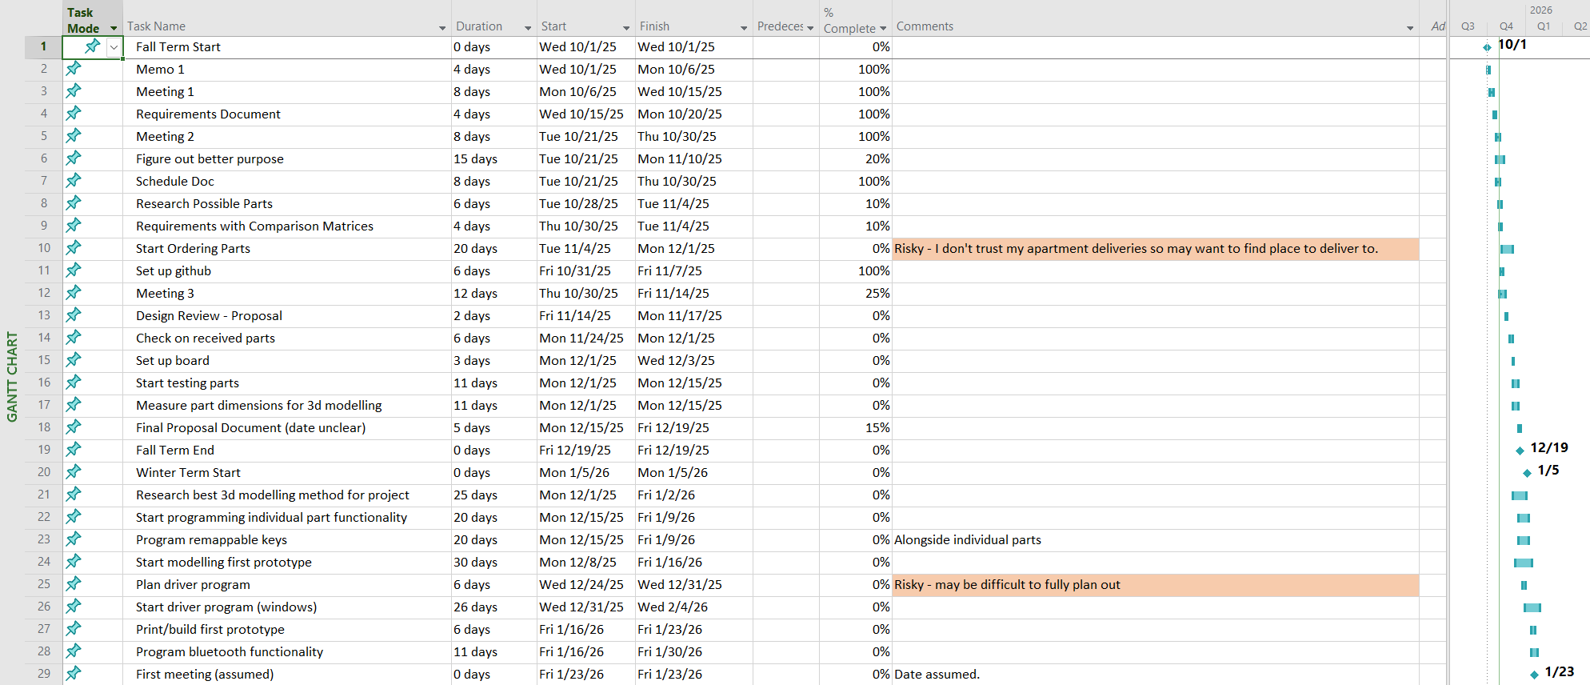
[picture p79: figure]
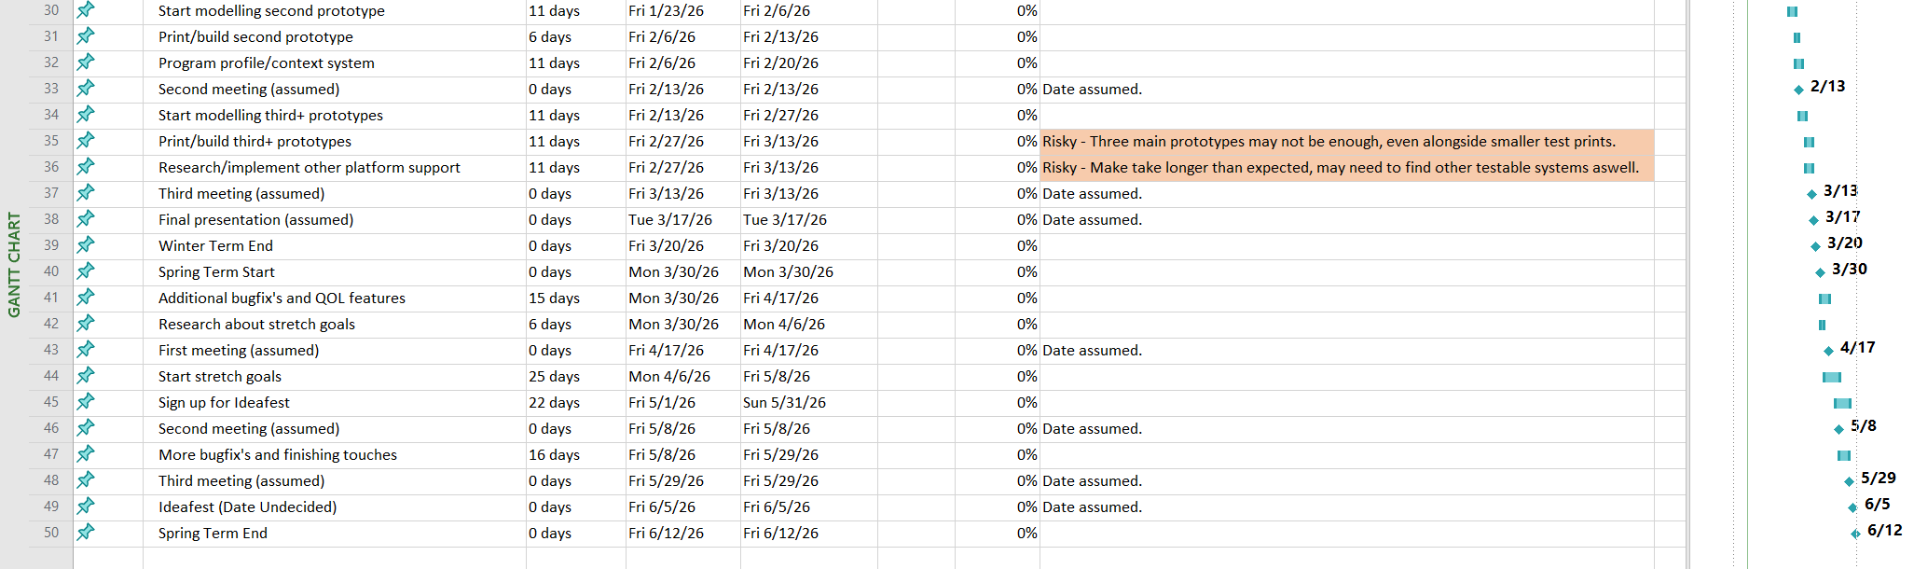
[picture p80: figure]

Sprint for fall term

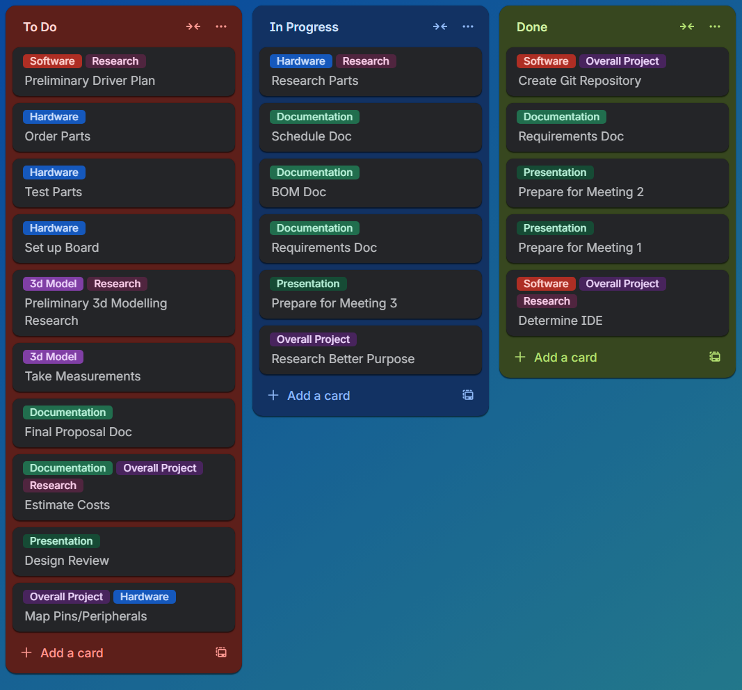
[picture p81: figure]
