LaphyB/senior-project/Documentation/Deliverables/Ethics Paper/Ethics Paper.docx

Ethical Discussion of the Columbia Space Shuttle Disaster

Landen Barber

Oregon Institute of Technology

Klamath Falls, OR

Landen.barber@oit.edu

Abstract - The Columbia Space Shuttle disaster of February 1st, 2003 resulted in the deaths of several astronauts and a few people on the ground when the shuttle’s left wing broke off due to loose foam insulation. This incident highlights the ethical dilemmas of safety versus scheduling pressures and workplace culture at NASA. Engineers raised concerns over this damage, but the issue was downplayed by management due to prior belief that foam never caused any serious issues. This violates a few of IEEEs code of ethics including the failure to prioritize safety. This disaster emphasizes the importance of communication and responsibility for thigh stakes engineering environments.

The Columbia Space Shuttle disaster occurred on February 1st, 2003, and resulted in the deaths of all seven astronauts on board the spacecraft due to damage to the shuttle’s left wing. More specifically, a piece of foam insulation from the shuttle’s external fuel tank broke off and struck the left wing, compromising the thermal protection tiles that protected the shuttle from the extreme heat during reentry. This extreme heat and pressure got into the wing interior resulting in it blowing apart and causing the aircraft to become unstable and break apart midair.

The ethical dilemma of this disaster revolves around a few issues including a conflict between safety and scheduling pressure, as well as workplace culture. The crux of this dilemma is that similar incidents occurred on three prior shuttle launches where foam would fall off the external fuel tank, but because this had not caused any serious problems before, it was deemed an acceptable risk. During launch, engineers noticed foam breaking off the engine but were unable to fully grasp how much damage had occurred during flight. Before reentry, NASA managers limited this investigation stating that even if damage had occurred, there was nothing they could do to correct it.

In retrospect to this incident, most of the unethical behavior was enacted on the managerial side, rather than on the engineer’s side. As we know NASA engineers raised concerns over the fragile foam but were disregarded by management because previous missions were successful. This breaks a few of IEEE code of ethics, like section I1 which states that they must “Hold paramount the safety, health, and welfare of the public.” [1] This applies to both the astronauts, and the people who were hurt or killed by falling debris resulting from the decision to not investigate further despite knowing that damage had occurred. They also broke section I2 stating that they must “Improve the understanding by individuals and society of the capabilities and societal implications of conventional and emerging technologies, including intelligent systems.” [1] because they used the success of previous missions to conclude that the foam breaking problem was an acceptable risk that probably would not cause any serious problems. Lastly, they also broke rule I5 stating that they must “acknowledge and correct errors, to be honest and realistic in stating claims or estimates based on available data.” [1] This occurred when they made assumptions based on the limited data they had about the condition of the vessel and used that information to downplay engineers’ concerns about potential failure. The engineers are not completely free from fault though as they were hesitant to escalate these issues further because of overhead pressure to maintain the set shuttle launch schedule due to political and budgetary constraints as the launch was already pushed back numerous times spanning over two years.

There are several things that could have been done to prevent this incident from ever occurring, from the engineer’s side, creating a better system where issues could be properly handled and escalated is important for the safety and success rates of a mission. On the procedural level, safety reviews may be necessary to identify common issues and correct them in order to further spaceflight technology and safety of its passengers.

In the aftermath of this event, space shuttles flights were suspended for over two years which halted progress on the ISS which was still under construction. After investigations into the cause of this disaster, “The board determined that NASA lacked the appropriate communication and integration channels to allow problems to be discussed and effectively routed and addressed.”[2]

If I were an engineer in this situation, realistically I am not confident I would be able to do anything differently. As someone who is mostly non-confrontational, I would bring up my concerns but like the engineers related to this incident I probably wouldn’t escalate these issues especially in such an organized environment where there is no definitive proof of any failure. This is definitely something to reflect on as this disaster highlights the importance of needing to speak out when there is wrongdoing that may endanger the lives of others.

References

[1] IEEE, "IEEE Code of Ethics," IEEE, 2023. [Online]. Available: https://www.ieee.org/about/corporate/governance/p7-8.html. [Accessed: Feb. 7, 2026].

[2] W. Harwood, “20 years after Columbia disaster, lessons learned still in sharp focus at NASA,” Spaceflight Now, Feb. 1, 2023. [Online]. Available: https://spaceflightnow.com/2023/02/01/20-years-after-columbia-disaster-lessons-learned-still-in-sharp-focus-at-nasa/. [Accessed: Feb. 7, 2026].

[3] History.com, “Columbia mission ends in disaster,” History.com. [Online]. Available: https://www.history.com/this-day-in-history/february-1/columbia-mission-ends-in-disaster. [Accessed: Feb. 7, 2026].

[4] NASA, “Remembering the Columbia STS-107 Mission,” NASA. [Online]. Available: https://www.nasa.gov/remembering-columbia-sts-107/. [Accessed: Feb. 7, 2026].

[5] Purdue Online Writing Lab, "IEEE Style," Purdue University, 2026. [Online]. Available: https://owl.purdue.edu/owl/research_and_citation/ieee_style/ieee_general_format.html. [Accessed: Feb. 8, 2026].
