LaphyB/senior-project/Documentation/IdeaFest/IdeaFest Poster.png

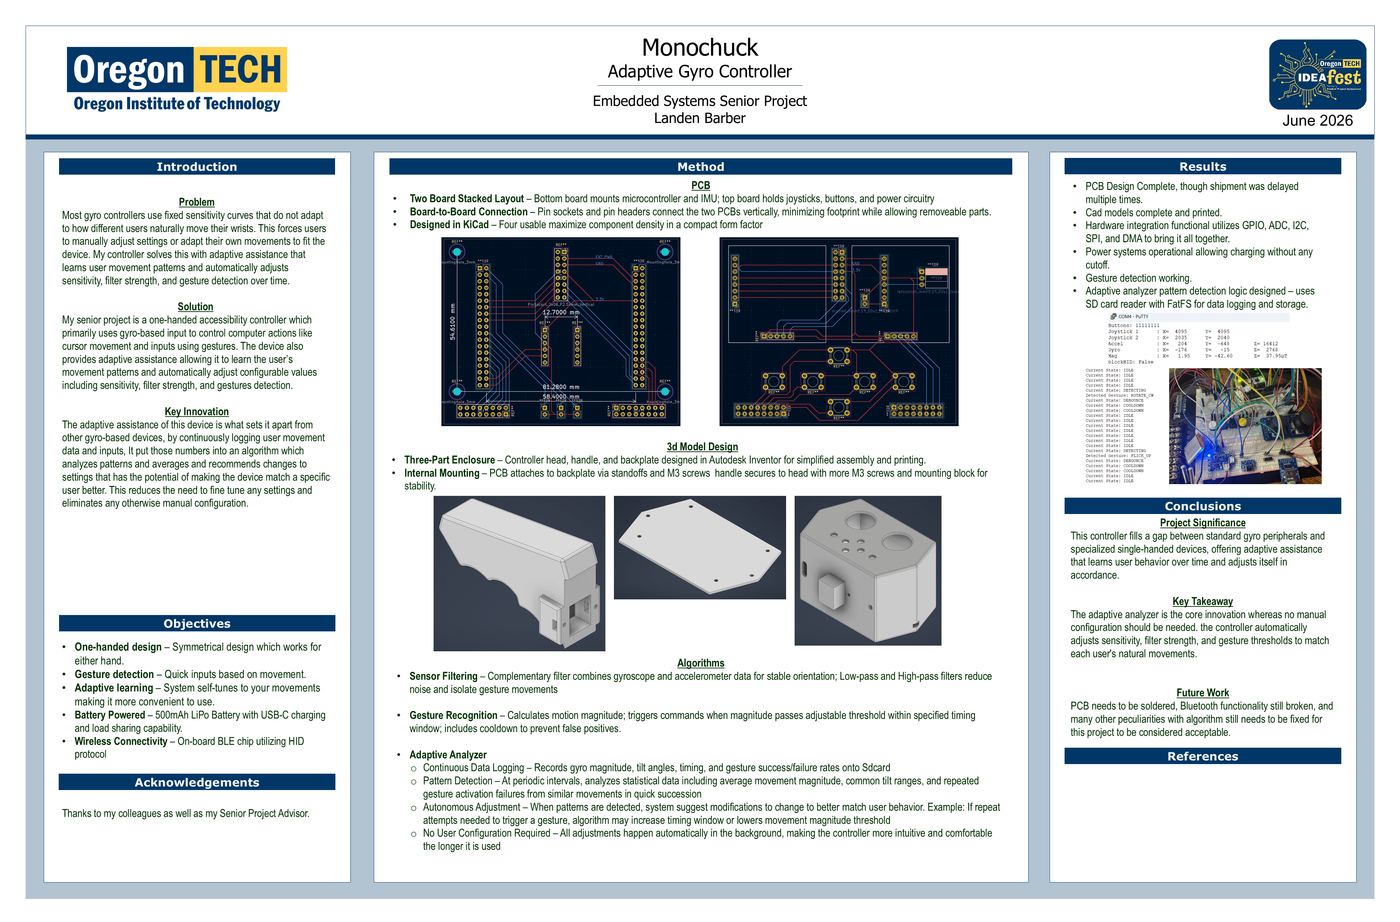
Documentation/IdeaFest/IdeaFest Poster.png
