LaphyB/senior-project/Documentation/BOM.xlsx

Part Number | Object Type | Quantity | Name | Links | Description | Manufacturer | Price | Plan to Use | Shipping Status | Order Date | Arrival Date
1 | Microcontroller | 1 | Nucleo-WB15CC | https://www.st.com/en/evaluation-tools/nucleo-wb15cc.html | Microcontroller | STMicroelectronics | $36.33 | Yes | Arrived | 2025-11-16 | 2025-11-16
2 | USB-C Breakout | 1 | USB Type C Breakout Board | https://www.adafruit.com/product/4090 | Splits data and power | Adafruit | $2.95 | Yes | Arrived | 2025-11-16 | 2025-11-20
3 | Charging Circuit | 1 | PowerBoost 1000C | https://www.adafruit.com/product/2465 | Charging + Load Sharing | Adafruit | $19.95 | Yes | Arrived | 2025-11-16 | 2025-11-20
4 | Battery | 1 | LiOn Battery | https://www.adafruit.com/product/2011 | 3.7V 500mAh w Protection Circuit | Adafruit | $7.95 | Yes | Arrived | 2025-11-16 | 2025-11-20
5 | Joystick | 2 | Analog 2-axis thumb joystick | https://www.adafruit.com/product/512 | 2-axis thumb sticks | Adafruit | $5.95 | Yes | Arrived | 2025-11-16 | 2025-11-20
6 | LED | 1 | LED |  | White LED | Already Owned | NA | Yes | Arrived | NA | NA
7 | Button | 6 | Pushbuttons |  | Buttons | Already Owned | NA | Yes | Arrived | NA | NA
8 | 3d Print | 1 | Controller Housing |  | Housing for PCBs' and grip | Printed by CSET | $0.00 | Yes | Arrived | 2026-05-31 | 2026-06-01
9 | PCB | 1 | Top PCB |  | Top PCB for buttons and joystick | JLCPCB | 11.50$ | Yes | Arrived | 2026-05-27 | 2026-06-02
10 | PCB | 1 | Bottom PCB |  | Bottom PCB for board and other components | JLCPCB | 9.50$ | Yes | Arrived | 2026-05-27 | 2026-06-02
11 | Hand Strap | 1 | Elastic Strap | https://www.amazon.com/BEYOURD-Buckles-Straps-Set-Adjustable/dp/B08LD8CJ8D | 1in elastic strap with buckles | Beyourd | $9.99 | Yes | Arrived | 2025-11-16 | 2025-11-19
12 | Haptic Motor | 1 | Coreless Vibration Motors | https://www.amazon.com/Vibration-Waterproof-8000-20000RPM-Electronic-equipments/dp/B0CY2KLH2P | 6 pack motors | Zard Zoop | $9.99 | Yes | Arrived | 2025-11-16 | 2025-11-16
13 | Wires | 1 | Jumper Wires | https://www.amazon.com/EDGELEC-Breadboard-Optional-Assorted-Multicolored/dp/B07GD2BWPY | Wire collection (mxm, mxf, fxf) | Edgelec | $6.98 | Yes | Arrived | 2025-11-16 | 2025-11-19
14 | Gyro | 1 | InvenSense ICM-20948 | https://www.adafruit.com/product/4554 | Gyro + accel | Adafruit | $14.95 | Yes | Arrived | 2025-11-16 | 2025-11-20
15 | microSD Board | 1 | MicroSD Card Breakout Board | https://www.adafruit.com/product/254 | Breakout board using SPI | Adafruit | $7.50 | Yes | Arrived | 2026-04-23 | 2026-04-25
16 | microSD Card | 1 | 32Gb MicroSD Card |  |  | Already Owned | $14.99 | Yes | Arrived | NA | NA
17 | Male Pin Headers | 1 | 2.54mm Male pin headers |  | Pin headers for PCB | Already Owned |  | Yes | Arrived | NA | NA
18 | 2x19 F Pin Feader | 2 | 2.54mm | https://www.pololu.com/ | Needed for PCB | Pololu | $3.59 | Yes | Arrived | 2026-05-27 | 2026-06-01
19 | 1x2 F Pin Feader | 5 | 2.54mm | https://www.pololu.com/ | Needed for PCB | Pololu | $0.57 | Yes | Arrived | 2026-05-27 | 2026-06-01
20 | 2x8 F Pin Feader | 3 | 2.54mm | https://www.pololu.com/ | Needed for PCB | Pololu | $2.00 | Yes | Arrived | 2026-05-27 | 2026-06-01
21 | 1x5 F Pin Feader | 2 | 2.54mm | https://www.pololu.com/ | Needed for PCB | Pololu | $0.88 | Yes | Arrived | 2026-05-27 | 2026-06-01
22 | 1x3 F Pin Feader | 1 | 2.54mm, horizontal | https://www.pololu.com/ | Needed for PCB | Pololu | $0.52 | Yes | Arrived | 2026-05-27 | 2026-06-01
23 | Resistor | 1 | 330ohm |  | Resistor for LED | Already Owned | NA | Yes | NA | NA | NA
