LaphyB/senior-project/CAD/STL/ControllerHandle.stl

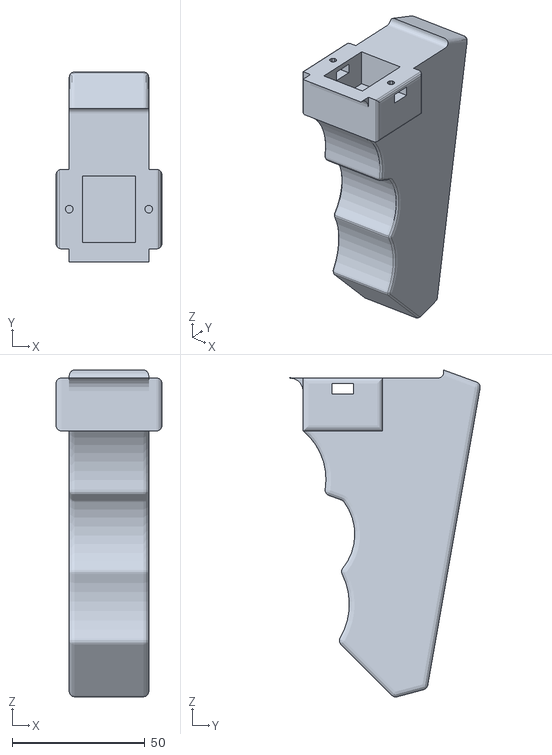
[picture p83: CAD file, 2026-06-11]
CAD/STL/ControllerHandle.stl
40.0 x 71.8 x 123.4
