LaphyB/senior-project/CAD/STL/ControllerButton.stl

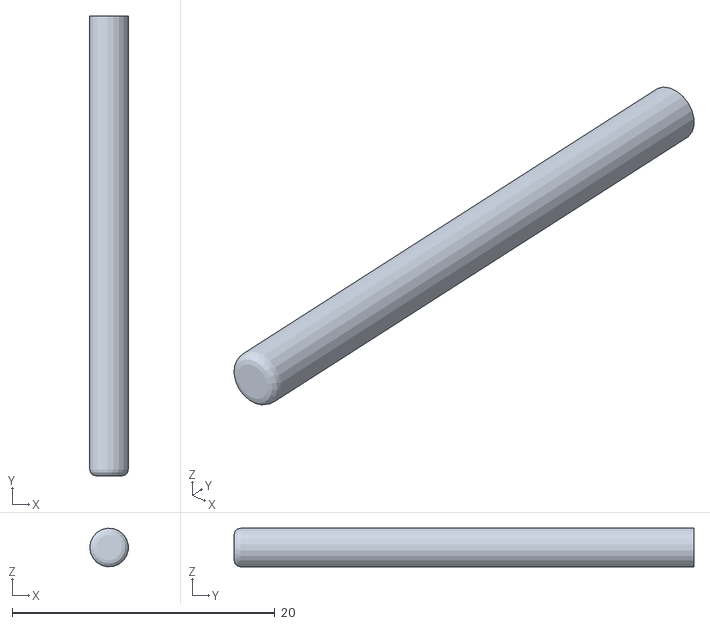
[picture p85: CAD file, 2026-06-11]
CAD/STL/ControllerButton.stl
2.93 x 35.0 x 2.94
