LaphyB/senior-project/PCB/Schematics/mb1641_bdp/MB1641C/ALTIUM_EMBEDDED_MODELS/DFN6-EPAD_3X3_P095.STEP

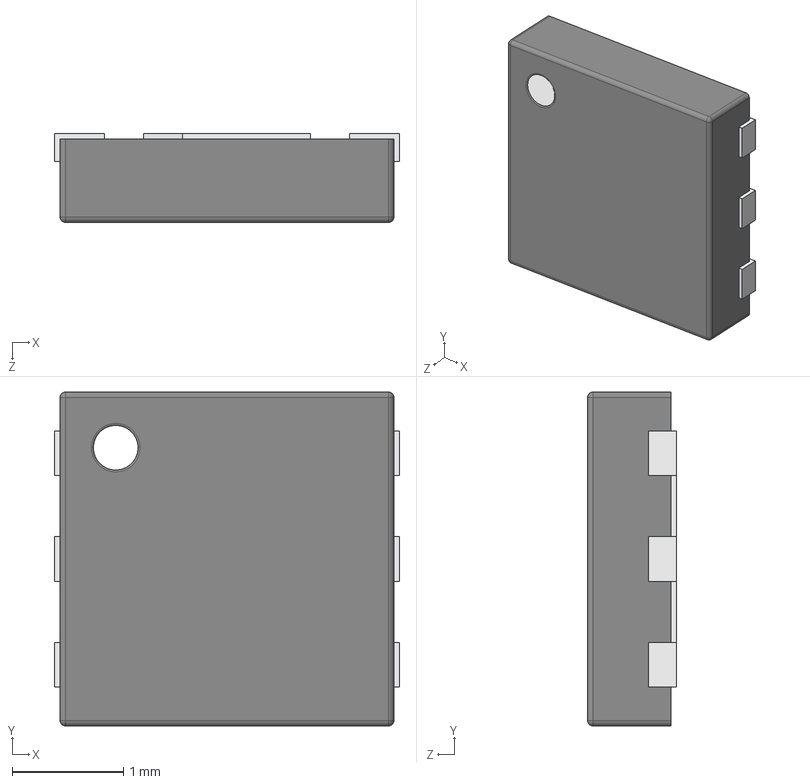
[picture p86: CAD file, 2026-06-11]
PCB/Schematics/mb1641_bdp/MB1641C/ALTIUM_EMBEDDED_MODELS/DFN6-EPAD_3X3_P095.STEP
3.10 x 3.00 x 0.8 mm
