LaphyB/senior-project/CAD/STL/ControllerHeadBottom.stl

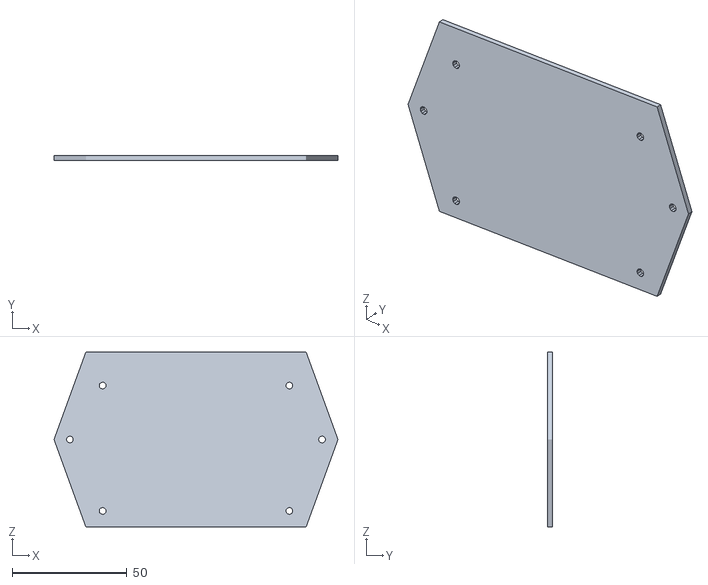
[picture p87: CAD file, 2026-06-11]
CAD/STL/ControllerHeadBottom.stl
123.7 x 2.00 x 76.0
