LaphyB/senior-project/PCB/Schematics/mb1641_bdp/MB1641C/ALTIUM_EMBEDDED_MODELS/MOLEX_105017-0001.stp

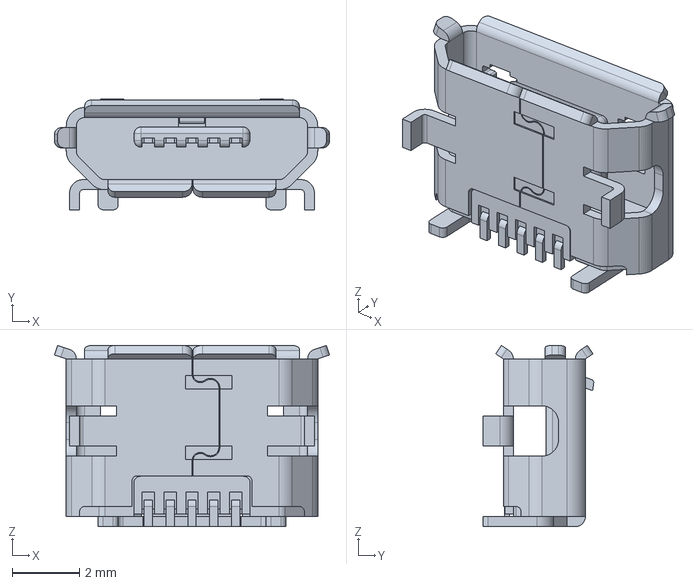
[picture p88: CAD file, 2026-06-11]
PCB/Schematics/mb1641_bdp/MB1641C/ALTIUM_EMBEDDED_MODELS/MOLEX_105017-0001.stp
8.20 x 3.30 x 5.40 mm
