LaphyB/senior-project/CAD/STL/ControllerHead.stl

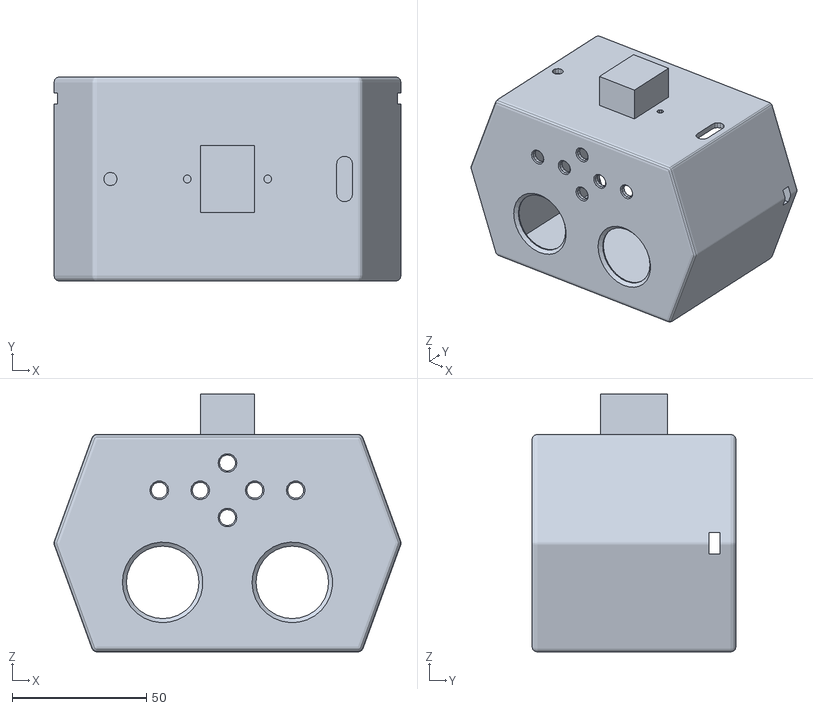
[picture p89: CAD file, 2026-06-11]
CAD/STL/ControllerHead.stl
129.2 x 76.0 x 96.0
