LaphyB/senior-project/PCB/Schematics/mb1641_bdp/MB1641C/ALTIUM_EMBEDDED_MODELS/SOT353-1.STEP

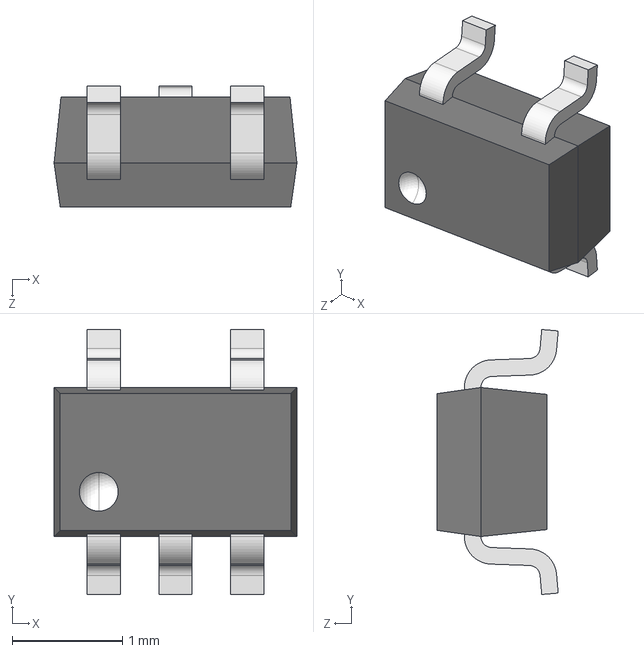
[picture p90: CAD file, 2026-06-11]
PCB/Schematics/mb1641_bdp/MB1641C/ALTIUM_EMBEDDED_MODELS/SOT353-1.STEP
2.20 x 2.40 x 1.10 mm
