LaphyB/senior-project/PCB/Schematics/mb1641_bdp/MB1641C/ALTIUM_EMBEDDED_MODELS/SMA_CINCH-JOHN_142-0701-851.stp

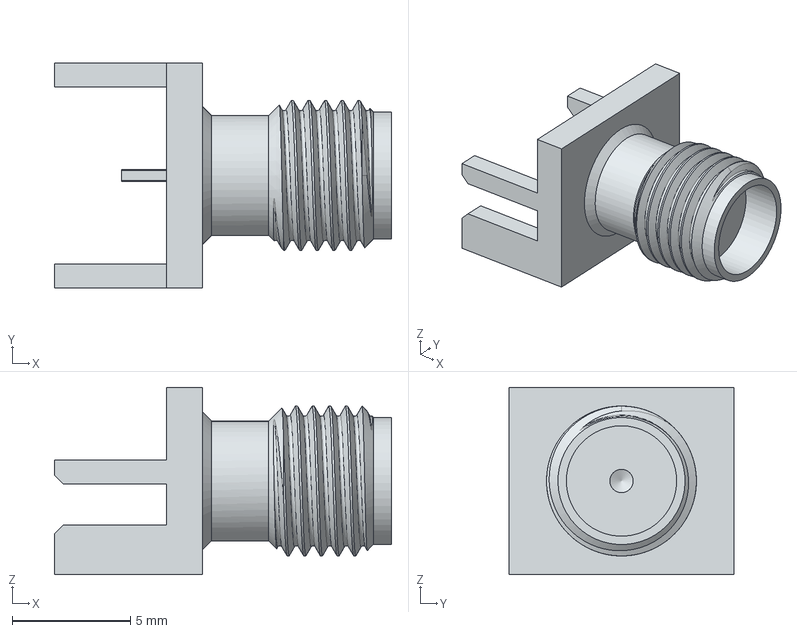
[picture p91: CAD file, 2026-06-11]
PCB/Schematics/mb1641_bdp/MB1641C/ALTIUM_EMBEDDED_MODELS/SMA_CINCH-JOHN_142-0701-851.stp
14.3 x 9.53 x 7.92 mm
