LaphyB/senior-project/PCB/Schematics/mb1641_bdp/MB1641C/ALTIUM_EMBEDDED_MODELS/TAJ-A_1206_3216-8_POL.STEP

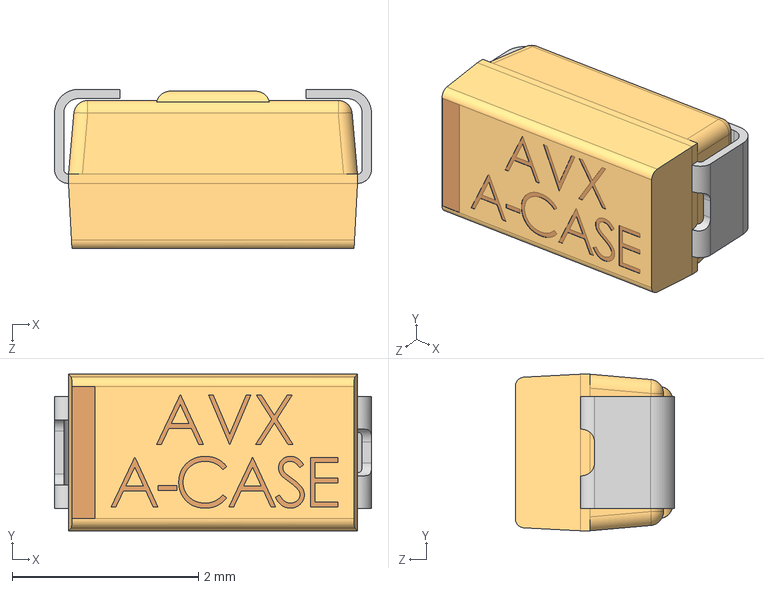
[picture p93: CAD file, 2026-06-11]
PCB/Schematics/mb1641_bdp/MB1641C/ALTIUM_EMBEDDED_MODELS/TAJ-A_1206_3216-8_POL.STEP
3.40 x 1.68 x 1.71 mm
