LaphyB/senior-project/PCB/Schematics/mb1641_bdp/MB1641C/ALTIUM_EMBEDDED_MODELS/TSW-102-07-G-S.stp

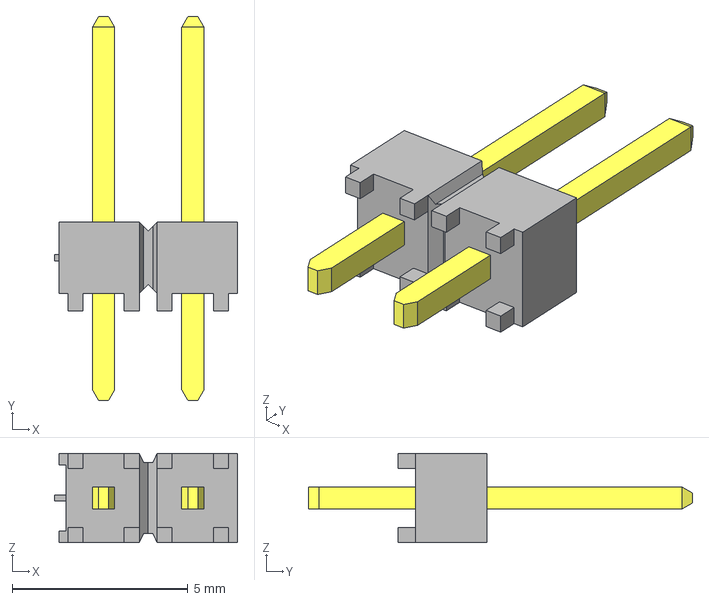
[picture p95: CAD file, 2026-06-11]
PCB/Schematics/mb1641_bdp/MB1641C/ALTIUM_EMBEDDED_MODELS/TSW-102-07-G-S.stp
5.21 x 10.9 x 2.54 mm
_TSW-102-07-G-S_body
_T-1S6-07-TSW-1-07-2-S
