LaphyB/senior-project/PCB/Schematics/mb1641_bdp/MB1641C/ALTIUM_EMBEDDED_MODELS/SMTU2032-LF.STEP

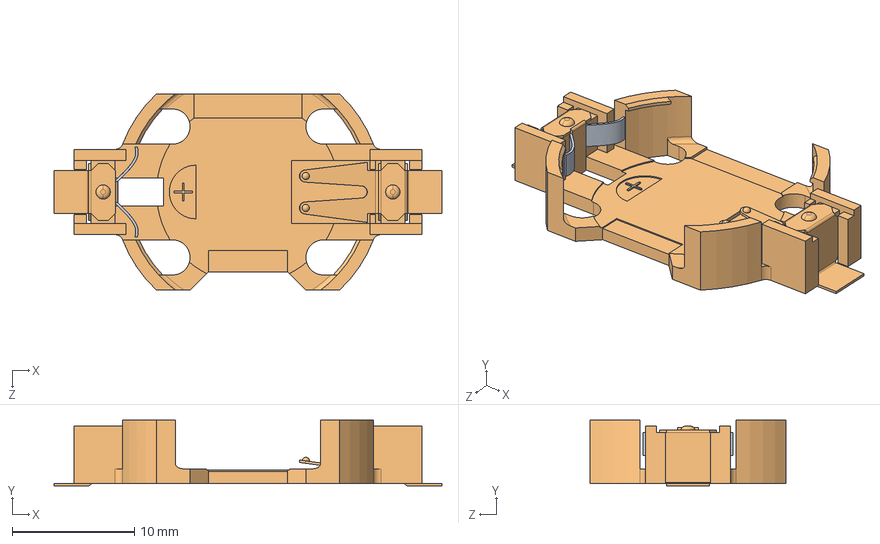
[picture p97: CAD file, 2026-06-11]
PCB/Schematics/mb1641_bdp/MB1641C/ALTIUM_EMBEDDED_MODELS/SMTU2032-LF.STEP
31.8 x 5.40 x 16.1 mm
