LaphyB/senior-project/PCB/Schematics/mb1641_bdp/MB1641C/ALTIUM_EMBEDDED_MODELS/Shield clip s0951-46.stp

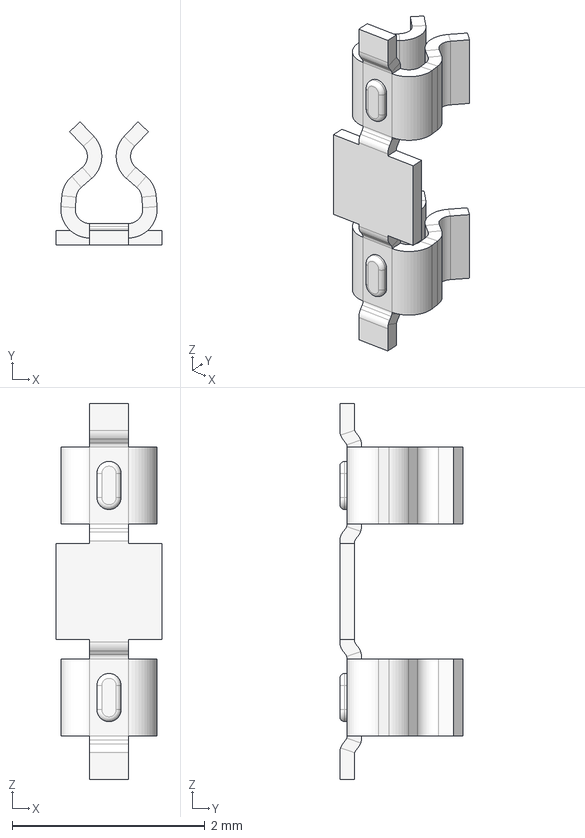
[picture p98: CAD file, 2026-06-11]
PCB/Schematics/mb1641_bdp/MB1641C/ALTIUM_EMBEDDED_MODELS/Shield clip s0951-46.stp
1.10 x 1.28 x 3.90 mm
