LaphyB/senior-project/PCB/Schematics/mb1641_bdp/MB1641C/ALTIUM_EMBEDDED_MODELS/SWI_MLL1200S.stp

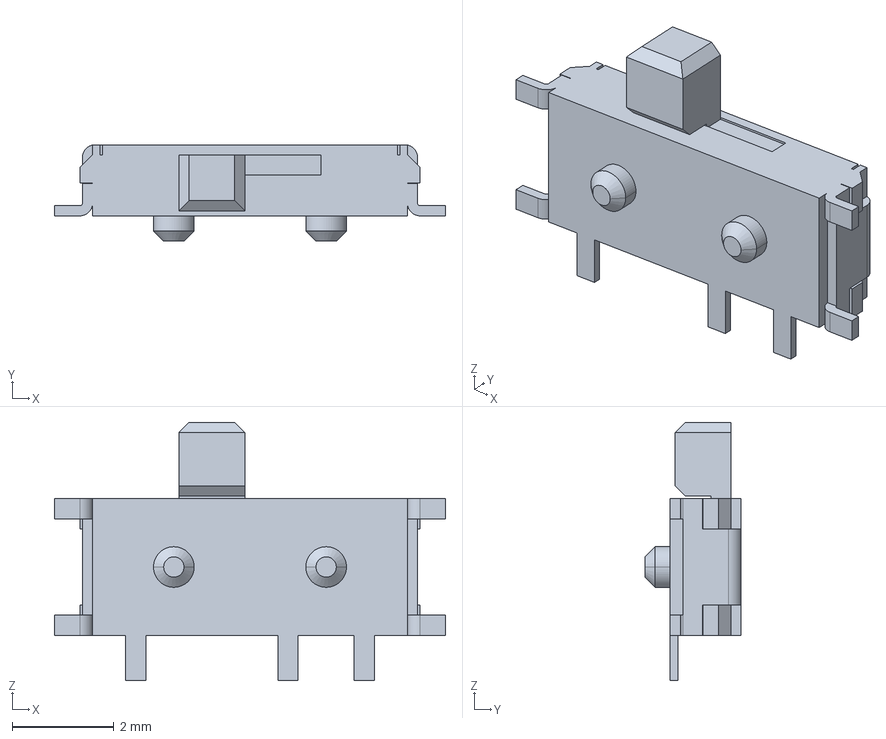
[picture p102: CAD file, 2026-06-11]
PCB/Schematics/mb1641_bdp/MB1641C/ALTIUM_EMBEDDED_MODELS/SWI_MLL1200S.stp
7.70 x 1.90 x 5.09 mm
