LaphyB/senior-project/PCB/Schematics/mb1641_bdp/MB1641C/ALTIUM_EMBEDDED_MODELS/pin_header_awl254-dg-g16d.stp

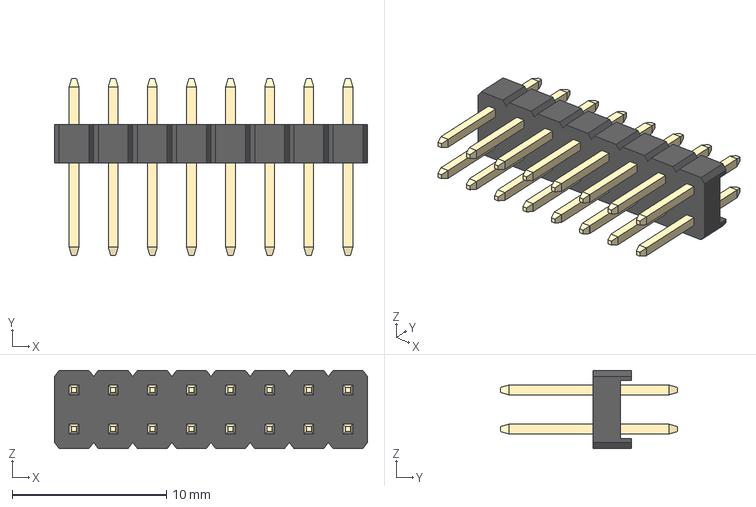
[picture p104: CAD file, 2026-06-11]
PCB/Schematics/mb1641_bdp/MB1641C/ALTIUM_EMBEDDED_MODELS/pin_header_awl254-dg-g16d.stp
20.3 x 11.5 x 5.08 mm
