LaphyB/senior-project/PCB/Schematics/mb1641_bdp/MB1641C/ALTIUM_EMBEDDED_MODELS/TSW-104-07-X-D.stp

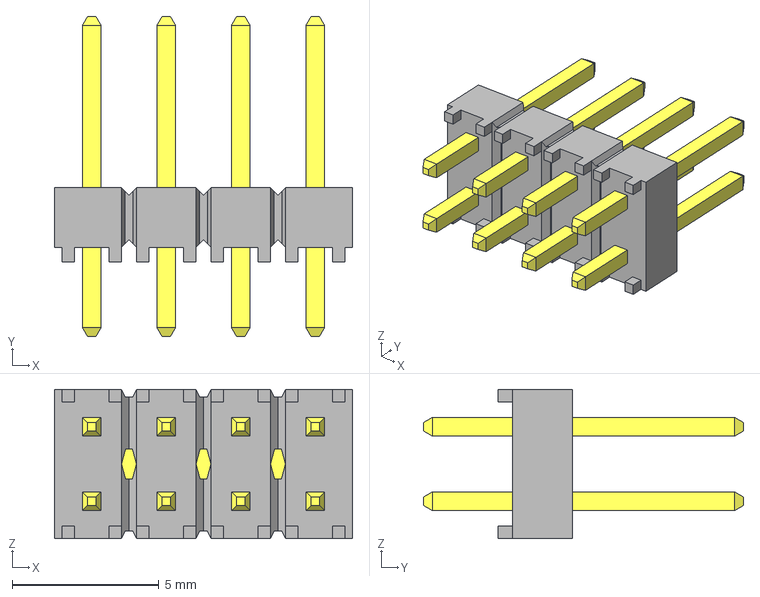
[picture p105: CAD file, 2026-06-11]
PCB/Schematics/mb1641_bdp/MB1641C/ALTIUM_EMBEDDED_MODELS/TSW-104-07-X-D.stp
10.2 x 10.9 x 5.08 mm
_TSW-104-07-G-D_body
_T-1S6-07-TSW-1-07-4-D
