LaphyB/senior-project/PCB/Schematics/mb1641_bdp/MB1641C/ALTIUM_EMBEDDED_MODELS/SSW-108-01-G-S.stp

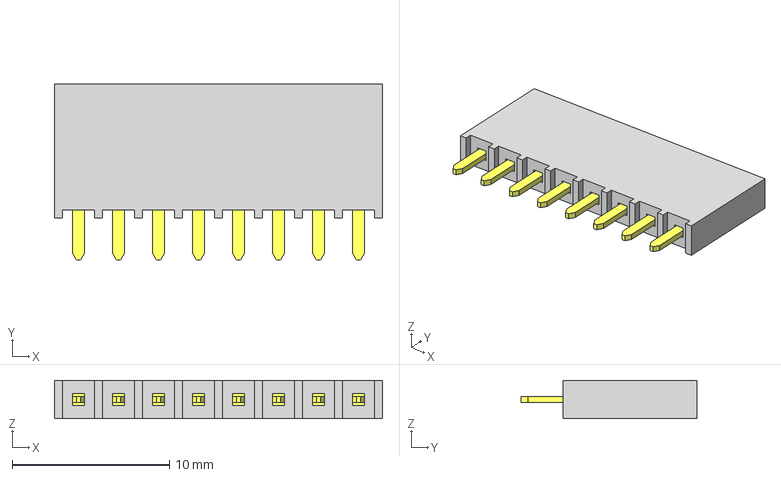
[picture p107: CAD file, 2026-06-11]
PCB/Schematics/mb1641_bdp/MB1641C/ALTIUM_EMBEDDED_MODELS/SSW-108-01-G-S.stp
20.8 x 11.2 x 2.41 mm
_T1SSW-108-01-G-S
_P2SSW-108-01-G-S
