LaphyB/senior-project/PCB/Schematics/mb1641_bdp/MB1641C/ALTIUM_EMBEDDED_MODELS/CR2032_Holder.STEP

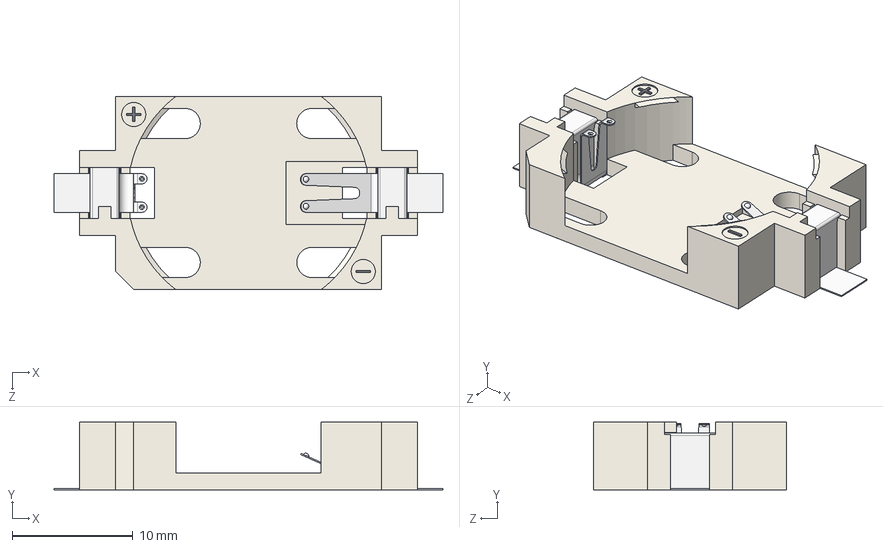
[picture p109: CAD file, 2026-06-11]
PCB/Schematics/mb1641_bdp/MB1641C/ALTIUM_EMBEDDED_MODELS/CR2032_Holder.STEP
32.2 x 5.60 x 16.0 mm
User Library-CR2032_Holder_Holder_Domyslna
User Library-CR2032_Holder_Pin_minus_Domyslna
User Library-CR2032_Holder_Pin_plus_Domyslna
