LaphyB/senior-project/PCB/Schematics/mb1641_bdp/MB1641C/ALTIUM_EMBEDDED_MODELS/SOT23-3_TO-236AB.STEP

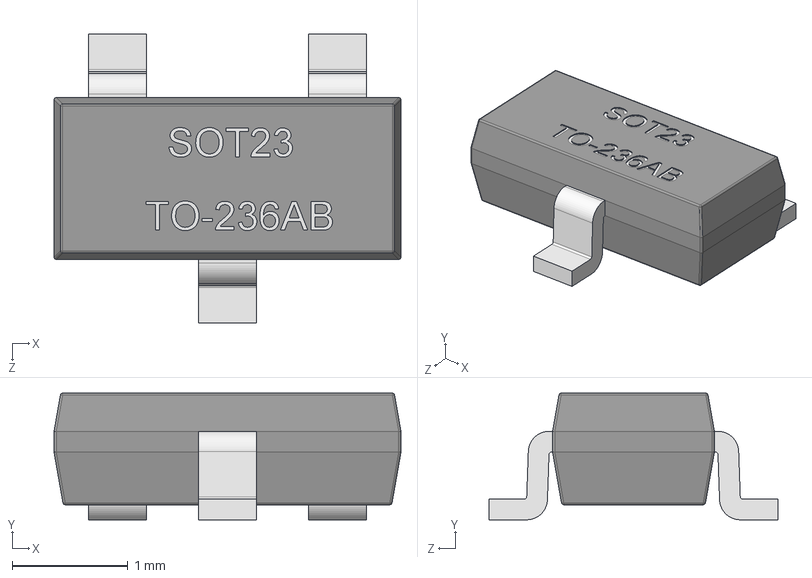
[picture p110: CAD file, 2026-06-11]
PCB/Schematics/mb1641_bdp/MB1641C/ALTIUM_EMBEDDED_MODELS/SOT23-3_TO-236AB.STEP
3.00 x 1.10 x 2.50 mm
