LaphyB/senior-project/PCB/Schematics/mb1641_bdp/MB1641C/ALTIUM_EMBEDDED_MODELS/Switch-CK-KMR2.STEP

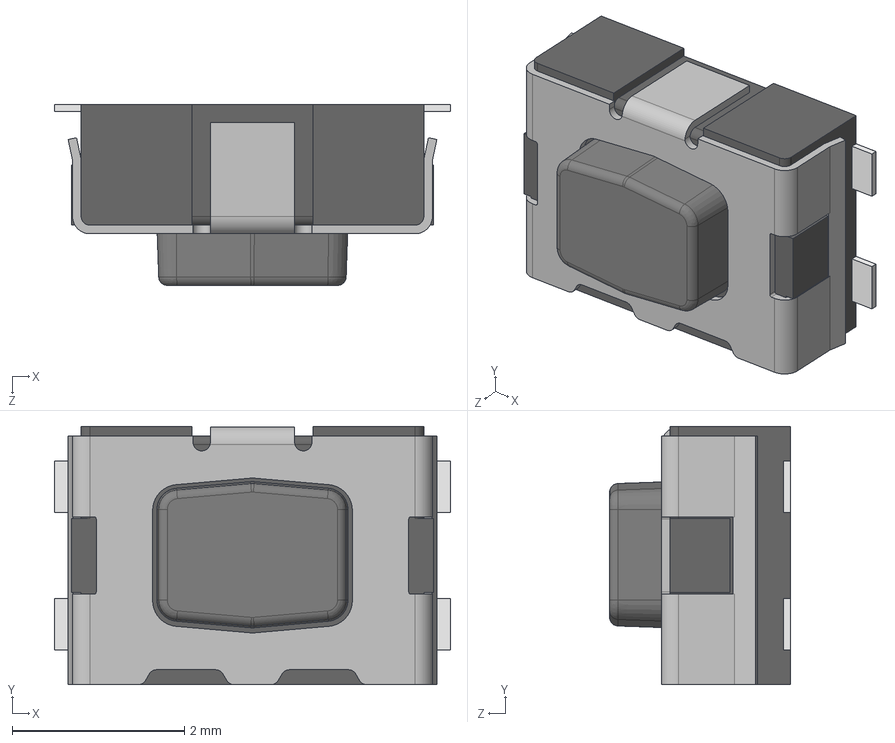
[picture p111: CAD file, 2026-06-11]
PCB/Schematics/mb1641_bdp/MB1641C/ALTIUM_EMBEDDED_MODELS/Switch-CK-KMR2.STEP
4.60 x 3.00 x 2.10 mm
User Library-Switch-CK-KMR2_Button
User Library-Switch-CK-KMR2_Boitier
User Library-Switch-CK-KMR2_Tole
User Library-Switch-CK-KMR2_Pads
