LaphyB/senior-project/PCB/Schematics/mb1641_bdp/MB1641C/ALTIUM_EMBEDDED_MODELS/TSSOP20_6P50X4P40_P065.STEP

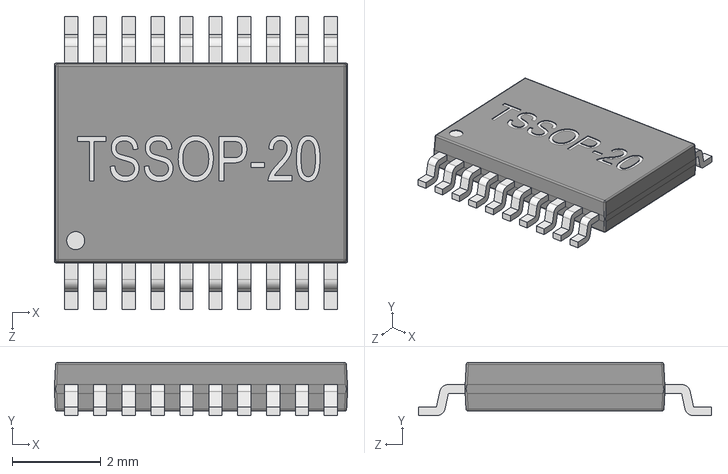
[picture p113: CAD file, 2026-06-11]
PCB/Schematics/mb1641_bdp/MB1641C/ALTIUM_EMBEDDED_MODELS/TSSOP20_6P50X4P40_P065.STEP
6.60 x 1.20 x 6.60 mm
