LaphyB/senior-project/PCB/Schematics/mb1641_bdp/MB1641C/ALTIUM_EMBEDDED_MODELS/STEP-WE-PMI-0805_STD-rev1.stp

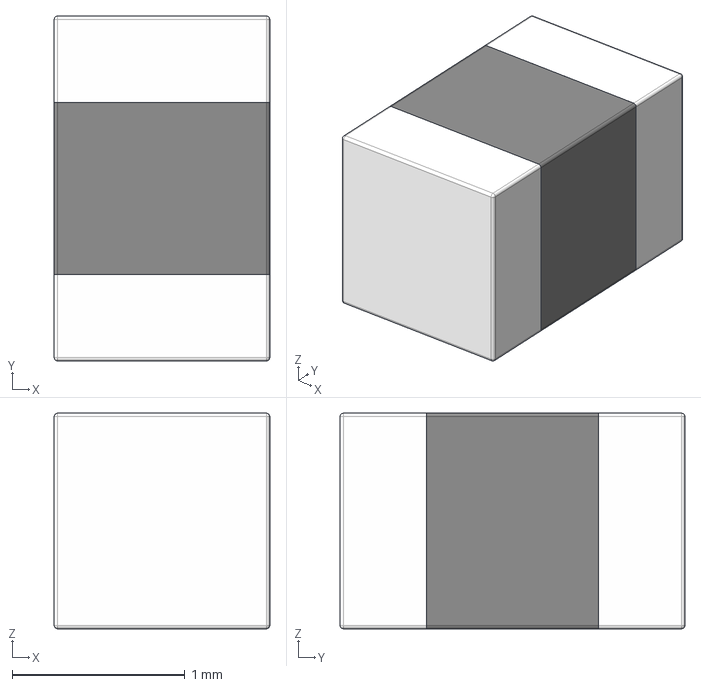
[picture p114: CAD file, 2026-06-11]
PCB/Schematics/mb1641_bdp/MB1641C/ALTIUM_EMBEDDED_MODELS/STEP-WE-PMI-0805_STD-rev1.stp
1.25 x 2.00 x 1.25 mm
core
