LaphyB/senior-project/PCB/Schematics/mb1641_bdp/MB1641C/ALTIUM_EMBEDDED_MODELS/INDC1005X50-MURATA_LQW15A.STEP

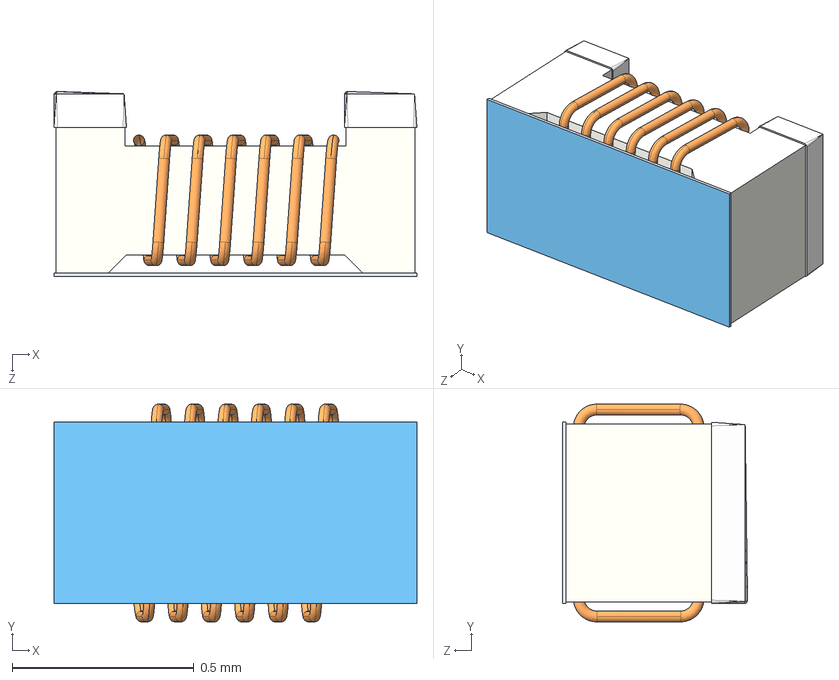
[picture p115: CAD file, 2026-06-11]
PCB/Schematics/mb1641_bdp/MB1641C/ALTIUM_EMBEDDED_MODELS/INDC1005X50-MURATA_LQW15A.STEP
1.00 x 0.6 x 0.51 mm
