LaphyB/senior-project/PCB/Schematics/mb1641_bdp/MB1641C/ALTIUM_EMBEDDED_MODELS/LQFP48_7X7_P050.STEP

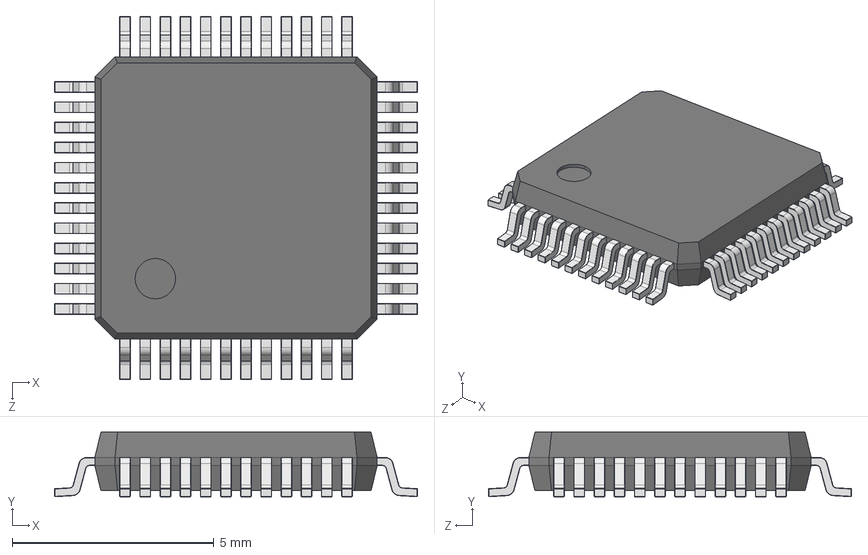
[picture p117: CAD file, 2026-06-11]
PCB/Schematics/mb1641_bdp/MB1641C/ALTIUM_EMBEDDED_MODELS/LQFP48_7X7_P050.STEP
9.00 x 1.60 x 9.00 mm
User Library-LQFP48_Grid_0.5_LQFP48_Koerper_2
User Library-LQFP48_Grid_0.5_LQFP_PIN_2 x 48
