LaphyB/senior-project/PCB/Schematics/mb1641_bdp/MB1641C/ALTIUM_EMBEDDED_MODELS/TSW-119-09-G-D.stp

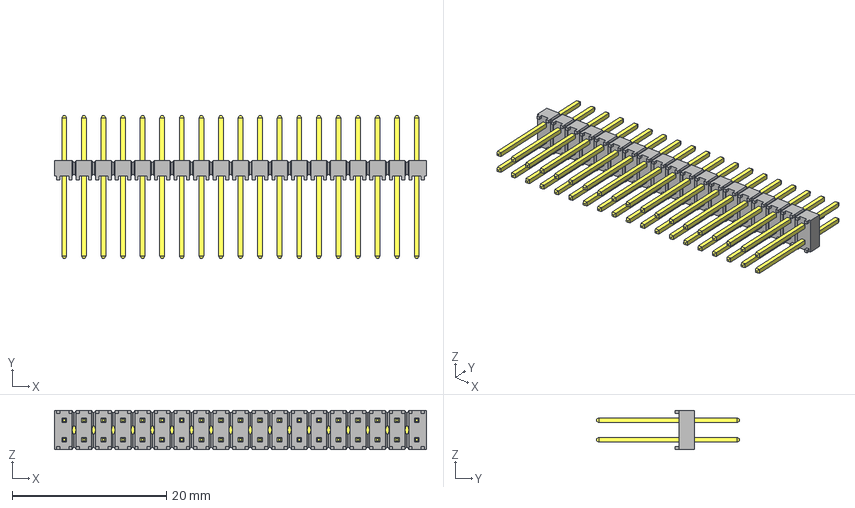
[picture p118: CAD file, 2026-06-11]
PCB/Schematics/mb1641_bdp/MB1641C/ALTIUM_EMBEDDED_MODELS/TSW-119-09-G-D.stp
48.3 x 18.5 x 5.08 mm
_TSW-119-09-G-D_body
_T-1S6-09-TSW-1-09-19-D
