LaphyB/senior-project/(list of files, cad)

Other CAD files:
CAD/ControllerButton.ipt
CAD/ControllerHandle.ipt
CAD/ControllerHead.ipt
CAD/ControllerHeadBottom.ipt
CAD/OldVersions/Button.0003.ipt
CAD/OldVersions/Controller Handle.0002.ipt
CAD/OldVersions/ControllerButton.0001.ipt
CAD/OldVersions/ControllerHandle.0006.ipt
CAD/OldVersions/ControllerHead.0011.ipt
CAD/OldVersions/ControllerHeadBottom.0006.ipt
CAD/OldVersions/ControllerHousing.0005.ipt
CAD/OldVersions/ControllerHousing.ipt
