LaphyB/senior-project/Documentation/Deliverables/Initial Test Plan/Completed Test Plan.docx

Landen Barber

Test Plan

Firstly, I emailed the Idea fest organizers about registering and they are allowing me to participate.

Not all tests are possible at the moment as I am waiting on the PCB, which was finally ordered, and should be arriving either Friday or Saturday. Once this arrives, I can assemble the controller and do more rigorous testing as it will be easier to test the functionality I plan to present at Idea fest.

I have also finished the 3d prints and am having a friend print them out for me so that I may be able to use them in the poster which I have started but think it will be better once I can include the actual parts when they come. I am hoping that the PCB will arrive by Friday so I can also include that in the poster, but if not, I can still use the 3d model but leave it hollow. Alternatively I can use an exterior printing method.

The software on the other hand, specifically the adaptive aspect and gyro control is basically complete, though these still need to be more rigorously tested once fitted in PCB.

## Parts or Modules

### 1 - ICM-20948

- Test Type: Parts / Module Test
- Test Method: Connecting ICM-20948 to Nucleo-WB15CC via I2c, be able to read gyro, accelerometer, and magnetometer values from both onboard chips and registers.
- Test Cases:
  - 1.1: Read from WHO_AM_I register
    - Expected value 0xEA [1]
    - Confirms that I2C communication is established and the device can identify itself
  - 1.2: Read Gyroscope values
    - Expected range: +-250dps - +-2000dps [1], get min and max values by moving as fast as possible and finding how quick it needs to be to activate a difference.
    - At rest should be close to +- 5dps [1], placing device level and moving different degrees to see a degree of change.
    - Reading should be averaged over 1 second.
  - 1.3: Read accelerometer values
    - Expected range: +-2g – +-16g [1]
  - 1.4: Read Magnetometer values
    - Expected wide range of +-4900uT [1]
    - Uses separate chip, WHO_AM_I should return 0x4809
- Test Goal: Make sure I2C connects correctly and can respond to errors. Verify that all three data types are accessible and returns plausible data.
- Test Result:
  - 1.1: PASS
    - 0xEA is passed from module ensuring it is working.
  - 1.2: PARTIAL PASS
  - 1.3: PARTIAL PASS
  - 1.4: PARTIAL PASS

### 2 - ADC / DMA

- Test Type: Parts / Module Test
- Test Method: Configuring ADC in scan conversion mode, and DMA in circular mode to read four axis inputs and write correct values to registers.
- Test Cases:
  - 2.1: ADC / DMA Starting without critical errors
    - HAL_ADC_Start_DMA() should return HAL_OK on completion [2]
  - 2.2: Read Joystick values at neutral position (expected value ~2048)
    - 12bit ADC (0-4095) [2]
    - Neutral value expected to be 2048 +- 100
  - 2.3: Check all directions of each joystick
    - Full range: min = 0-50 to max 4045-4095 depending on direction
    - <10ms per axis update
  - 2.4: Check both Joysticks
    - Verify ADC is placing data in correct spots.
- Test Goal: Ensure all four channels are correctly sampled automatically and does not block system.
- Test Result:
  - 2.1: PASS
    - Returned HAL_OK on startup
  - 2.2: PASS
    - J1: X: 2044 – 2049 Y: 2098 – 2101
    - J2: X: 2031 – 2037 Y: 2033 – 2039
  - 2.3: PASS
    - Joysticks measured full range.
  - 2.4: PASS
    - Data is being placed in correct registers.

### 3 - Powerboost 1000c Battery USB-C Charging

- Test Type: Parts / Module Test
- Test Method: Connecting charging circuit to board, changing board config to external power, plugging in and unplugging charger to test load sharing capability.
- Test Cases:
  - 3.1: Boost Output voltage from battery
    - Measuring GND and 5v pin with multimeter ~5.2v [3]
  - 3.2: Boost Output voltage while charging
    - Measuring GND and 5v pin with multimeter ~5.2v [3]
    - Charge current 1000mA max
  - 3.3: Normal Output from Battery
    - Measuring GND and 5v pin with multimeter ~3.3v [4]
  - 3.4: Normal Output while charging
    - Measuring GND and 5v pin with multimeter ~3.3v [4]
  - 3.5: No power outage when switching load source
    - Seamless transition because of load sharing circuit [3]
  - 3.6: Output voltage at max load
    - Max 1000mA of continuous draw [3]
    - Stays above 5v when low charge [3]
  - 3.7: Low battery voltage cutoff
    - Red LED lights up at low charge (battery outputting below 3.2v)
    - Boost converter cuts off below 3v
- Test Goal: Verify 5v output to microcontroller and load sharing capability when charging.
- Test Result:
  - 3.1: PASS
    - Multimeter reads 5.14v under load with charged battery.
  - 3.2: PASS
    - Multimeter reads 5.16v while battery charging and under load.
  - 3.3: PASS
    - Multimeter reads 3.61v from battery.
  - 3.4: PASS
    - Multimeter reads 4.56v from battery while charging.
  - 3.5: PASS
    - Plugging in and unplugging charging cable does not interrupt program operation.
  - 3.6: PASS
    - Automatically shuts off when falling below ~5.02v (Last checked num)
  - 3.7: PASS
    - Red light on power boost works, currently no ADC can take in voltage.

### 4 - Bluetooth Low Energy

- Test Type: Parts / Module Test
- Test Method: Using STM BLE stack, connect and monitor Bluetooth connection and reconnections.
- Test Cases:
  - 4.1: Enter pairing mode when holding button (resetting)
    - Press and hold for 3-5 seconds,
    - BLE advertising at 20-30ms [2]
    - Timeout after 60 seconds of no pairing
  - 4.2: Pair with windows PC
    - 15-30ms connection interval [2]
    - HID mouse report rate 125Hz minimum to optimal 1000Hz [5]
  - 4.3: auto reconnect with last paired device when powered on or disconnected
- Test Goal: Validate Bluetooth pairing functionality, auto reconnection, and range.
- Test Result:
  - 4.1: PARTIAL PASS
  - 4.2: PARTIAL PASS
  - 4.3: PARTIAL PASS

### 5 – Buttons

- Test Type: Parts / Module Test
- Test Method: Using STM GPIO pull-up resistors, connect all buttons.
- Test Cases:
  - 5.1: All buttons working
    - Low: connect to GND (0v)
    - Release: pin reads High (~3.3v)
  - 5.2: Button debouncing working
    - Debounce delay: 20ms
    - Single press activates single button, no multiple counts
- Test Goal: Validate Button functionality without blocking and button debounce
- Test Result:
  - 5.1: PASS
    - All buttons working independently and continuously updating.
  - 5.2: PASS
    - Buttons are not double triggering, not blocking program.

### 6 – Haptic Motor

- Test Type: Parts / Module Test
- Test Method: Using STM GPIO output, enable haptic motors.
- Test Cases:
  - 6.1: Haptic motors working at different strengths
    - PWM at 150Hz to 250Hz
  - 6.2: Haptic motors differentiated
    - Motors can be controlled independently or simultaneously
    - Non-blocking program
- Test Goal: Validate Haptic Motor functionality without blocking
- Test Result:
  - 6.1: NA
    - Unimplemented
  - 6.2: PASS
    - They can be controlled independently, not blocking.

### 7 – Battery indicator LED and voltage detection

- Test Type: Parts / Module Test
- Test Method: Using STM GPIO output and adc, test battery voltage and display on LED.
- Test Cases:
  - 7.1: LED working
    - 3.3v High (White light)
  - 7.2: LED blinking at different speeds for voltage differences
    - Read battery voltage from ADC, Clamp to blinking speeds
  - 7.3: LED blinking to signify BLE pairing mode
    - Fast blinking for pairing mode
    - Successful pairing makes short pattern before writing battery voltage
- Test Goal: Validate LED functionality at different voltage levels and system states
- Test Result:
  - 7.1: PASS
    - LED blinking properly, not too bright, not blocking when blinking at different rates.
  - 7.2: NA
    - Unimplemented
  - 7.3: PARTIAL PASS

### 8 – One handed symmetrical layout

- Test Type: Parts / Module Test
- Test Method: Can use full functionality with only one hand
- Test Cases:
  - 8.1: Turn on controller and test main features to make sure they are comfortable and usable with one hand
    - All buttons reachable
  - 8.2: Use strap wave hand around to ensure stability
    - Accelerometer tracking rapid hand movements without loosening grip
  - 8.3: Drop from heights to ensure durability
    - Drop from 1-2m onto carpet
    - Drop .5m on hard floor
- Test Goal: Validate LED functionality at different voltage levels and system states
- Test Result:
  - 8.1: NA
    - Parts not acquired yet.
  - 8.2: NA
    - Parts not acquired yet.
  - 8.3: NA
    - Parts not acquired yet.

## Functionalities

### 9 - Gyro as mouse cursor

- Test Type: Functionalities Test
- Test Method: Connect controller to PC via BLE as an HID mouse, move controller to observer cursor movement on screen. Test pixel movement relative to different sensitivities to get better measurements and expected values.
- Test Cases:
  - 9.1: Moving controller allows Cursor to follow
    - Rotation of 10 deg moves cursor 100-300 pixels (dependent on sensitivity)
    - Response latency <30ms [2]
  - 9.2: Small tilt (low sensitivity mode for precise movement)
    - Eliminate cursor jitter: when <5pixels at rest
  - 9.3: Large tilt (high sensitivity mode for fast movement)
    - < 60deg motion, maximum cursor speed > 2000 pixels/second
  - 9.4: Orientation pausing button working to allow readjustment
    - Freeze cursor movement while button is held.
    - No abrupt cursor jumping after release.
- Test Goal: Verify gyro to cursor movement algorithm and functionality
- Test Result:
  - 9.1: FAIL
    - Further Testing Needed
  - 9.2: PARTIAL PASS
    - Further Testing Needed
  - 9.3: PARTIAL PASS
    - Further Testing Needed
  - 9.4: PASS
    - Button blocks HID signals, allowing movement without controlling pc.

### 10 - Gesture Recognition

- Test Type: Functionalities Test
- Test Method: Perform predefined gesture movements to activate commands
- Test Cases:
  - 10.1: Quick swipe up/down/left/right to activate simple flick gesture
    - Angular velocity threshold >200deg/sec, min distance 15deg
    - Aim to have 95% detection rate for intentional gestures
  - 10.2: Quick tilt left to activate simple gesture
    - 300ms detection window
    - Recognize when a gesture fails to activate
  - 10.3: Slow movement for no gesture
    - If angular velocity <150deg/sec, gesture not triggered
  - 10.4: Adjustable threshold values
    - Highly adjustable thresholds for filter strength, gesture sensitivity(like 200-400deg/s to trigger), minimum distance threshold 30deg
- Test Goal: Verify gestures are recognized and detected reliably
- Test Result:
  - 10.1:
  - 10.2:
  - 10.3:
  - 10.4:

### 11 - Adaptive analyzer

- Test Type: Functionalities Test
- Test Method: Simulate a user with exaggerated values / movements, and allow it to change setting back to acceptable values.
- Test Cases:
  - 11.1: User always flicks quickly, increase threshold
    - If 10 gestures with velocity > 400deg/s, increase threshold by 10-20% (check for min and max values)
  - 11.2: User flicks slowly, decrease threshold
    - After 10 gestures with velocity < 250deg/sec, decrease threshold by 10-20%
    - You should acclimate to user in ~100 gestures.
  - 11.3: User fails to activate gesture, increase timing window
    - If three failures trigger a gesture within 60 sec, increase timing window 50-100ms.
  - 11.4: User is slow to activate gesture, decrease timing window
    - If failure to activate gestures within timing window happens over three times, decrease the timing window by 10-20%
  - 11.5: Settings persist after power off
    - Store vital settings in flash memory for quicker boot
    - After power cycle, settings will be retained.
- Test Goal: Verify system can learn from historical values and adjust settings accordingly.
- Test Result:
  - 11.1:
  - 11.2:
  - 11.3:
  - 11.4:
  - 11.5:

### 12 - Screen Overlay

- Test Type: Functionalities Test
- Test Method: Launch overlay on PC window via controller button, navigate using controller or pc inputs.
- Test Cases:
  - 12.1: Open overlay
    - Window appears in ~200ms after holding button
  - 12.2: Close overlay
    - Window closes within 100ms of closing press
  - 12.3: Change gyro sensitivity or other settings
  - 12.4: Save settings to controller storage
    - Save operation completes in less than 400ms
    - Events can be saved in under 300ms
- Test Goal: Verify overlay is usable with just controller and saves settings
- Test Result: NA, Unimplemented

### 13 – Digital Keyboard

- Test Type: Functionalities Test
- Test Method: Launch digital keyboard on pc and usable with joystick.
- Test Cases:
  - 13.1: Open digital keyboard on PC window
    - Keyboard opens within 300ms of pressing button.
    - Window size adjustable, default could be 1000x500pixels in standard layout.
  - 13.2: Pressing buttons emulates keyboard input
    - < 50ms latency from button press to make cursor click and type in key like keyboard.
- Test Goal: Verify keyboard functionality with joystick navigation.
- Test Result: NA, Unimplemented

### 14 – Settings / Key bind Editor

- Test Type: Functionalities Test
- Test Method: Using overlay to adjust and change various settings and key binds using joystick or pc controls.
- Test Cases:
  - 14.1: Open/Close setting editor on PC window
    - Editor opens in ~300ms
    - Takes ~150ms to save to storage
  - 14.2: Change settings using joystick or pc controls
    - Can use joystick/gyr controls or computer mouse to change settings if unusable with current settings.
  - 14.3: Save settings to local storage
    - Save in a readable format that can be duplicated to make multiple profiles.
- Test Goal: Verify setting editor functionality and immediate application.
- Test Result: NA, Unimplemented

### 15 – Profile Management

- Test Type: Functionalities Test
- Test Method: Create and switch between multiple profiles via overlay.
- Test Cases:
  - 15.1: Create two profiles with different settings
    - Can switch between profiles without power cycling
    - Takes less than 200ms to switch between profiles
  - 15.2: Switch between two profiles and test controller functionality to ensure settings are applied
  - 15.3: Load profile after power cycling
    - Default profile can be set to be loaded after powering on
    - Boots in less than 750ms
  - 15.4: Delete a Profile
    - After deletion and confirmation, profile is removed from list and gives back storage.
- Test Goal: Verify keyboard functionality with joystick navigation.
- Test Result: NA, Unimplemented

## References

[1] https://www.adafruit.com/product/4554

[2] https://www.st.com/en/microcontrollers-microprocessors/stm32wb-series/documentation.html

[3] https://www.adafruit.com/product/2465

[4] https://www.adafruit.com/product/1578

[5] https://www.nordicsemi.com/Applications/HID
