LaphyB/senior-project/Documentation/Test Plan and Results.xlsx

Test Plan and Result Template
Project Name | Adaptive Gyro Controller
Engineer | Landen Barber
Test Plan Date and update dates | Created: 4/4/2026 | Updated: 5/18/26, 5/25/26, 5/26/26, 5/27/26
Requir+B4+A5:F6+A5:C6+A5+A5:F6 | Requirement Number2 | Requirement Description | Percent Complete | Test methodology | Test Equipment | Special test condition | Test Disposition | Test Date | Test Trial No. | Associated test document | Test Notes
Design? Functionalities? Performance? | Requirement Number from requirements doc. | Succintly desribe your requirement. If original requirement is too big, you can break down into multiple rows. | List pct complete | How was this requirement tested? Press ALT+ENTER for new line in Excel | List any test equipment used for the test | List any special conditions for your test | PASS, FAIL, PARTIAL PASS | List the planned date or run | List number of test attempts | List associated test documents here by file name indicating proof of successful test. Place the documents into the same folder as this template | You can make a memo of your observation or follow-up actions needed. You should make a separate table if you tried multiple times. The multiple trials are really key food for your evaluation section.
 | 1 | ICM-20948
 | 1.1 | Read from WHO_AM_I register | 100% | Expected value 0xEA |  |  | PASS | 2026-06-12 | 1 |  | The Who_am_i register for both the ICM20948 and magnetometer chip produced the correct who am I values, this means that the modules are properly set up and is outputting data in a readable format.
 | 1.2 | Read Gyroscope values | 90% | Expected range: +-250dps - +-2000dps, get min and max values by moving as fast as possible and finding how quick it needs to be to activate a difference |  |  | PARTIAL PASS | 2026-06-12 | 2 |  | The data detected here is averaged over 5 seconds, though the Y value is accurate at -3 average, the X values average is a bit higher at -153, though this value is manageable and is easily corrected by bias correction. It is also worth noting that the Z axis is broken and averages 2600 and for some reason no longer moves when tilting the device.
 | 1.3 | Read accelerometer values | 100% | Expected range: +-2g – +-16g [1] |  |  | PASS | 2026-06-12 | 2 |  | The accelerometer values, though not visible in testing image, demonstrate a full range from -16000 to 16000 depending on the orientation of the device. The numbers shown display the average numbers when at rest upright.
 | 1.4 | Read Magnetometer values | 100% | Expected wide range of +-4900uT [1] Uses separate chip, WHO_AM_I should return 0x4809 |  |  | PASS | 2026-06-12 | 2 |  | Magnetometer is similar to the accelerometer where numbers are off from the expected but show a full range that can be used to set boundaries. X ranges -30 to 50, Y ranges 0 to -40, and Z ranges -30 to 70.
 | 2 | ADC / DMA Testing
 | 2.1 | ADC / DMA Starting without critical errors | 100% | HAL_ADC_Start_DMA() should return HAL_OK on completion |  |  | PASS | 2026-06-12 | 1 |  | The code is set up to hang on a while loop if any errors were to occur in initializing either the ADC or DMA so these pass.
 | 2.2 | Read Joystick values at neutral position (expected value ~2048) | 100% | 12bit ADC (0-4095) [2] Neutral value expected to be 2048 +- 100 |  |  | PASS | 2026-06-12 | 1 |  | Though JS2’s X value is a little low, all of the values are within expectations.
 | 2.3 | Check all directions of each joystick | 90% | Full range: min = 0-50 to max 4045-4095 depending on direction <10ms per axis update |  |  | PARTIAL PASS | 2026-06-12 | 1 |  | All values except for the JS2 X value reach the full range comfortably, this is because of a PCB trace mistake linking it to ground.
 | 2.4 | Check both Joysticks | 100% | Verify ADC is placing data in correct spots. |  |  | PASS | 2026-06-12 | 1 |  | All values are being placed into correct register locations, I can easily tell by holding one axis at 0 and watching other values remain > that that number near ~2000.
 | 3 | Powerboost 1000c Battery USB-C Charging |  |  |  |  |  |  |  |  | By using a multimeter, output voltages are within range for both boosted and battery outputs. In order of 1-4, read values were 5.14v, 5.16v, 3.56v, 3.61v
 | 3.1 | Boost Output voltage from battery | 100% | Measuring GND and 5v pin with multimeter ~5.2v [3] | Multimeter |  | PASS | 2026-06-12 | 1
 | 3.2 | Boost Output voltage while charging | 100% | Measuring GND and 5v pin with multimeter ~5.2v [3] Charge current 1000mA max | Multimeter |  | PASS | 2026-06-12 | 1
 | 3.3 | Normal Output from Battery | 100% | Measuring GND and 5v pin with multimeter ~3.3v [4] | Multimeter |  | PASS | 2026-06-12 | 1
 | 3.4 | Normal Output while charging | 100% | Measuring GND and 5v pin with multimeter ~3.3v [4] | Multimeter |  | PASS | 2026-06-12 | 1
 | 3.5 | No power outage when switching load source | 100% | Seamless transition because of load sharing circuit [3] | Multimeter |  | PASS | 2026-06-12 | 1 |  | Plugging in and unplugging charge cable does not interrupt controller operation.
 | 3.6 | Output voltage at max load | 100% | Max 1000mA of continuous draw [3] Stays above 5v when low charge [3] | Multimeter |  | PASS | 2026-06-12 | 1
 | 3.7 | Low battery voltage cutoff | 100% | Red LED lights up at low charge (battery outputting below 3.2v) Boost converter cuts off below 3v | Multimeter |  | PASS | 2026-06-12 | 1 |  | Power circuit automatically cut off when voltage fell below ~5.02v. Successfully recharged and operational again after some time.
 | 4 | Bluetooth Low Energy
 | 4.1 | Enter pairing mode when holding button (resetting) | 0% |  |  |  | UNIMPLEMENTED |  | 3 |  | Currently you must disconnect from pc to start pairing with something else.
 | 4.2 | Pair with windows PC | 100% |  |  |  | PASS | 2026-06-12 | 3 |  | HID reports are being sent at an average of 900Hz, this is much better than expected due to the dedicated M0 BLE core.
 | 4.3 | auto reconnect with last paired device when powered on or disconnected | 100% |  |  |  | PASS | 2026-06-12 | 3 |  | Controller automatically pairs with last known device when powered on and disconnected.
 | 5 | Buttons Testing
 | 5.1 | All buttons working | 85% | Low: connect to GND (0v) Release: pin reads High (~3.3v) |  |  | PARTIAL PASS | 2026-06-12 | 1 |  | Most buttons working, small issue with JS2 where the SEL button is tied to ground because of PCB design mistake.
 | 5.2 | Button debouncing working | 100% | Debounce delay: 20ms Single press activates single button, no multiple counts |  |  | PASS | 2026-06-12 | 1 |  | Button debouncing works correctly and preventing double triggers.
 | 6 | Haptic Motor
 | 6.1 | Haptic motors working at different strengths | 0% | PWM at 150Hz to 250Hz |  |  | UNIMPLEMENTED |  | 1
 | 6.2 | Haptic motors differentiated | 100% | Motors can be controlled independently or simultaneously Non-blocking program |  |  | PASS | 2026-06-12 | 1 |  | Motors can be activated individually, and timed functions properly last a specified amount of time without blocking.
 | 7 | Battery indicator LED and voltage detection
 | 7.1 | LED working | 100% | 3.3v High (White light) |  |  | PASS | 2026-06-12 | 1 |  | Properly wired up, ground was not working on PCB design, but after disconnecting trace with knife and resoldering, LED is working fine.
 | 7.2 | LED blinking at different speeds for voltage differences | 0% | Read battery voltage from ADC, Clamp to blinking speeds |  |  | UNIMPLEMENTED |  | 1 |  | oltage is not passed into an open ADC slot to read output.
 | 7.3 | LED blinking to signify BLE pairing mode | 0% | Fast blinking for pairing mode Successful pairing makes short pattern before writing battery voltage |  |  | UNIMPLEMENTED |  | 1 |  | BLE currently doesn’t have the pairing functionality so this is impossible.
 | 8 | One handed symmetrical layout
 | 8.1 | Turn on controller and test main features to make sure they are comfortable and usable with one hand | 80% | All buttons reachable |  |  | PARTIAL PASS | 2026-06-12 | 1 |  | Controller is light and handle is somewhat comfortable, but joysticks are too far away to be used with one hand.
 | 8.2 | Use strap wave hand around to ensure stability | 0% | Accelerometer tracking rapid hand movements without loosening grip |  |  | UNIMPLEMENTED |  | 1
 | 8.3 | Drop from heights to ensure durability | 0% | Drop from 1-2m onto carpet Drop .5m on hard floor |  |  | UNTESTED |  | 1 |  | Too scared to test.
 | 9 | Gyro as Mouse Cursor
 | 9.1 | Moving controller allows Cursor to follow | 95% | Rotation of 10 deg moves cursor 100-300 pixels (dependent on sensitivity) Response latency <30ms [2] |  |  | PARTIAL PASS | 2026-06-12 | 1 |  | Working with HID reports, but not quick enough/movement not smooth enough as it is still too noticeable. HID reports above move relative to last position.
 | 9.2 | Small tilt (low sensitivity mode for precise movement) | 90% | Eliminate cursor jitter: when <5pixels at rest |  |  | PARTIAL PASS | 2026-06-12 | 1 |  | Implemented but needs to be adjusted as it is almost always active.
 | 9.3 | Large tilt (high sensitivity mode for fast movement) | 80% | < 60deg motion, maximum cursor speed > 2000 pixels/second |  |  | PARTIAL PASS | 2026-06-12 | 1 |  | Implemented but needs to be adjusted as it is still conflicting with gesture activation. It needs to be a middle ground between low sensitivity mode and gesture activation.
 | 9.4 | Orientation pausing button working to allow readjustment | 100% | Freeze cursor movement while button is held. No abrupt cursor jumping after release. |  |  | PASS | 2026-06-12 | 1 |  | Working perfectly, HID reports stopped when active.
 | 10 | Gesture Recognition
 | 10.1 | Quick swipe up/down/left/right to activate simple flick gesture | 100% | Angular velocity threshold >200deg/sec, min distance 15deg Aim to have 95% detection rate for intentional gestures |  |  | PASS | 2026-06-12 | 1 |  | All four flick states are properly detected.
 | 10.2 | Quick tilt left to activate simple gesture | 90% | 300ms detection window Recognize when a gesture fails to activate |  |  | FAIL | 2026-06-12 | 1 |  | Currently it is impossible because of broken Z access on gyro. Though they were working previously.
 | 10.3 | Slow movement for no gesture | 100% | If angular velocity <150deg/sec, gesture not triggered |  |  | PASS | 2026-06-12 | 1 |  | Simultaneously working with the Gyro to Mouse algorithm proves that this is working, as gestures are not detected with a high enough threshold value, but allows cursor to move.
 | 10.4 | Adjustable threshold values | 100% | Highly adjustable thresholds for filter strength, gesture sensitivity(like 200-400deg/s to trigger), minimum distance threshold 30deg |  |  | PASS | 2026-06-12 | 1 |  | Threshold values above are stored in microSD and used in gesture detection properly. Running adaptive analyzer changes this value.
 | 11 | Adaptive Analyzer
 | 11.1 | User always flicks quickly, increase threshold | 100% | If 10 gestures with velocity > 400deg/s, increase threshold by 10-20% (check for min and max values) |  |  | PASS | 2026-06-12 | 1 |  | Based on images above threshold increased from 500 to 7500 to 16551 to 26457. This was done several times in order to ensure its functionality.
 | 11.2 | User flicks slowly, decrease threshold | 100% | After 10 gestures with velocity < 250deg/sec, decrease threshold by 10-20% You should acclimate to user in ~100 gestures. |  |  | PASS | 2026-06-12 | 1 |  | Based on figure 34, the config breaker command turned the threshold to 45000 and ran the adaptive analyzer. In response the algorithm changed the threshold value back down to an acceptable level of 24035. This was done multiple five times to determine that this functionality was working.
 | 11.3 | User fails to activate gesture, increase timing window | 100% | If three failures trigger a gesture within 60 sec, increase timing window 50-100ms. |  |  | PASS | 2026-06-12 | 1 |  | Alongside the changes to threshold, the timing window also increased in the tests above, increasing the timing window from 200 all the way up to 1500ms.
 | 11.4 | User is slow to activate gesture, decrease timing window | 100% | If failure to activate gestures within timing window happens over three times, decrease the timing window by 10-20% |  |  | PASS | 2026-06-12 | 1 |  | ure 35, Timing window was set to a high number 5000ms, running the adaptive analyzer successfully brought it back down to 475ms which is a more reasonable number. After running multiple times number went up and down, settling at 423ms. Was not working at first but after changing a few signs of the implementation code it began to work.
 | 11.5 | Settings persist after power off | 100% | Store vital settings in flash memory for quicker boot After power cycle, settings will be retained. |  |  | PASS | 2026-06-12 | 1 |  | Though this should fall under a data logger testing tab, settings are properly saved between power cycles. Resetting the device is instantiated with the last known threshold of 26457. This also works with the other config settings when printed out.
 | 12 | Screen Overlay
 | 12.1 | Open Overlay | 0% | Window appears in ~200ms after holding button |  |  | UNIMPLEMENTED |  | 1
 | 12.2 | Close Overlay | 0% | Window closes within 100ms of closing press |  |  | UNIMPLEMENTED |  | 1
 | 12.3 | Change gyro sensitivity or other settings | 0% |  |  |  | UNIMPLEMENTED |  | 1
 | 12.4 | Save settings to controller storage | 100% | Save operation completes in less than 400ms Events can be saved in under 300ms |  |  | UNIMPLEMENTED |  | 1
 | 13 | Digital Keyboard
 | 13.1 | Open digital keyboard on PC window | 0% | Keyboard opens within 300ms of pressing button. Window size adjustable, default could be 1000x500pixels in standard layout. |  |  | UNIMPLEMENTED |  | 1
 | 13.2 | Pressing buttons emulates keyboard input | 0% | < 50ms latency from button press to make cursor click and type in key like keyboard. |  |  | UNIMPLEMENTED |  | 1
 | 14 | Settings / Key bind Editor
 | 14.1 | Open/Close setting editor on PC window | 0% | Editor opens in ~300ms Takes ~150ms to save to storage |  |  | UNIMPLEMENTED |  | 1
 | 14.2 | Change settings using joystick or pc controls | 0% | Can use joystick/gyr controls or computer mouse to change settings if unusable with current settings. |  |  | UNIMPLEMENTED |  | 1
 | 14.3 | Save settings to local storage | 0% | Save in a readable format that can be duplicated to make multiple profiles. |  |  | UNIMPLEMENTED |  | 1
 | 15 | Profile Management
 | 15.1 | Create two profiles with different settings | 0% | Can switch between profiles without power cycling Takes less than 200ms to switch between profiles |  |  | UNIMPLEMENTED |  | 1
 | 15.2 | Switch between two profiles and test controller functionality to ensure settings are applied | 0% |  |  |  | UNIMPLEMENTED |  | 1
 | 15.3 | Load profile after power cycling | 0% | Default profile can be set to be loaded after powering on Boots in less than 750ms |  |  | UNIMPLEMENTED |  | 1
 | 15.4 | Delete a Profile | 0% | After deletion and confirmation, profile is removed from list and gives back storage. |  |  | UNIMPLEMENTED |  | 1
