LaphyB/senior-project/(list of files, drawings)

Other design files:
PCB/Schematics/mb1641_bdp/MB1641C/Arduino_Mopho_Connectors.SchDoc
PCB/Schematics/mb1641_bdp/MB1641C/HW_Mechanical_Parts.SchDoc
PCB/Schematics/mb1641_bdp/MB1641C/MB1641.PrjPcb
PCB/Schematics/mb1641_bdp/MB1641C/MB1641_TOP.SchDoc
PCB/Schematics/mb1641_bdp/MB1641C/Power.SchDoc
PCB/Schematics/mb1641_bdp/MB1641C/Project_Overview.SchDoc
PCB/Schematics/mb1641_bdp/MB1641C/RF.SchDoc
PCB/Schematics/mb1641_bdp/MB1641C/STLINK_V2-1.SCHDOC
PCB/Schematics/mb1641_bdp/MB1641C/STM32_microcontroller_IOs.SchDoc
