LaphyB/senior-project/PCB/Schematics/2-axis-joystick-breakout-board-with-mounting-holes-master/joystick.kicad_pcb

## KiCad design PCB/Schematics/2-axis-joystick-breakout-board-with-mounting-holes-master/joystick.kicad_pcb (2026-06-11)

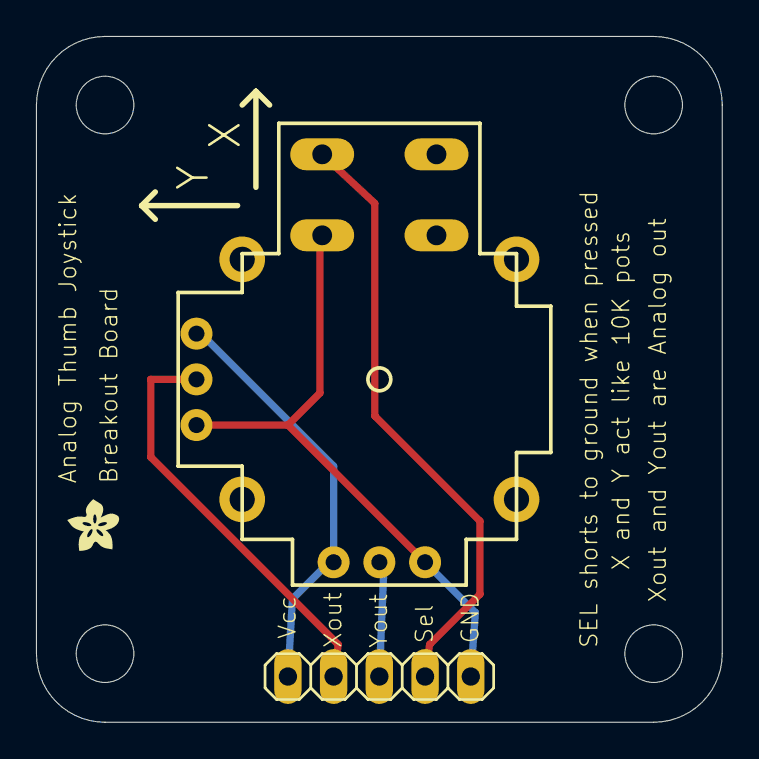
[picture p126: board joystick.kicad_pcb from above]

Board: 16 copper layers, 38.1 x 38.1 mm, 7 parts (0 on the bottom side), 5 nets.

Parts:
@HOLE0, @HOLE1, @HOLE2, @HOLE3: (no value)
JP1: 1X05
U1: JOYSTICKPTH; JOYSTICK
U$1: ADAFRUIT200MIL

Connections:
unnamed: JP1.5, U1.H1, U1.V1
unnamed: JP1.1, U1.B2A, U1.H3, U1.V3
unnamed: JP1.4, U1.V2
unnamed: JP1.3, U1.H2
unnamed: JP1.2, U1.B1A
