LaphyB/senior-project/PCB/Schematics/Adafruit-USB-C-Downstream-Breakout-master/Adafruit USB Type C Downstream Breakout rev B.brd

## EAGLE design PCB/Schematics/Adafruit-USB-C-Downstream-Breakout-master/Adafruit USB Type C Downstream Breakout rev B.brd (2026-06-11)

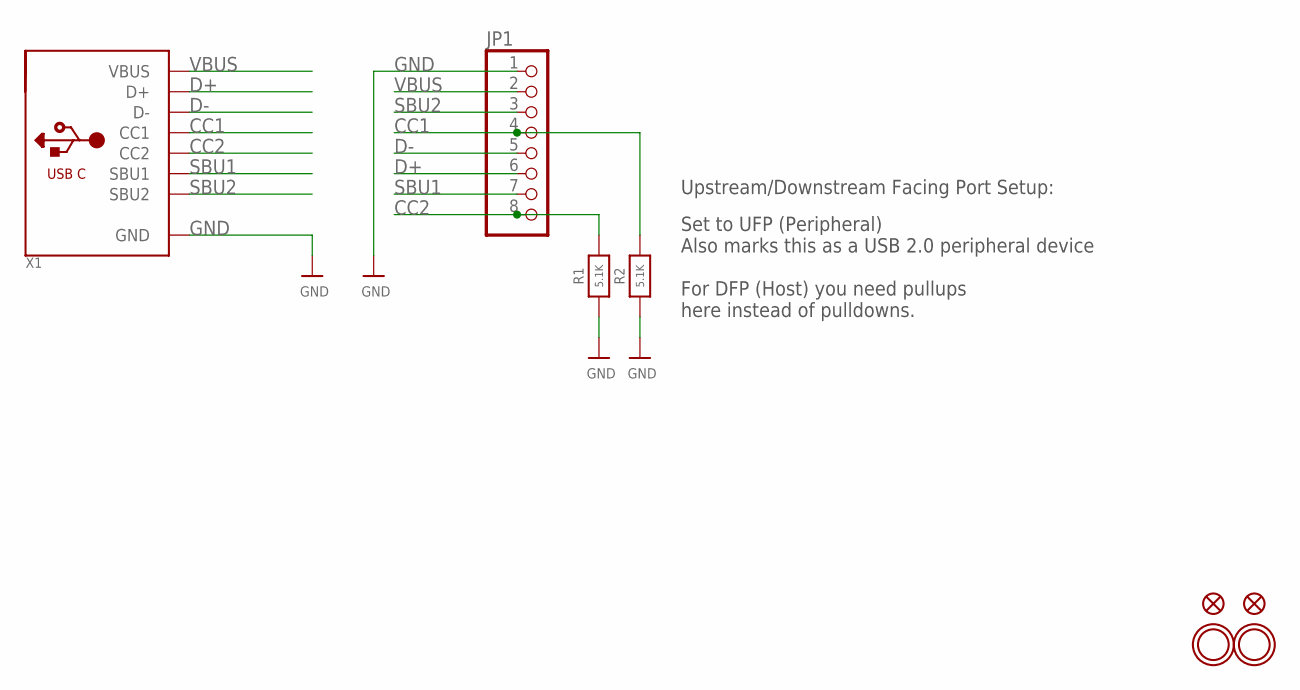
[picture p127: schematic Adafruit USB Type C Downstream Breakout rev B.sch]

Parts:
FID1, FID2: FIDUCIAL_1MM
JP1: HEADER-1X876MIL; 1X08_ROUND_76
R1, R2: 5.1K; 0603-NO
U$1, U$2: MOUNTINGHOLE2.5; MOUNTINGHOLE_2.5_PLATED
X1: USB_C; USB_C_CUSB31-CFM2AX-01-X

Connections:
CC1: JP1.4, R2.2, X1.A5 (CC1)
CC2: JP1.8, R1.2, X1.B5 (CC2)
D+: JP1.6, X1.A6 (D+), X1.B6 (D+)
D-: JP1.5, X1.A7 (D-), X1.B7 (D-)
GND: JP1.1, R1.1, R2.1, X1.A1B12 (GND), X1.B1A12 (GND)
SBU1: JP1.7, X1.A8 (SBU1)
SBU2: JP1.3, X1.B8 (SBU2)
VBUS: JP1.2, X1.A4B9 (VBUS), X1.B4A9 (VBUS)

Notes on the sheet:
Set to UFP (Peripheral) Also marks this as a USB 2.0 peripheral device For DFP (Host) you need pullups here instead of pulldowns.
Upstream/Downstream Facing Port Setup:

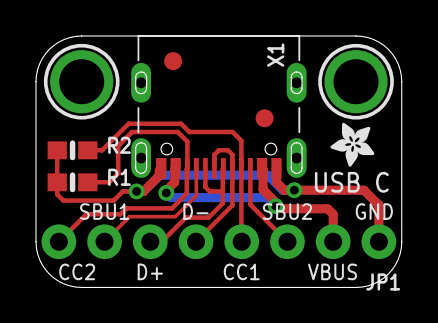
[picture p128: board Adafruit USB Type C Downstream Breakout rev B.brd from above]

Board: 2 copper layers, 20.3 x 14.0 mm, 10 parts (1 on the bottom side), 8 nets.

Other parts of the board:
U$3: ADAFRUIT_2.5MM
U$8: PCBFEAT-REV-040
