LaphyB/senior-project/PCB/Schematics/2-axis-joystick-breakout-board-with-mounting-holes-master/joystick.brd

## EAGLE design PCB/Schematics/2-axis-joystick-breakout-board-with-mounting-holes-master/joystick.brd (2026-06-11)

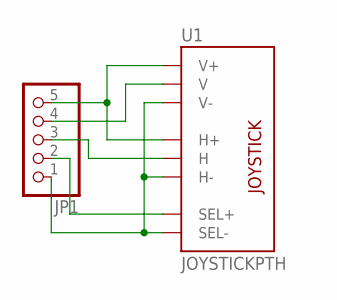
[picture p129: schematic joystick.sch]

Parts:
JP1: PINHD-1X5; 1X05
U1: JOYSTICKPTH; JOYSTICK

Connections:
unnamed: JP1.5, U1.H1 (H+), U1.V1 (V+)
unnamed: JP1.1, U1.B2A (SEL-), U1.H3 (H-), U1.V3 (V-)
unnamed: JP1.4, U1.V2 (V)
unnamed: JP1.3, U1.H2 (H)
unnamed: JP1.2, U1.B1A (SEL+)

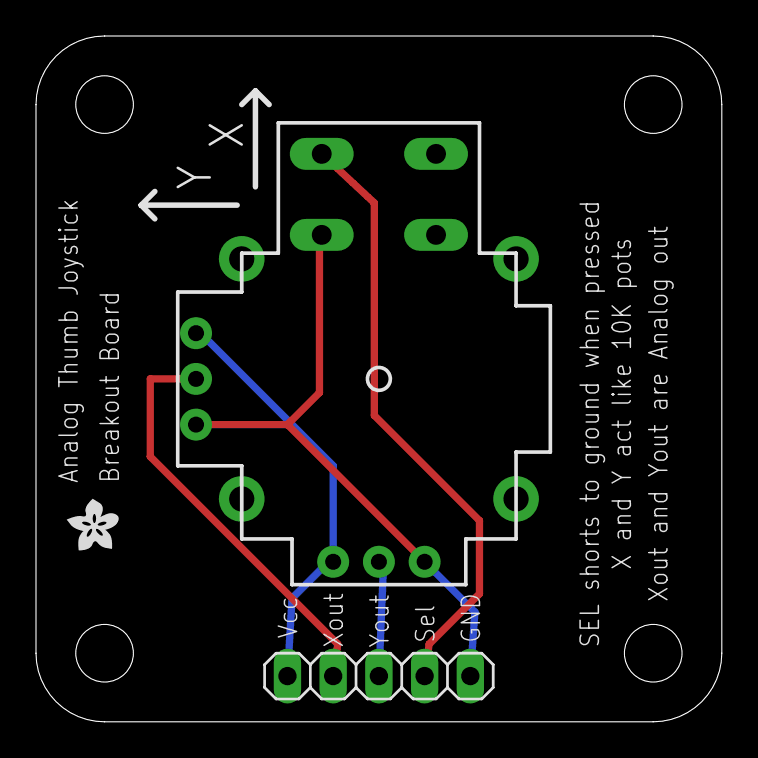
[picture p130: board joystick.brd from above]

Board: 2 copper layers, 38.1 x 38.1 mm, 3 parts (0 on the bottom side), 5 nets.

Other parts of the board:
U$1: ADAFRUIT200MIL
