LaphyB/senior-project/PCB/Schematics/Adafruit-ICM20948-PCB-master/Adafruit ICM20948.brd

## EAGLE design PCB/Schematics/Adafruit-ICM20948-PCB-master/Adafruit ICM20948.brd (2026-06-11)

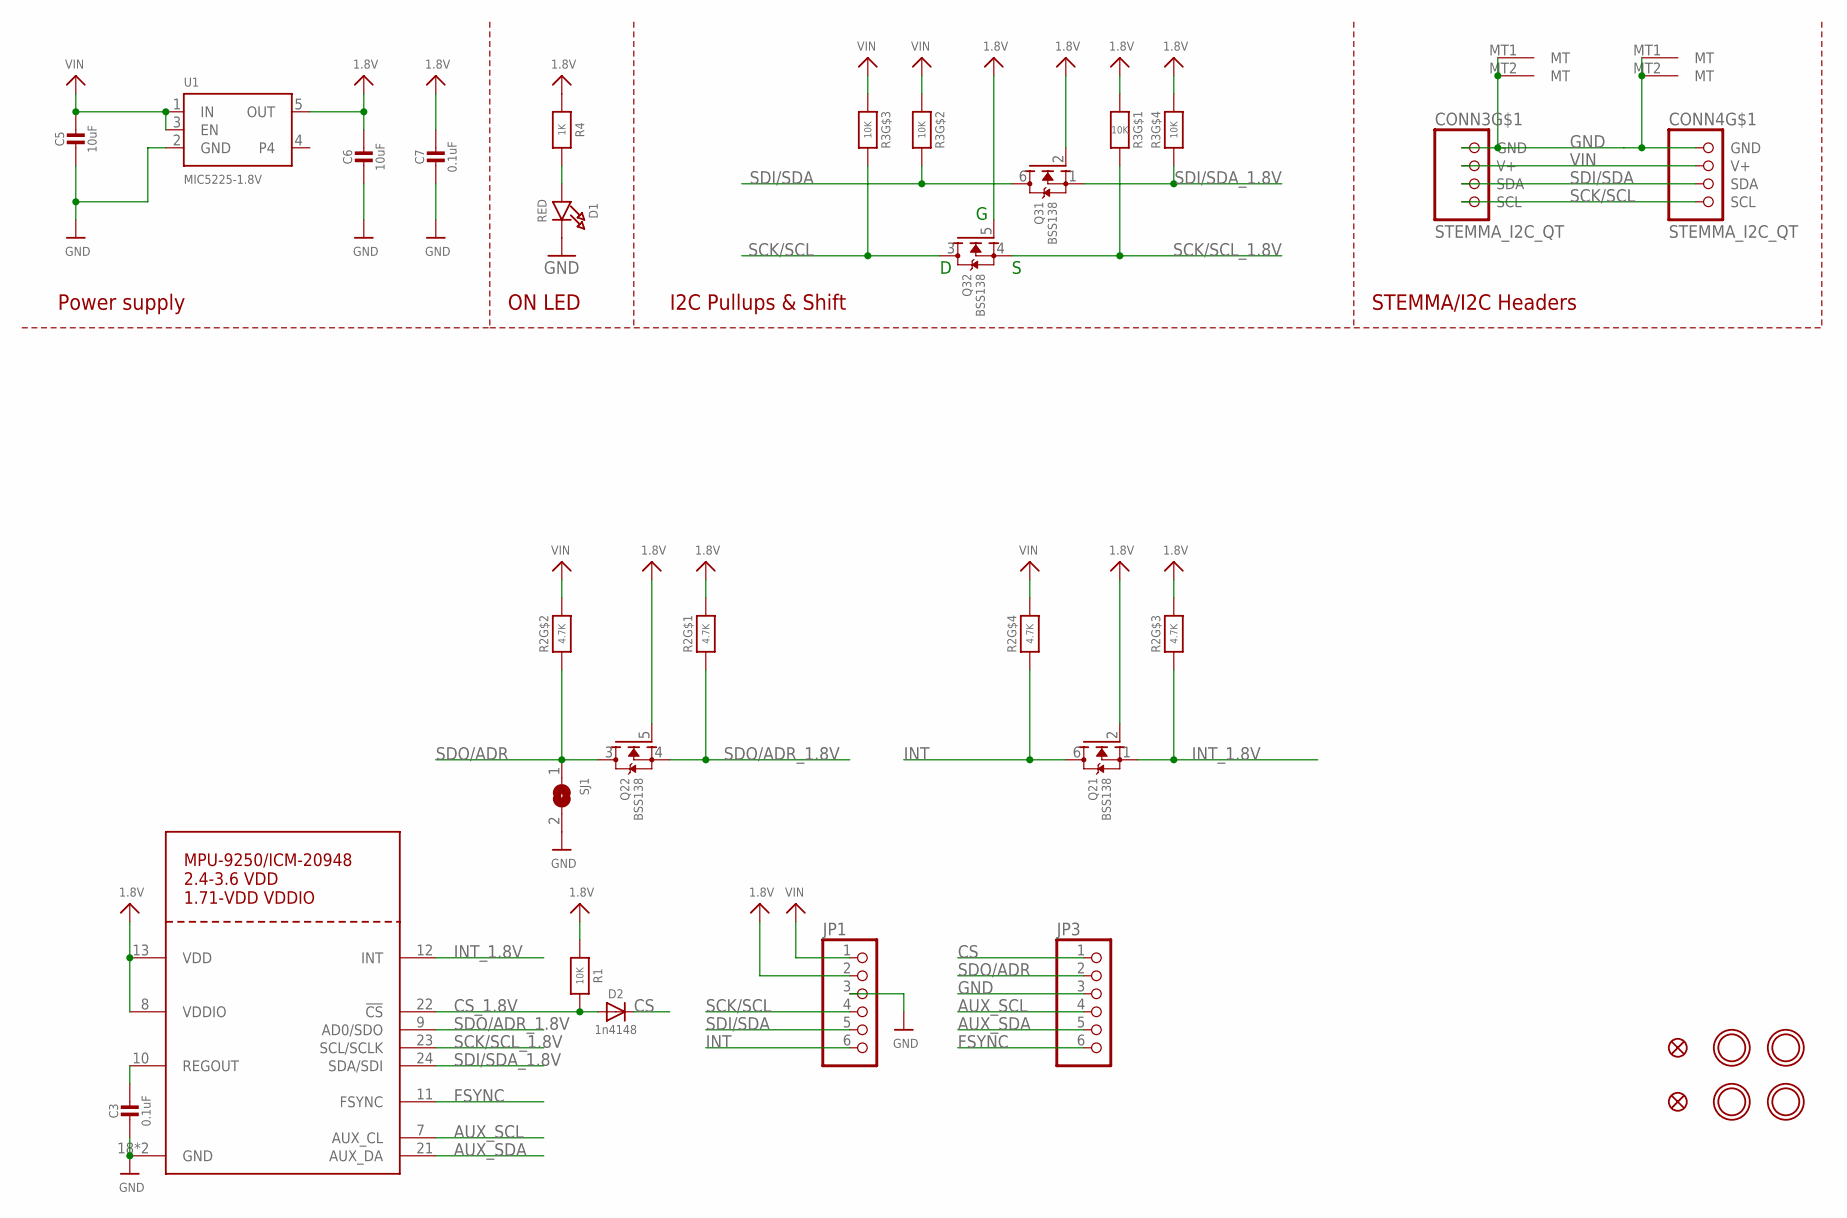
[picture p131: schematic Adafruit ICM20948.sch]

Parts:
C3, C7: 0.1uF; 0603-NO
C5, C6: 10uF; 0805-NO
CONN3, CONN4: STEMMA_I2C_QT; JST_SH4
D1: RED; CHIPLED_0603_NOOUTLINE
D2: 1n4148; SOD-323_MINI
FID2, FID4: FIDUCIAL_1MM
JP1, JP3: HEADER-1X670MIL; 1X06_ROUND_70
Q2, Q3: BSS138; SOT363
R1: 10K; 0603-NO
R2: 4.7K; RESPACK_4X0603
R3: 10K; RESPACK_4X0603
R4: 1K; 0603-NO
SJ1: SOLDERJUMPER; SOLDERJUMPER_ARROW_NOPASTE
U1: MIC5225-1.8V; SOT23-5
U$21: MPU-9250_ICM20948; QFN24_3MM_NOEP
U$38, U$39, U$41, U$42: MOUNTINGHOLE2.5; MOUNTINGHOLE_2.5_PLATED

Connections:
1.8V: C6.1, C7.1, JP1.2, Q2.2 (G), Q2.5 (G), Q3.2 (G), Q3.5 (G), R1.1, R2.6 (2), R2.8 (2), R3.4 (1), R3.8 (2), R4.1, U1.5 (OUT), U$21.8 (VDDIO), U$21.13 (VDD)
AUX_SCL: JP3.4, U$21.7 (AUX_CL)
AUX_SDA: JP3.5, U$21.21 (AUX_DA)
CS: D2.C, JP3.1
CS_1.8V: D2.A, R1.2, U$21.22 (!CS)
FSYNC: JP3.6, U$21.11 (FSYNC)
GND: C3.2, C5.2, C6.2, C7.2, CONN3.1 (GND), CONN3.MT1 (MT), CONN3.MT2 (MT), CONN4.1 (GND), CONN4.MT1 (MT), CONN4.MT2 (MT), D1.C, JP1.3, JP3.3, SJ1.2, U1.2 (GND), U$21.18 (GND), U$21.20 (GND)
INT: JP1.6, Q2.6 (D), R2.4 (1)
INT_1.8V: Q2.1 (S), R2.3 (1), U$21.12 (INT)
unnamed: D1.A, R4.2
REGOUT: C3.1, U$21.10 (REGOUT)
SCK/SCL: CONN3.4 (SCL), CONN4.4 (SCL), JP1.4, Q3.3 (D), R3.6 (2)
SCK/SCL_1.8V: Q3.4 (S), R3.1, U$21.23 (SCL/SCLK)
SDI/SDA: CONN3.3 (SDA), CONN4.3 (SDA), JP1.5, Q3.6 (D), R3.7 (2)
SDI/SDA_1.8V: Q3.1 (S), R3.5 (2), U$21.24 (SDA/SDI)
SDO/ADR: JP3.2, Q2.3 (D), R2.2 (1), SJ1.1
SDO/ADR_1.8V: Q2.4 (S), R2.1, U$21.9 (AD0/SDO)
VIN: C5.1, CONN3.2 (V+), CONN4.2 (V+), JP1.1, R2.5 (2), R2.7 (2), R3.2 (1), R3.3 (1), U1.1 (IN), U1.3 (EN)

Notes on the sheet:
I2C Pullups & Shift
STEMMA/I2C Headers
ON LED
Power supply

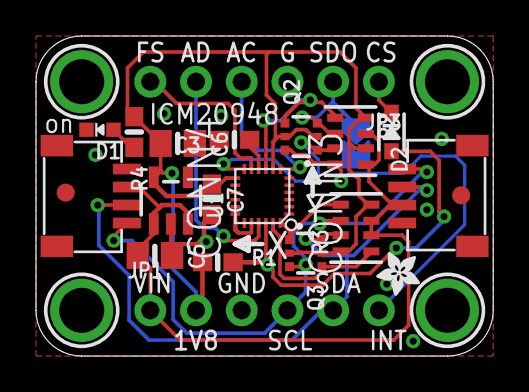
[picture p132: board Adafruit ICM20948.brd from above]

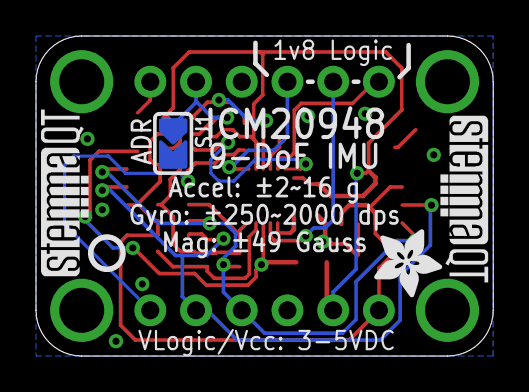
[picture p133: board Adafruit ICM20948.brd from below]

Board: 2 copper layers, 25.4 x 17.8 mm, 30 parts (5 on the bottom side), 18 nets.

Other parts of the board:
U$2: ADAFRUIT_2.5MM
U$12: ADAFRUIT_3.5MM
U$45: PCBFEAT-REV-040
U$46, U$47: STEMMAQT
