LaphyB/senior-project/Software/FullTest/Core/Src/main.c

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
/* Includes ------------------------------------------------------------------*/
#include "main.h"
#include "app_fatfs.h"

/* USER CODE BEGIN Includes */

#include <stdio.h>
#include "icm20948.h"
#include "stm32_seq.h"
#include "hids_app.h"

#include "config.h"
#include "pins.h"

#include "buttons.h"
#include "led.h"
#include "motor.h"
#include "gesture_detector.h"
#include "adaptive_analyzer.h"
#include "gyro_to_mouse.h"
#include "sensor_data.h"
#include "gyro_filters.h"

/* USER CODE END Includes */


ADC_HandleTypeDef hadc1;

DMA_HandleTypeDef hdma_adc1;

I2C_HandleTypeDef hi2c1;

IPCC_HandleTypeDef hipcc;

RNG_HandleTypeDef hrng;

RTC_HandleTypeDef hrtc;

SPI_HandleTypeDef hspi1;

UART_HandleTypeDef huart1;

/* USER CODE BEGIN PV */

ICM20948_Data_t imu_data;

MagData_t mag_data;

/* USER CODE END PV */

void SystemClock_Config(void);
void PeriphCommonClock_Config(void);
static void MX_RF_Init(void);
static void MX_GPIO_Init(void);
static void MX_DMA_Init(void);
static void MX_ADC1_Init(void);
static void MX_I2C1_Init(void);
static void MX_SPI1_Init(void);
static void MX_IPCC_Init(void);
static void MX_RNG_Init(void);
static void MX_RTC_Init(void);
static void MX_USART1_UART_Init(void);
/* USER CODE BEGIN PFP */

void TakeData(SensorData_t *datastruct);
void PrintDisplay(SensorData_t *data, bool blockHID, MousePos_t mouse_pos, GestureType_t gesture);
void PrintAnalyzerView(void);
void PrintLogView(void);

/* USER CODE END PFP */

/* USER CODE BEGIN 0 */

volatile uint16_t adc_results[4] __attribute__((aligned(32)));

/* USER CODE END 0 */

/**
  * @brief  The application entry point.
  * @retval int
  */
int main(void)
{
    HAL_Init();
    MX_APPE_Config();

    SystemClock_Config();
    PeriphCommonClock_Config();
    MX_IPCC_Init();

    MX_RF_Init();
    MX_GPIO_Init();
    MX_DMA_Init();
    MX_ADC1_Init();
    MX_I2C1_Init();
    MX_SPI1_Init();
    if (MX_FATFS_Init() != APP_OK)
    {
        Error_Handler();
    }
    MX_RNG_Init();
    MX_RTC_Init();
    MX_USART1_UART_Init();

    MX_APPE_Init();

    /* USER CODE BEGIN WHILE */

    printf("\033[2J\033[H");

    printf("Setting up device...\r\n");

    extern FATFS USERFatFs;
    extern FIL   USERFile;
    extern char  USERPath[4];

    printf("Loading Initial Configs...\r\n");
    Config_Init();
    printf("Initial Configs Loaded!\r\n");

    printf("\r\nCalibrating ADC...\r\n");
    if (HAL_ADCEx_Calibration_Start(&hadc1, ADC_SINGLE_ENDED) != HAL_OK)
    {
        printf("ADC Calibration failed!\r\n");
        while(1);
    }
    printf("ADC calibrated successfully!\r\n");

    printf("Starting DMA...\r\n");
    if (HAL_ADC_Start_DMA(&hadc1, (uint32_t*)adc_results, 4) != HAL_OK)
    {
        printf("DMA start failed!\r\n");
        while(1);
    }
    printf("DMA started successfully!\r\n");

    /*
    HAL_Delay(100);

    int32_t sum_js1_x = 0, sum_js1_y = 0, sum_js2_x = 0, sum_js2_y = 0;
    uint32_t sample_count = 0;

    uint32_t start_time = HAL_GetTick();
    while (HAL_GetTick() - start_time < 1000)
    {
        sum_js1_x += adc_results[0];
        sum_js1_y += adc_results[1];
        sum_js2_x += adc_results[2];
        sum_js2_y += adc_results[3];
        sample_count++;
        HAL_Delay(10);
    }

    if (sample_count > 0)
    {
        float avg_js1_x = (float)sum_js1_x / sample_count;
        float avg_js1_y = (float)sum_js1_y / sample_count;
        float avg_js2_x = (float)sum_js2_x / sample_count;
        float avg_js2_y = (float)sum_js2_y / sample_count;

        printf("--- Joystick Neutral Position (avg over %lu samples) ---\r\n", (unsigned long)sample_count);
        printf("JS1 X:%6.1f Y:%6.1f\r\n", avg_js1_x, avg_js1_y);
        printf("JS2 X:%6.1f Y:%6.1f\r\n", avg_js2_x, avg_js2_y);

    }
    printf("\r\n");*/

    printf("Initializing ICM-20948...\r\n");
    if (ICM20948_Init(&hi2c1) != HAL_OK)
    {
        printf("ICM-20948 initialization failed!\r\n");
    }
    printf("ICM-20948 initialized successfully!\r\n");

    // Test 1.1 - WHO_AM_I check
    uint8_t who_am_i;
    if (ICM20948_WhoAmI(&hi2c1, &who_am_i) == HAL_OK)
    {
        printf("WHO_AM_I = 0x%02X (expected 0xEA) -> %s\r\n",
            who_am_i, (who_am_i == 0xEA) ? "PASS" : "FAIL");
    }
    else
    {
        printf("WHO_AM_I read failed -> FAIL\r\n");
    }

    printf("Initializing magnetometer...\r\n");
    if (ICM20948_InitMagnetometer(&hi2c1) != HAL_OK)
    {
        printf("Magnetometer initialization failed!\r\n");
    }
    printf("Magnetometer ready!\r\n");

    /* Test 1.2/1.3/1.4 - Average sensor values at rest over 5 seconds
    printf("--- Averaging Sensor Values at Rest (5s) ---\r\n");

    int32_t sum_gyro_x = 0, sum_gyro_y = 0, sum_gyro_z = 0;
    int32_t sum_accel_x = 0, sum_accel_y = 0, sum_accel_z = 0;
    float   sum_mag_x = 0, sum_mag_y = 0, sum_mag_z = 0;
    uint32_t sample_count = 0;

    ICM20948_Data_t test_data;
    MagData_t       test_mag;

    uint32_t start_time = HAL_GetTick();
    while (HAL_GetTick() - start_time < 5000)
    {
        if (ICM20948_ReadAll(&hi2c1, &test_data) == HAL_OK)
        {
            sum_gyro_x  += test_data.gyro_x;
            sum_gyro_y  += test_data.gyro_y;
            sum_gyro_z  += test_data.gyro_z;
            sum_accel_x += test_data.accel_x;
            sum_accel_y += test_data.accel_y;
            sum_accel_z += test_data.accel_z;

            if (ICM20948_ReadMagnetometer(&hi2c1, &test_mag) == HAL_OK)
            {
                sum_mag_x += test_mag.x_ut;
                sum_mag_y += test_mag.y_ut;
                sum_mag_z += test_mag.z_ut;
            }

            sample_count++;
        }
        HAL_Delay(10);
    }

    if (sample_count > 0)
    {
        printf("Samples: %lu\r\n", (unsigned long)sample_count);
        printf("Gyro  AVG X:%6.1f Y:%6.1f Z:%6.1f\r\n",
            (float)sum_gyro_x / sample_count,
            (float)sum_gyro_y / sample_count,
            (float)sum_gyro_z / sample_count);
        printf("Accel AVG X:%6.1f Y:%6.1f Z:%6.1f\r\n",
            (float)sum_accel_x / sample_count,
            (float)sum_accel_y / sample_count,
            (float)sum_accel_z / sample_count);
        printf("Mag   AVG X:%7.2f Y:%7.2f Z:%7.2f uT\r\n",
            sum_mag_x / sample_count,
            sum_mag_y / sample_count,
            sum_mag_z / sample_count);
    }
    else
    {
        printf("No samples collected\r\n");
    }
    printf("\r\n");*/



    printf("Initializing SDCard Reader and Data Logger...\r\n");
    DataLogger_Init(&USERFatFs, &USERFile, USERPath);
    DataLogger_LoadConfig();
    printf("SDCard Reader and Data Logger ready!\r\n");

    printf("Initializing modules...\r\n");
    GestureDetector_Init();

    printf("Initializing Variables...\r\n");
    static uint32_t last_led_toggle = 0;
    static bool     motor_triggered = false;
    static uint8_t  display_page    = 0;
    static float    smooth_gyro_x   = 0.0f;
    static float    smooth_gyro_y   = 0.0f;
    static float    smooth_gyro_z   = 0.0f;
    static float    smooth_mag_x    = 0.0f;
    static float    smooth_mag_y    = 0.0f;
    static float    smooth_mag_z    = 0.0f;
    static bool     first           = true;
    static bool     blockHID        = false;
    SensorData_t    sensor_data;

    printf("Entering Main Loop!\r\n");

    /* USER CODE END 2 */

    while (1)
    {
        /* USER CODE END WHILE */

        MX_APPE_Process();
        UTIL_SEQ_Run(UTIL_SEQ_DEFAULT);

        /* USER CODE BEGIN 3 */

        // Update timers
        DataLogger_Update();
        setMotorTimed_Update();

        // Heartbeat LED
        if (HAL_GetTick() - last_led_toggle >= 500)
        {
            toggleLED();
            last_led_toggle = HAL_GetTick();
        }

        // Read all sensor data
        TakeData(&sensor_data);

        // Gyro bias correction
        sensor_data.gyro_x -= (int16_t)gyro_bias_x;
        sensor_data.gyro_y -= (int16_t)gyro_bias_y;

        // BUTTON5 - block HID
        // BUTTON5 - toggle HID block
        static bool btn5_last = true;
        bool btn5_now = sensor_data.buttons.BUTTON5;
        if (btn5_last == false && btn5_now == true)
        {
            blockHID = !blockHID;
        }
        btn5_last = btn5_now;

        // BUTTON6 - haptic feedback
        if (!sensor_data.buttons.BUTTON6)
        {
            if (!motor_triggered)
            {
                setMotorTimed(BOTH, 1000);
                motor_triggered = true;
            }
        }
        else
        {
            motor_triggered = false;
        }

        // JS1 - run adaptive analyzer
        static bool js1_last = true;
        bool js1_now = sensor_data.buttons.JOYSTICKBUTTON1;
        if (js1_last == false && js1_now == true)
        {
            AdaptiveAnalyzer_Run();
        }
        js1_last = js1_now;

        // JS2 - break config for demo
        static bool js2_last = true;
        bool js2_now = sensor_data.buttons.BUTTON2;
        if (js2_last == false && js2_now == true)
        {
            AdaptiveAnalyzer_BreakConfig();
        }
        js2_last = js2_now;

        // BUTTON4 - cycle display page
        static bool btn4_last = true;
        bool btn4_now = sensor_data.buttons.BUTTON4;
        if (btn4_last == false && btn4_now == true)
        {
            display_page = (display_page + 1) % 4;
            printf("\033[2J\033[H");
        }
        btn4_last = btn4_now;

        // Gesture detection and haptic feedback
        GestureType_t gesture = GestureDetector_Update(&sensor_data);
        if (gesture != GESTURE_NONE)
        {
            switch (gesture)
            {
                case GESTURE_NONE:       break;
                case GESTURE_FLICK_LEFT:  setMotorTimed(BOTH, 100); break;
                case GESTURE_FLICK_RIGHT: setMotorTimed(BOTH, 100); break;
                case GESTURE_FLICK_UP:    setMotorTimed(BOTH, 100); break;
                case GESTURE_FLICK_DOWN:  setMotorTimed(BOTH, 100); break;
                case GESTURE_ROTATE_CW:   setMotorTimed(BOTH, 100); break;
                case GESTURE_ROTATE_CCW:  setMotorTimed(BOTH, 100); break;
            }
        }

        // Calculate Cursor Movement
        MousePos_t mouse_pos = GyroMouse_Update(sensor_data.mag_x, sensor_data.mag_y, sensor_data.mag_z, blockHID);

        // BLE HID mouse reports via gyroscope
		static bool  last_block = false;
		static float accum_x    = 0.0f;
		static float accum_y    = 0.0f;

		if (last_block && !blockHID)
			HIDSAPP_SendMouseReport(0, 0, 0);
		last_block = blockHID;

		if (!blockHID)
		{
			float sg_x, sg_y;
			GyroMouse_GetSmoothedGyro(sensor_data.gyro_x, sensor_data.gyro_y, &sg_x, &sg_y);

			accum_x += -sg_y / 1500.0f;
			accum_y +=  sg_x / 1500.0f;

			if (accum_x >  20.0f) accum_x =  20.0f;
			if (accum_x < -20.0f) accum_x = -20.0f;
			if (accum_y >  20.0f) accum_y =  20.0f;
			if (accum_y < -20.0f) accum_y = -20.0f;

			int8_t report_x = (int8_t)accum_x;
			int8_t report_y = (int8_t)accum_y;

			accum_x -= report_x;
			accum_y -= report_y;

			//printf("Sending HID Report: X = %f, Y = %f\r\n", accum_x, accum_y);
			HIDSAPP_SendMouseReport(report_x, report_y, 0);
		}

        // Display
        switch (display_page)
        {
            case 0: break;
            case 1: PrintDisplay(&sensor_data, blockHID, mouse_pos, gesture); break;
            case 2: PrintAnalyzerView(); break;
            case 3: PrintLogView(); break;
        }
    }
    /* USER CODE END 3 */
}

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
/* USER CODE BEGIN 4 */

int __io_putchar(int ch)
{
    HAL_UART_Transmit(&huart1, (uint8_t*)&ch, 1, HAL_MAX_DELAY);
    return ch;
}

void TakeData(SensorData_t *datastruct)
{
	datastruct->timestamp_ms = HAL_GetTick();

	datastruct->buttons = ReadButtons();

	datastruct->js1_x = adc_results[0];
	datastruct->js1_y = adc_results[1];
	datastruct->js2_x = adc_results[2];
	datastruct->js2_y = adc_results[3];

	if(ICM20948_ReadAll(&hi2c1, &imu_data) == HAL_OK)
	{
		datastruct->gyro_x = imu_data.gyro_x;
		datastruct->gyro_y = imu_data.gyro_y;
		datastruct->gyro_z = imu_data.gyro_z;

		datastruct->accel_x = imu_data.accel_x;
		datastruct->accel_y = imu_data.accel_y;
		datastruct->accel_z = imu_data.accel_z;

		if(ICM20948_ReadMagnetometer(&hi2c1, &mag_data) == HAL_OK)
		{
			datastruct->mag_x = mag_data.x_ut;
			datastruct->mag_y = mag_data.y_ut;
			datastruct->mag_z = mag_data.z_ut;
		}
	}
}

void PrintDisplay(SensorData_t *data, bool blockHID, MousePos_t mouse_pos, GestureType_t gesture)
{
    static GestureType_t last_gesture      = GESTURE_NONE;
    static uint32_t      last_gesture_time = 0;

    if (gesture != GESTURE_NONE)
    {
        last_gesture      = gesture;
        last_gesture_time = HAL_GetTick();
    }

    uint32_t time_since = last_gesture_time == 0 ? 0 : HAL_GetTick() - last_gesture_time;

    printf("\033[1;1H[ BUTTONS ]\033[K");
    printf("\033[2;1HBTN1:%s BTN2:%s BTN3:%s\033[K", data->buttons.BUTTON1 ? "UP" : "DN", data->buttons.BUTTON2 ? "UP" : "DN", data->buttons.BUTTON3 ? "UP" : "DN");
    printf("\033[3;1HBTN4:%s BTN5:%s BTN6:%s\033[K", data->buttons.BUTTON4 ? "UP" : "DN", data->buttons.BUTTON5 ? "UP" : "DN", data->buttons.BUTTON6 ? "UP" : "DN");
    printf("\033[4;1HJS1:%s JS2:%s HID:%s\033[K",    data->buttons.JOYSTICKBUTTON1 ? "UP" : "DN", data->buttons.JOYSTICKBUTTON2 ? "UP" : "DN", blockHID ? "BLK" : "ON ");

    printf("\033[6;1H[ JOYSTICKS ]\033[K");
    printf("\033[7;1HJS1 X:%4d Y:%4d\033[K", data->js1_x, data->js1_y);
    printf("\033[8;1HJS2 X:%4d Y:%4d\033[K", data->js2_x, data->js2_y);

    printf("\033[10;1H[ SENSORS ]\033[K");
    printf("\033[11;1HGyro  X:%7.1f Y:%7.1f Z:%7.1f\033[K", (float)data->gyro_x, (float)data->gyro_y, (float)data->gyro_z);
    printf("\033[12;1HAccel X:%7d Y:%7d Z:%7d\033[K",       data->accel_x, data->accel_y, data->accel_z);
    printf("\033[13;1HMag   X:%7.2f Y:%7.2f Z:%7.2f uT\033[K", data->mag_x, data->mag_y, data->mag_z);

    printf("\033[15;1H[ MOUSE ]\033[K");
    printf("\033[16;1HX:%4d Y:%4d\033[K", mouse_pos.x, mouse_pos.y);

    printf("\033[18;1H[ GESTURE ]\033[K");
    if (last_gesture == GESTURE_NONE)
        printf("\033[19;1HNone yet\033[K");
    else
        printf("\033[19;1H%-15s %lums ago\033[K", GestureDetector_Gesturetostring(last_gesture), (unsigned long)time_since);
}

void PrintAnalyzerView(void)
{
    printf("\033[1;1H[ ANALYZER ]\033[K");
    printf("\033[2;1HThresh:%8.1f  Window:%lums  Frac:%.2f\033[K",
        gesture_magnitude_threshold,
        (unsigned long)gesture_detection_window_ms,
        gesture_peak_fraction);
    printf("\033[3;1HBias X:%8.1f  Bias Y:%8.1f\033[K", gyro_bias_x, gyro_bias_y);
    printf("\033[5;1H[ GESTURE STATE ]\033[K");
    printf("\033[6;1HState:%-12s  Peak:%8.1f\033[K",
        GestureDetector_StateToString(GestureDetector_GetState()),
        GestureDetector_GetPeakMagnitude());
    printf("\033[8;1H[ ANALYZER OUTPUT ]\033[K");
}

void PrintLogView(void)
{
    static GestureLogEntry_t     g[3];
    static AnalyzerChangeEntry_t a[3];

    uint32_t gc = DataLogger_GetLastGestureEntries(g, 3);
    uint32_t ac = DataLogger_GetLastAnalyzerEntries(a, 3);

    printf("\033[1;1H[ CONFIG ]\033[K");
    printf("\033[2;1HThresh:%.0f  Win:%lums  Frac:%.2f\033[K",
        gesture_magnitude_threshold,
        (unsigned long)gesture_detection_window_ms,
        gesture_peak_fraction);

    printf("\033[4;1H[ GESTURE LOG ]\033[K");
    for (uint32_t i = 0; i < 3; i++)
    {
        if (i < gc)
            printf("\033[%d;1H%-10s  peak:%.0f  dur:%lums\033[K",
                5 + i,
                GestureDetector_Gesturetostring(g[i].gesture_result),
                g[i].peak_magnitude,
                (unsigned long)g[i].duration_ms);
        else
            printf("\033[%d;1H---\033[K", 5 + i);
    }

    printf("\033[9;1H[ ANALYZER CHANGES ]\033[K");
    for (uint32_t i = 0; i < 3; i++)
    {
        if (i < ac)
            printf("\033[%d;1HT:%.0f->%.0f  W:%lu->%lu ms\033[K",
                10 + i,
                a[i].old_threshold, a[i].new_threshold,
                (unsigned long)a[i].old_window_ms,
                (unsigned long)a[i].new_window_ms);
        else
            printf("\033[%d;1H---\033[K", 10 + i);
    }
}

/* USER CODE END 4 */
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
