LaphyB/senior-project/Software/FullTest/FullTest.ioc

Mcu.UserName=STM32WB15CCUx
PA0.Signal=ADCx_IN5
PA1.Signal=ADCx_IN6
PA10.Signal=USART1_RX
PA11.Signal=GPIO_Input
PA12.Signal=GPIO_Input
PA13.GPIO_Label=JTMS
PA13.Signal=SYS_JTMS-SWDIO
PA14.GPIO_Label=JTCK
PA14.Signal=SYS_JTCK-SWCLK
PA2.Signal=ADCx_IN7
PA3.Signal=ADCx_IN8
PA4.Signal=GPIO_Input
PA5.Signal=SPI1_SCK
PA6.Signal=GPIO_Input
PA7.Signal=SPI1_MOSI
PA8.Signal=GPIO_Input
PA9.Signal=USART1_TX
PB0.Signal=GPIO_Input
PB1.Signal=GPIO_Input
PB2.Signal=GPIO_Output
PB3.GPIO_Label=JTDO
PB3.Signal=SYS_JTDO-SWO
PB4.Signal=SPI1_MISO
PB5.Signal=GPIO_Output
PB6.Signal=I2C1_SCL
PB7.Signal=I2C1_SDA
PB8.Signal=GPIO_Output
PB9.Signal=GPIO_Output
PC14-OSC32_IN.Signal=RCC_OSC32_IN
PC15-OSC32_OUT.Signal=RCC_OSC32_OUT
PE4.Signal=GPIO_Input
