LaphyB/senior-project/Software/FullTest/Core/Inc/main.h

#define JTMS_Pin GPIO_PIN_13
#define JTMS_GPIO_Port GPIOA
#define JTCK_Pin GPIO_PIN_14
#define JTCK_GPIO_Port GPIOA
#define JTDO_Pin GPIO_PIN_3
#define JTDO_GPIO_Port GPIOB
