LaphyB/senior-project/Software/FullTest/STM32_WPAN/App/ble_conf.h

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

/* Define to prevent recursive inclusion -------------------------------------*/
#ifndef BLE_CONF_H
#define BLE_CONF_H

#include "app_conf.h"

/******************************************************************************
 *
 * BLE SERVICES CONFIGURATION
 * blesvc
 *
 ******************************************************************************/

/**
 * This setting shall be set to '1' if the device needs to support the Peripheral Role
 * In the MS configuration, both BLE_CFG_PERIPHERAL and BLE_CFG_CENTRAL shall be set to '1'
 */
#define BLE_CFG_PERIPHERAL                                                     1

/**
 * This setting shall be set to '1' if the device needs to support the Central Role
 * In the MS configuration, both BLE_CFG_PERIPHERAL and BLE_CFG_CENTRAL shall be set to '1'
 */
#define BLE_CFG_CENTRAL                                                        0

/**
 * There is one handler per service enabled
 * Note: There is no handler for the Device Information Service
 *
 * This shall take into account all registered handlers
 * (from either the provided services or the custom services)
 */
#define BLE_CFG_SVC_MAX_NBR_CB                                                 7

#define BLE_CFG_CLT_MAX_NBR_CB                                                 0

/******************************************************************************
 * GAP Service - Appearance
 ******************************************************************************/

#define BLE_CFG_UNKNOWN_APPEARANCE                  (0)
#define BLE_CFG_HR_SENSOR_APPEARANCE                (832)
#define BLE_CFG_GAP_APPEARANCE    					0x03C2

#define BLE_CFG_BAS_NUMBER                  1
#define BLE_CFG_HIDS_NUMBER                 1
#define BLE_CFG_HIDS_REPORT_MAP_MAX_LEN     52
#define BLE_CFG_HIDS_INFORMATION_LEN        4
#define BLE_CFG_HIDS_CONTROL_POINT_LEN      1
#define BLE_CFG_HIDS_INPUT_REPORT_NB        1
#define BLE_CFG_HIDS_INPUT_REPORT_MAX_LEN   4
#define BLE_CFG_HIDS_OUTPUT_REPORT_NB       0
#define BLE_CFG_HIDS_OUTPUT_REPORT_MAX_LEN  0
#define BLE_CFG_HIDS_FEATURE_REPORT_NB      0
#define BLE_CFG_HIDS_FEATURE_REPORT_MAX_LEN 0
#define BLE_CFG_HIDS_PROTOCOL_MODE          1

#define BLE_CFG_HIDS_REPORT_CHAR            1
#define BLE_CFG_HIDS_REPORT_MAX_LEN         4
#define BLE_CFG_HIDS_REPORT_REFERENCE_LEN   2
#define BLE_CFG_HIDS_INPUT_WRITE            0
#define BLE_CFG_HIDS_MOUSE_DEVICE           0
#define BLE_CFG_HIDS_KEYBOARD_DEVICE        0

#endif /*BLE_CONF_H */
