LaphyB/senior-project/Software/FullTest/Core/Inc/adaptive_analyzer.h

/*
 * adaptive_analyzer.h
 *
 *  Created on: Apr 22, 2026
 *      Author: barbe
 */

#ifndef INC_ADAPTIVE_ANALYZER_H_
#define INC_ADAPTIVE_ANALYZER_H_

#include "data_logger.h"
#include "config.h"
#include "main.h"

#include <stdio.h>
#include <math.h>

void AdaptiveAnalyzer_Run(void);
void AdaptiveAnalyzer_BreakConfig(void);

#endif
