LaphyB/senior-project/(commit log)

2026-06-11 Bringing Senior Project from Gitlab to Github
    [Adafruit ICM20948.brd, Adafruit ICM20948.sch, Adafruit PowerBoost 1000C Rev B.brd, Adafruit PowerBoost 1000C Rev B.kicad_pcb, Adafruit PowerBoost 1000C Rev B.sch, Adafruit USB Type C Downstream Breakout rev B.brd, Adafruit USB Type C Downstream Breakout rev B.sch, Arduino_Mopho_Connectors.SchDoc]
2026-06-11 Updated Code and Report
    [TopPCB.kicad_pcb]
2026-06-11 Updated PCB, 3d Models, and some Code to fix mistakes.
    [BottomPCB.kicad_pcb, ControllerButton.0001.ipt, ControllerButton.ipt, ControllerHead.0009.ipt, ControllerHead.0011.ipt, ControllerHead.ipt, TopPCB.kicad_pcb]
2026-06-14 Updated Testing Documentation and Code
    [Test Plan and Results template 2025.xlsx, Test Plan and Results.xlsx]
